ll7/scoomatic-hoverboard/README.md

# Scoomatic Hoverboard

* In [cad/](cad/) sind 3D Modelle des Scoomatics, sowie für Halterungen enthalten
* In [code/](code/) ist insbesondere der gesamte Code von ROS sowie Hoverboard Firmware und Arduino zu finden
* In [docs/](docs/) sind die Arbeiten bzw. die Dokumentationen der studentischen Arbeiten zufinden

Klonen des Repositories:

```bash
git clone --recurse-submodules https://git.rz.uni-augsburg.de/luttkule/scoomatic-hoverboard.git
```

Der Scoomatic‑Prototyp ist als modulare, softwaregestützte Mobilitätsplattform konzipiert, die die Basis eines selbstbalancierenden Fahrzeugs auf Hoverboard‑Technik demonstriert. Im Mittelpunkt steht die Verbindung aus robuster Hardware, sensorbasierter Regelung und einer klar strukturierten Steuerungslogik, um ein sicheres und nachvollziehbares Fahrverhalten zu ermöglichen.

Funktional zeigt der Prototyp vor allem drei Kernfähigkeiten: Stabilisierung, steuerbare Bewegung und Systemüberwachung. Die Stabilisierung sorgt dafür, dass das Fahrzeug Lastwechsel und kleine Störungen ausgleichen kann. Die Bewegungssteuerung erlaubt ein kontrolliertes Anfahren, Bremsen und Lenken im Rahmen der prototypischen Einsatzgrenzen. Ergänzend werden Betriebszustände des Systems erfasst, sodass Entwicklungs‑ und Testdaten für Optimierungsschritte verfügbar sind.

Ein weiterer Schwerpunkt ist die Entwicklungsfreundlichkeit. Der Scoomatic‑Prototyp ist so aufgebaut, dass Komponenten und Software iterativ weiterentwickelt werden können. Das unterstützt schnelle Tests, reproduzierbare Versuche und eine klare Trennung zwischen Basisfunktionen und experimentellen Erweiterungen. Dadurch eignet sich das Projekt sowohl als Technologie‑Demonstrator als auch als Grundlage für spätere Produktentscheidungen.

Aus Anwendersicht steht beim aktuellen Stand weniger die Endkunden‑Featuretiefe im Vordergrund, sondern die verlässliche technische Machbarkeit: Wie gut funktioniert das Zusammenspiel aus Antrieb, Regelung und Sicherheitsmechanismen unter realen Bedingungen? Genau hier liefert Scoomatic einen greifbaren Mehrwert, weil der Prototyp nicht nur theoretische Konzepte beschreibt, sondern sie praktisch erprobt.

Insgesamt präsentiert sich Scoomatic als fokussierter, praxisnaher Prototyp mit klarer Entwicklungsrichtung: ein intelligentes, balancierendes Mikromobilitäts‑System, das schrittweise von einer belastbaren technischen Basis zu einem ausgereiften Produkt weitergeführt werden kann.

## Martin Schörner @schoerma

*Bearbeitungszeitraum: 2018-12 bis 2019-05

Branch: master

Tag: MartinSchoernerFinal

[Seminararbeit Dokumentation](docs/seminar-ms/index.md)

[Projektmodul Dokumentation](docs/projektmodul-ms/index.md)

## Henri Chilla @chillahe

Bearbeitungszeitraum: 2019-11 bis 2020-03

Die von Henri verwendeten Branches beginnen mit hc:

Branch: hc/

[Bachelorarbeit Übersicht](docs/bachelor-hc/README.md)

[Dokumentation](docs/bachelor-hc/Documentation.md)

## Markus Keppeler @keppelma

Bearbeitungszeitraum: 2021-04 bis 2021-09

Der abschließende Stand befindet sich auf dem Branch *master*. \
Durch die Vielzahl an Änderungen wurden nicht mehr benötigte oder logisch doppelte Code- und Konfigurationdateien gelöscht. Der Stand vor den Anpassungen ist auf dem Branch *legacy/ros1* festgehalten.

[Dokumentation](docs/projektmodul-mk/README.md)
