ll7/scoomatic-hoverboard/docs/access_data.md

# Access data

## Jetson Board

**user data:**
- Host name: scoomatic-jetson
- User: scoomatic
- Password: nvidia

**VNC:**
- Password: scoomatic

## Raspberry Pi:

**user data:**
- Host name: ubuntu
- User: ubuntu
- Password: notubuntu

## Hotspot

- SSID: scoomatic-mobile
- No password required
