ll7/scoomatic-hoverboard/docs/bachelor-hc/BA-Präsentation-Henri-Chilla.pdf

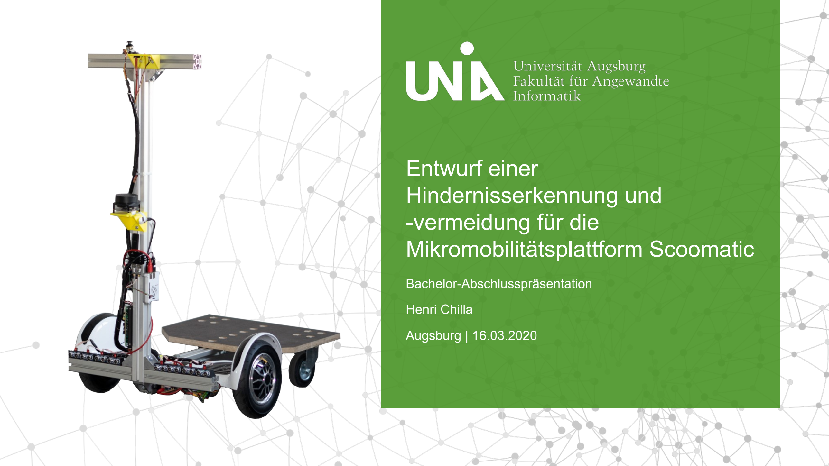
[picture p58: page 1]

## Entwurf einer Hindernisserkennung und -vermeidung für die Mikromobilitätsplattform Scoomatic

Bachelor-Abschlusspräsentation

Henri Chilla

Augsburg | 16.03.2020

## Agenda

### 1 Einleitung

### 2 Projektziel

### 3 Sensoren

### 4 SLAM

### 5 Lokalisierung und Navigation

### 6 Systemaufbau

### 7 Testing

### 8 Fazit

2 | 16.03.2020 | Bachelor Abschlusspräsentation Henri Chilla

### 9 Ausblick

## Einleitung

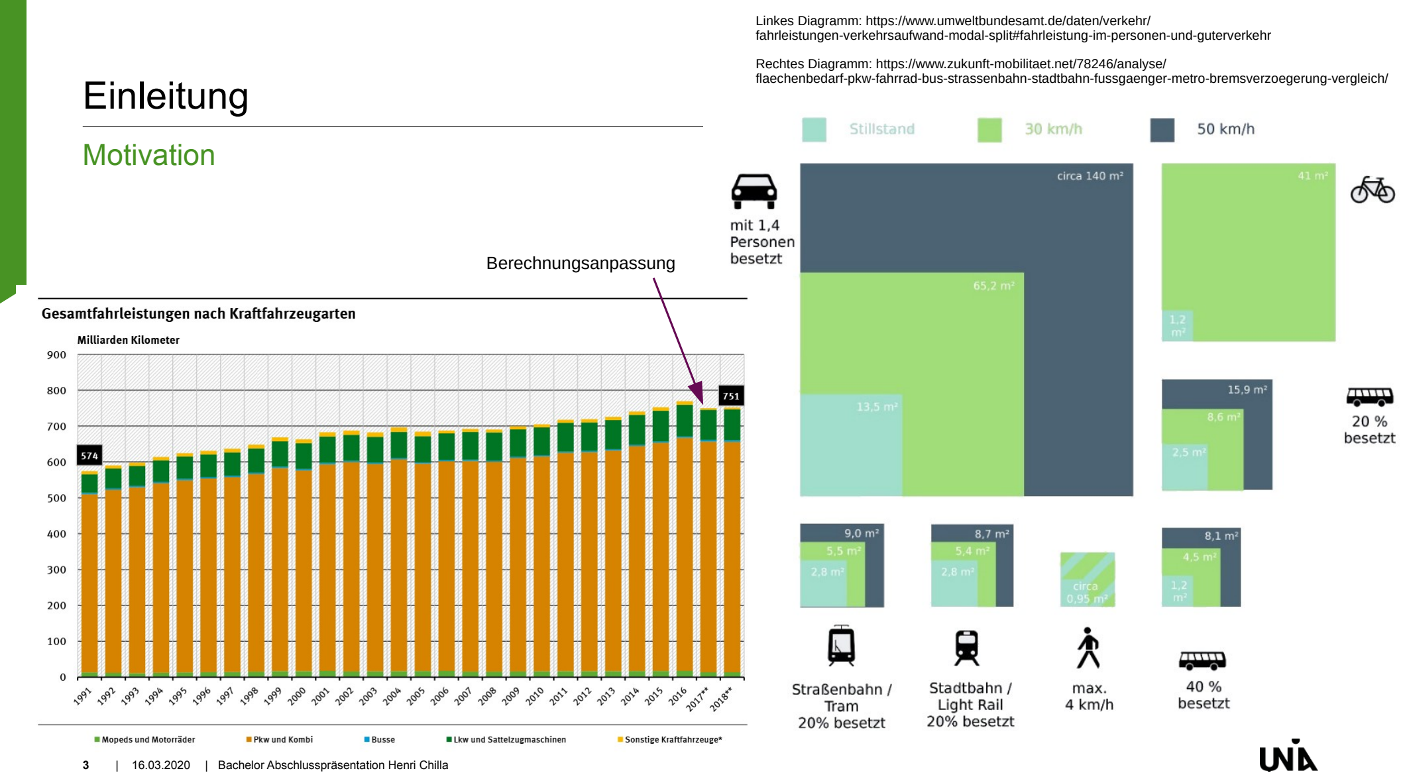
[picture p59: page 3]

Motivation

3 | 16.03.2020 | Bachelor Abschlusspräsentation Henri Chilla

Rechtes Diagramm: https://www.zukunft-mobilitaet.net/78246/analyse/flaechenbedarf-pkw-fahrrad-bus-strassenbahn-stadtbahn-fussgaenger-metro-bremsverzoegerung-vergleich/

Berechnungsanpassung

Linkes Diagramm: https://www.umweltbundesamt.de/daten/verkehr/fahrleistungen-verkehrsaufwand-modal-split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

## Einleitung

- Landflucht & Mobilität steigt in Deutschland
- Problematik des KFZ Verkehr
– | Verkehrsstau
– | Umweltverschmutzung
– | Flächenverbrauch
- Probleme mit E-Scootern und Verwandten Konzepte

Motivation

4 | 16.03.2020 | Bachelor Abschlusspräsentation Henri Chilla

## Einleitung

Motivation

5 | 16.03.2020 | Bachelor Abschlusspräsentation Henri Chilla

# Lösung:

# Die Mikromobilitäts Plattform Scoomatic

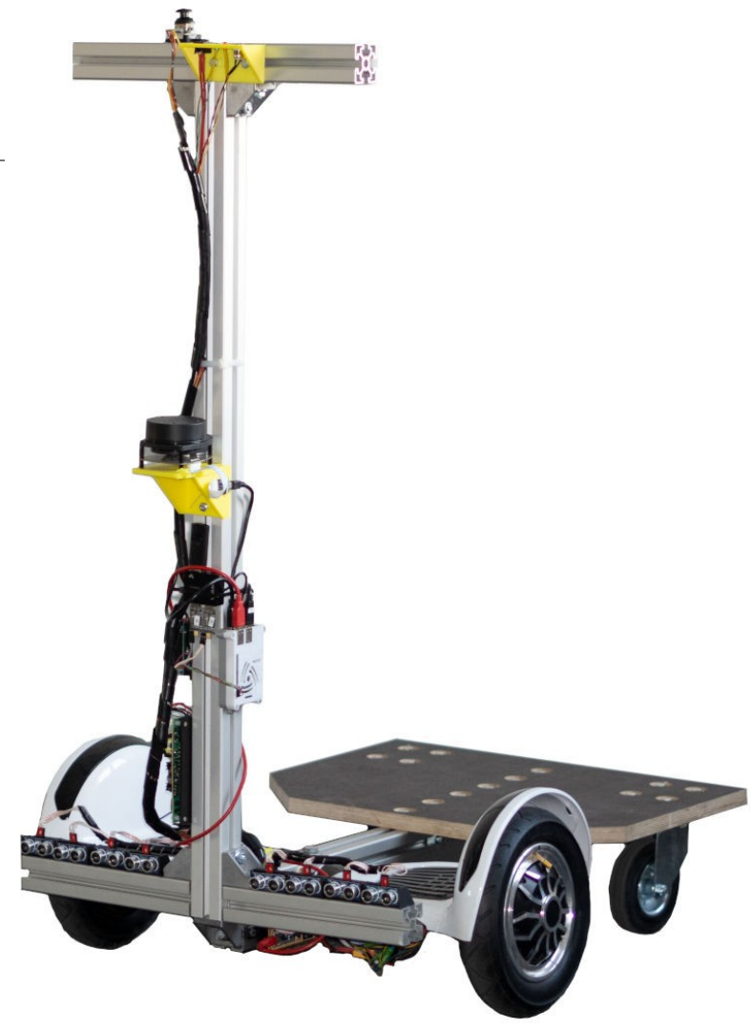
[picture p60: figure]

## Projektziel

- Umgebautes Hoverboard und alternativer Firmware
- Umgebungssensoren
- Raspberry Pi 3B
- Mit Ubuntu 18.04 & ROS1 Melodic und ROS2 Crystal
- ROS1 und ROS2 parallel mit ROS Bridge
- Steuerung mit Gamepad und Joystick möglich

Ausgangslage

6 | 16.03.2020 | Bachelor Abschlusspräsentation Henri Chilla

## Projektziel

- Bestehende Softwarearchitektur vollständig auf ROS1 umbauen
- Vorhandene Sensoren zur gleichzeitigen Lokalisierung und Kartengenerierung verwenden
- Wegpunkte in Karte abfahren
- Hindernisse erkennen und vermeiden
7 | 16.03.2020 | Bachelor Abschlusspräsentation Henri Chilla

## Projektziel

1. SLAM Kartenerstellung
2. Fahrzeug in Karte Lokalisieren
3. Ziel-Punkt festlegen
4. Fahrzeug fährt zu Ziel-Punkt
8 | 16.03.2020 | Bachelor Abschlusspräsentation Henri Chilla

Verwendungsvorgang

## Sensoren

- Steuerung
- Gamepad EasySMX 2.4Ghz Controller
- Joystick
- Raumdaten
- 8 Ultraschall Sensoren HC-SR04 (2cm bis 3m & bis zu 50 Samples/s)
- 2D LIDAR RPLidar A1 (bis zu 10 U/s, bis zu 8000 Samples)
- IMU MPU9250 (9DOF)
- GPS Ublox SAM-M8Q
- Motor-/Hoverboarddaten
- Odometrie
- (Diagnose Daten)

Verfügbare

9 | 16.03.2020 | Bachelor Abschlusspräsentation Henri Chilla

## Sensoren

- Steuerung
- Gamepad
- Joystick
- Raumdaten
- 8 Ultraschall Sensoren
- 2D LIDAR
- IMU
- GPS
- Motor-/Hoverboarddaten
- Odometrie
- (Diagnose Daten)

Verwendete

10 | 16.03.2020 | Bachelor Abschlusspräsentation Henri Chilla

## SLAM

11 | 16.03.2020 | Bachelor Abschlusspräsentation Henri Chilla

Begriffsbedeutung

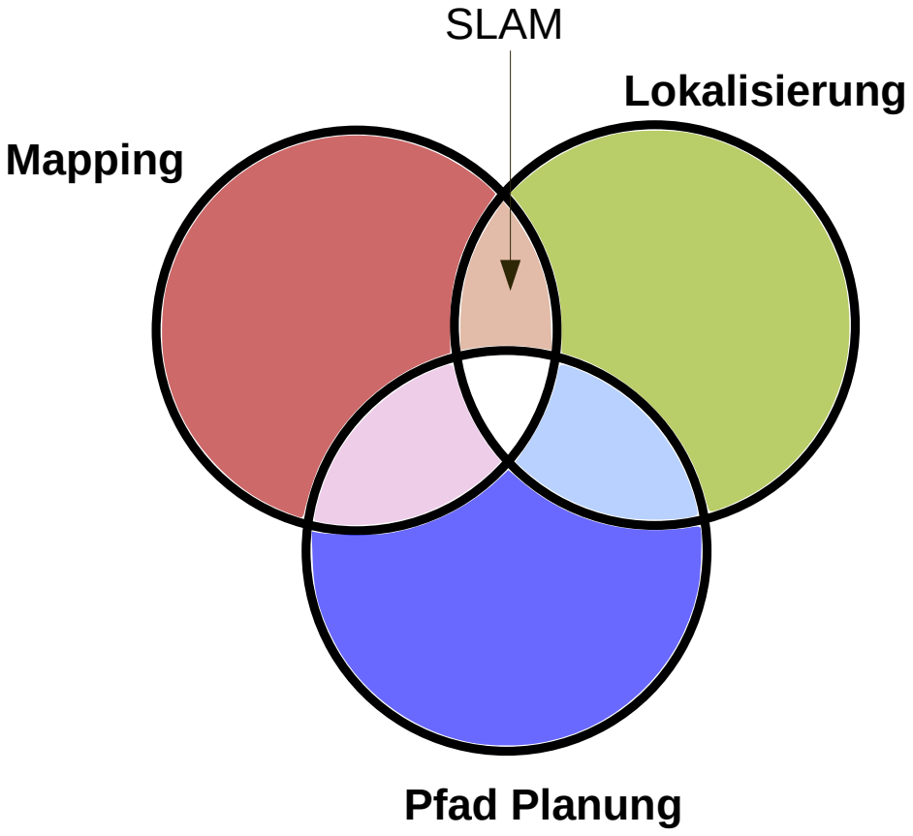
[picture p61: figure]
Mapping; Lokalisierung; Pfad Planung; SLAM

- Simultaneous Localization and Mapping
- Problem:

– Lokalisierung und Karte sind unbekannt
- Inkrementelle Kartenerstellung

## P(mt+ 1

, xt+1∣o1: t+1

,u1 :t
)
Karte | Zustand | Beobachtung | Kommando

## SLAM

- hector_slam
- gmapping
- cartographer

●

tiny_slam
- ohm_tsd_slam
- mrpt_icp_slam_2d
- mrpt_rbpf_slam
- mrpt_graphslam_2d
- mrpt_ekf_slam_2d
- orb_slam2_ros
- slam_karto

●

Verfügbare ROS Packages

12 | 16.03.2020 | Bachelor Abschlusspräsentation Henri Chilla

## SLAM

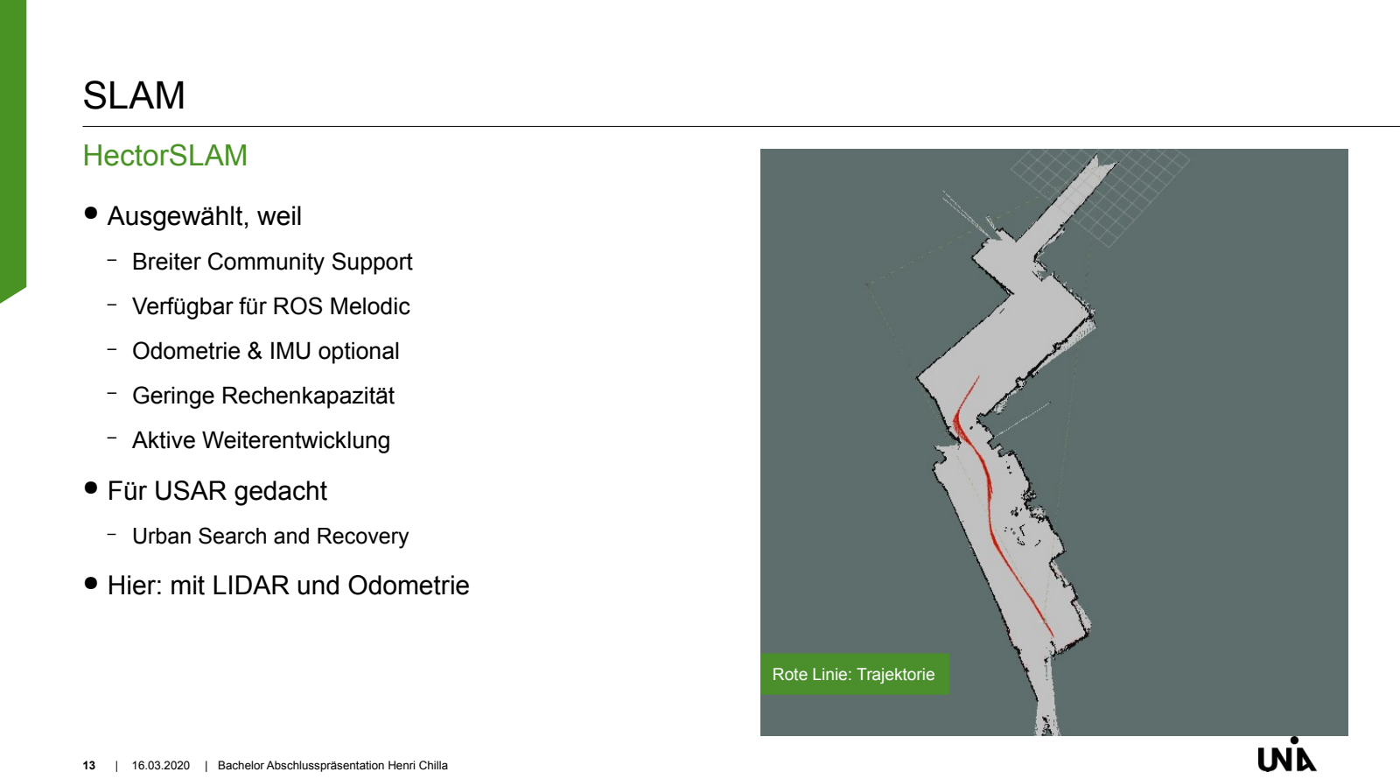
[picture p62: page 13]

- Ausgewählt, weil

– Breiter Community Support – Verfügbar für ROS Melodic – Odometrie & IMU optional – Geringe Rechenkapazität
– Aktive Weiterentwicklung
- Für USAR gedacht

– Urban Search and Recovery
- Hier: mit LIDAR und Odometrie
13 | 16.03.2020 | Bachelor Abschlusspräsentation Henri Chilla

Rote Linie: Trajektorie

HectorSLAM

## Lokalisierung und Navigation

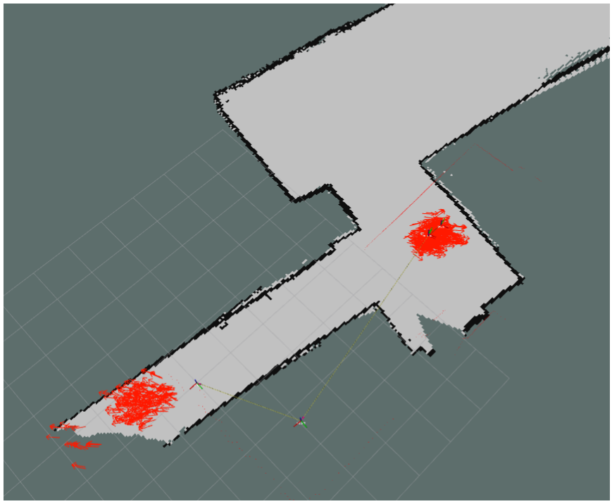
[picture p63: figure]

- AMCL zusammen mit Navigation Stack (move_base)
– | De facto Standard
– | Nutzt LIDAR und Odometrie
- AMCL
– | Adaptive Monte Carlo Lokalisierung
| → Partikelfilter

Lokalisierung

14 | 16.03.2020 | Bachelor Abschlusspräsentation Henri Chilla

## Lokalisierung und Navigation

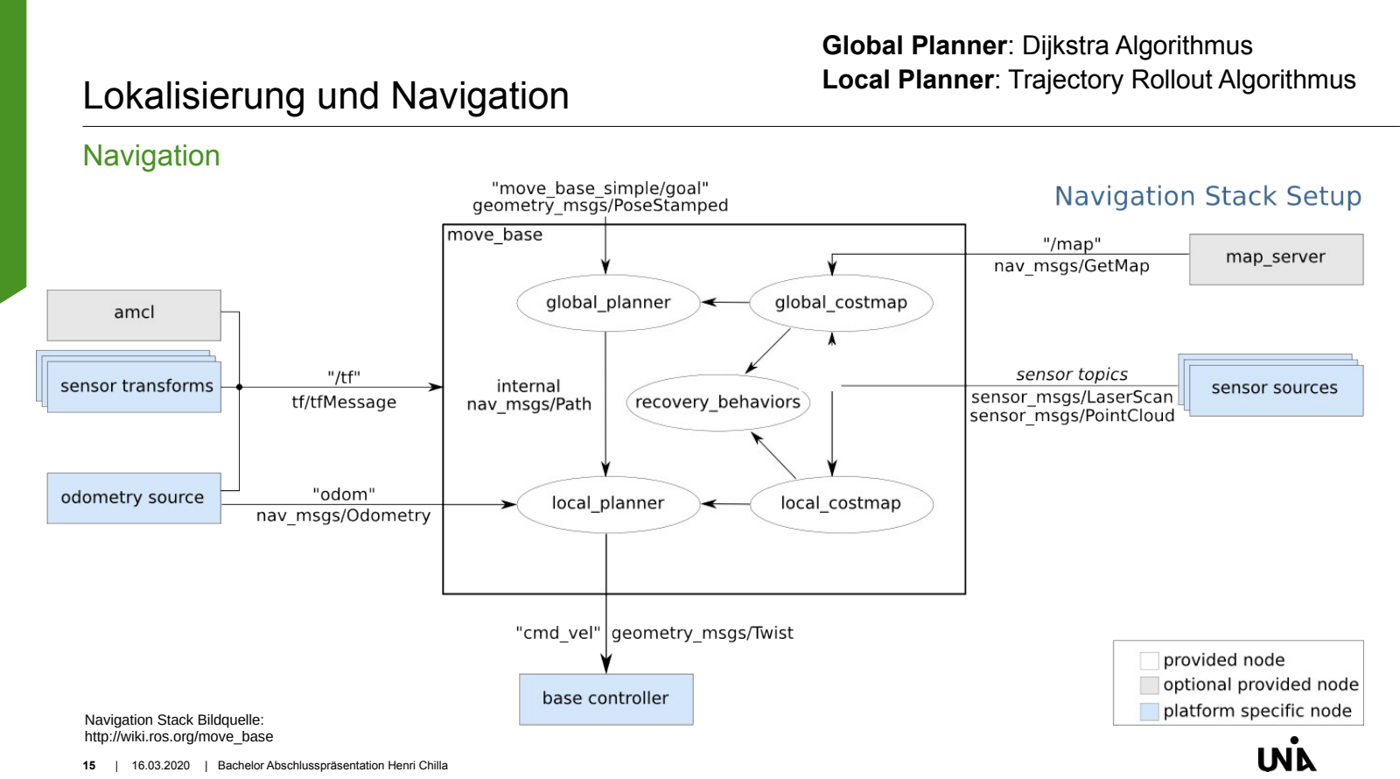
[picture p64: page 15]

Navigation

15 | 16.03.2020 | Bachelor Abschlusspräsentation Henri Chilla

Navigation Stack Bildquelle: http://wiki.ros.org/move_base

Global Planner: Dijkstra Algorithmus
Local Planner: Trajectory Rollout Algorithmus

## Lokalisierung und Navigation

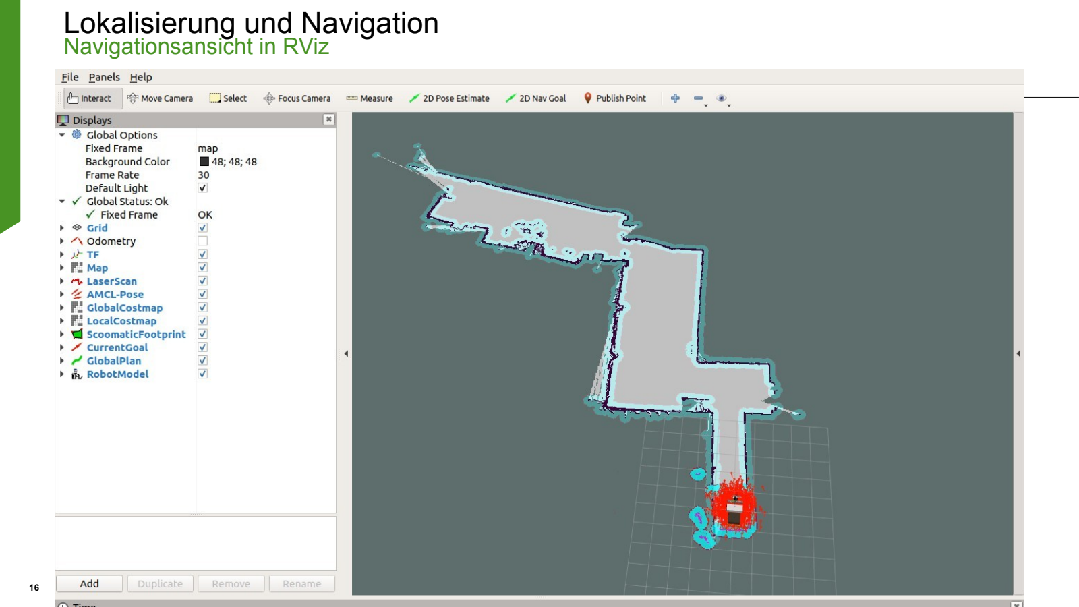
[picture p65: page 16]

Navigationsansicht in RViz

16 | 16.03.2020 | Bachelor Abschlusspräsentation Henri Chilla

## Systemaufbau

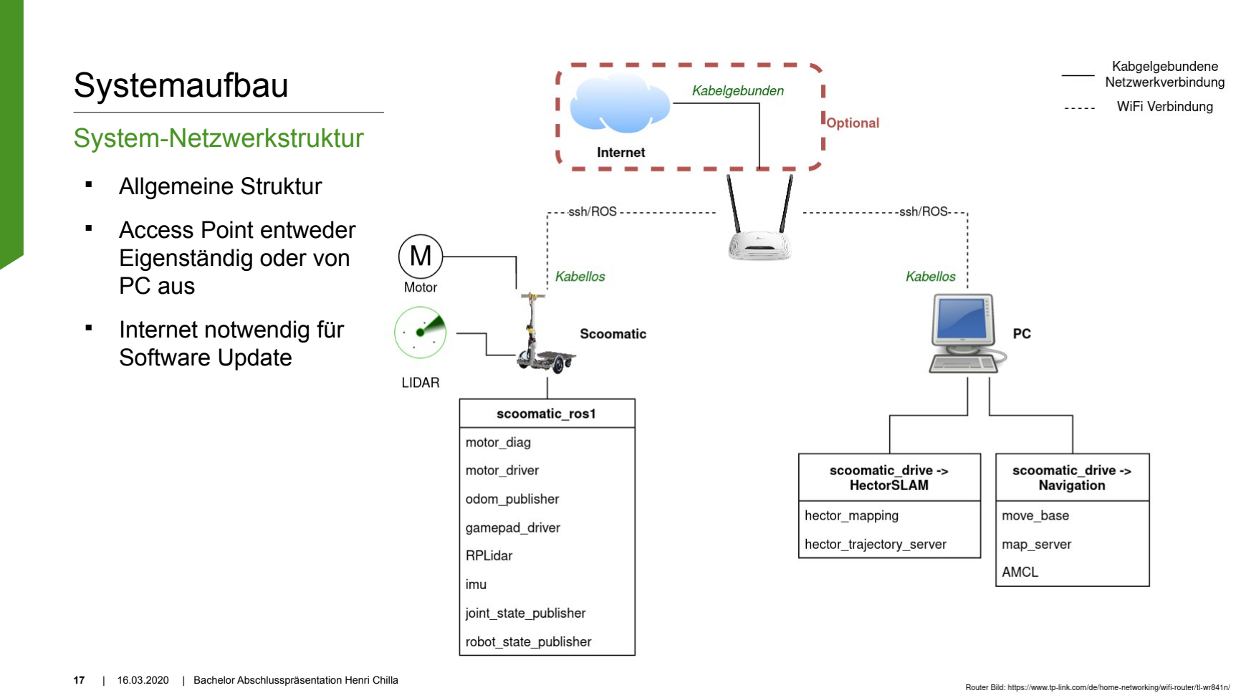
[picture p66: page 17]

System-Netzwerkstruktur

17 | 16.03.2020
- Allgemeine Struktur
- Access Point entweder
Eigenständig oder von
PC aus

Internet notwendig für
Software Update

| Bachelor Abschlusspräsentation Henri Chilla

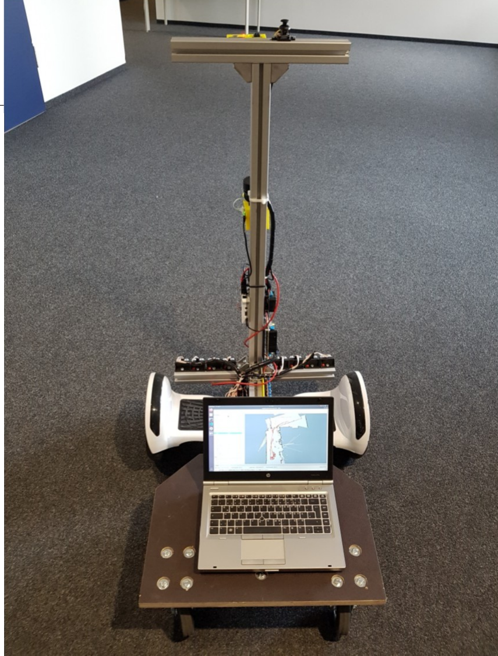
[picture p67: figure]

## Systemaufbau

Realer Aufbau

18 | 16.03.2020 | Bachelor Abschlusspräsentation Henri Chilla
- WLAN Hotspot (Access Point) läuft auf Laptop
- Vollständig mobil
- Gamepad Steuerung bzw. autonome Navigation

## Systemaufbau

ROS Nodes und Topics bei Navigation

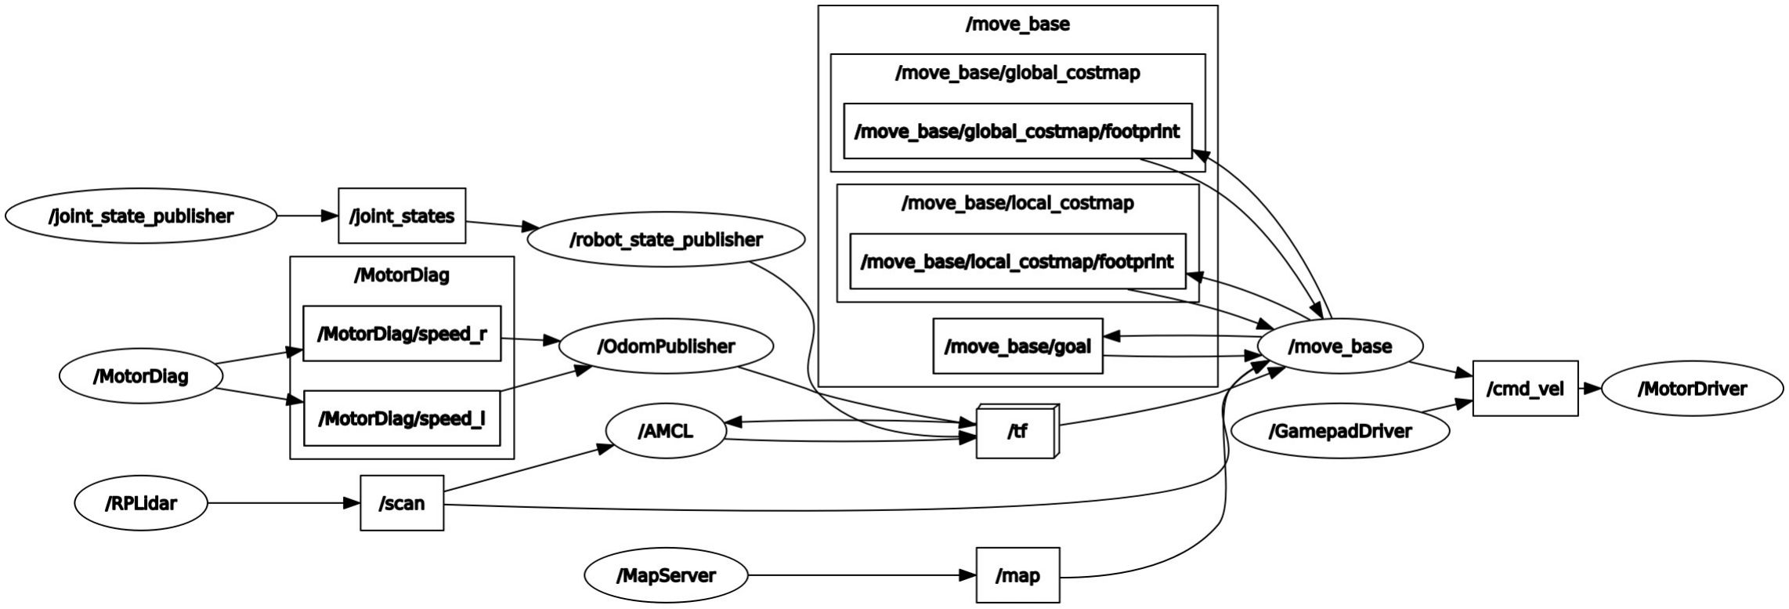
[picture p68: figure]

19 | 16.03.2020 | Bachelor Abschlusspräsentation Henri Chilla

## Testing

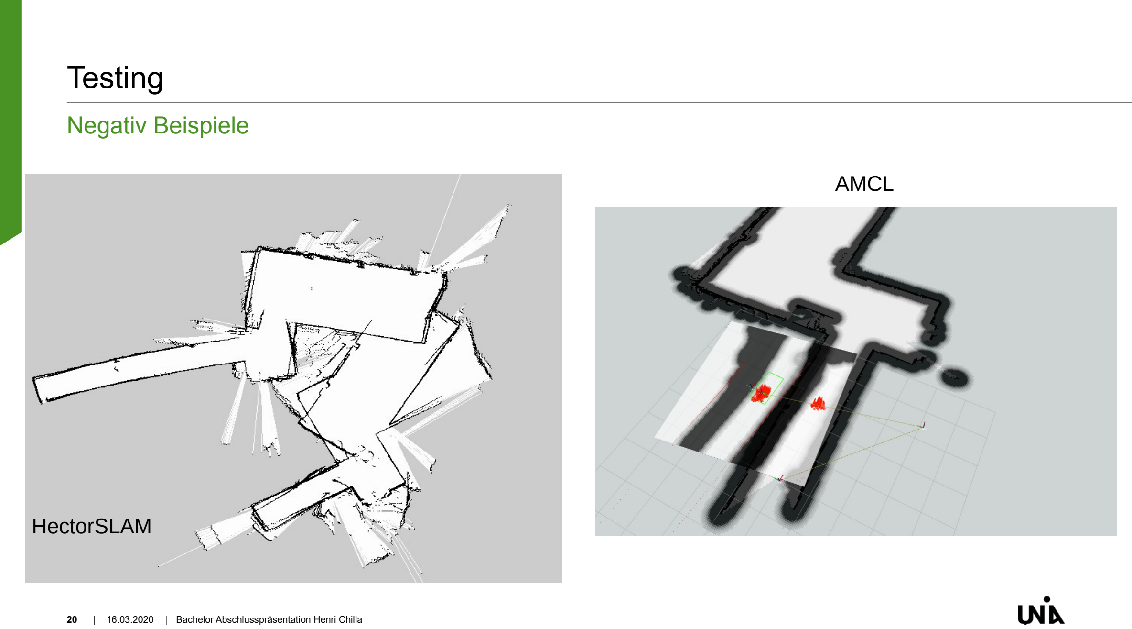
[picture p69: page 20]

Negativ Beispiele

20 | 16.03.2020 | Bachelor Abschlusspräsentation Henri Chilla

AMCL

HectorSLAM

## Testing

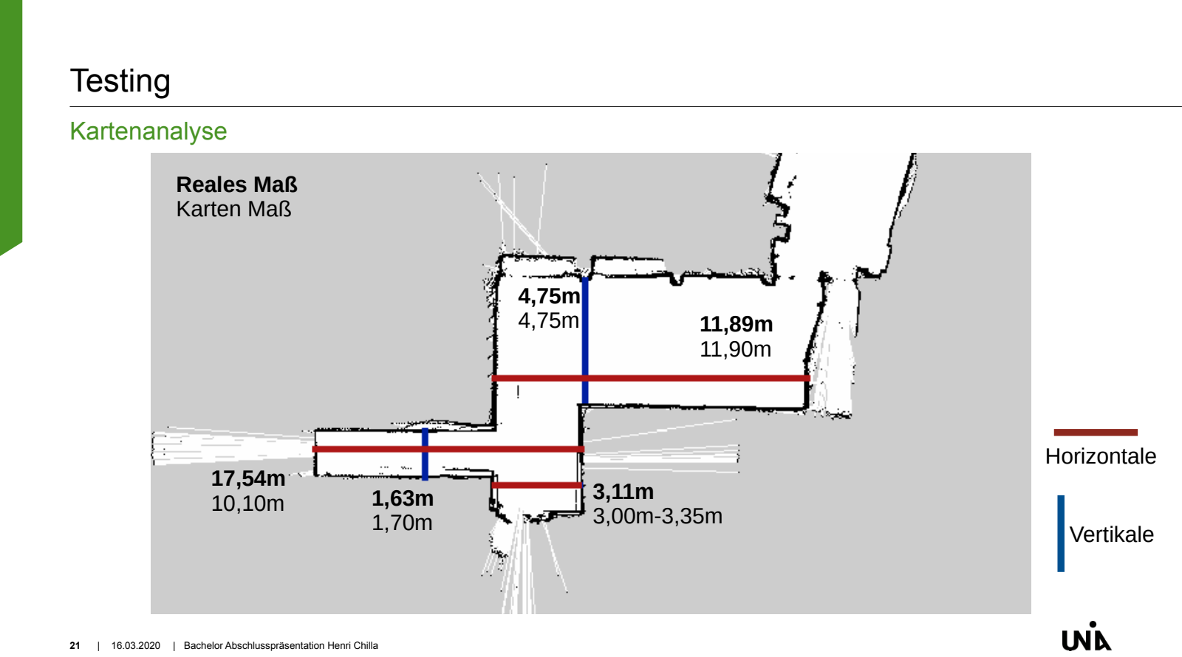
[picture p70: page 21]

Kartenanalyse

21 | 16.03.2020 | Bachelor Abschlusspräsentation Henri Chilla

1,63m
1,70m

17,54m
10,10m | 3,11m
| 3,00m-3,35m

4,75m
4,75m | 11,89m
| 11,90m

Reales Maß
Karten Maß

Horizontale

Vertikale

## Fazit

Erreichte Ziele

- ROS1 Migration
- SLAM Kartenerstellung
- AMCL Lokalisierung
- ROS Navigation

●

„Odometrie“-Bereitstellung von Motor

22 | 16.03.2020 | Bachelor Abschlusspräsentation Henri Chilla

Bestehende Probleme

- HectorSLAM ungeeignet
– | 2D SLAM
– | Für kleine Umgebungen
– | Kein Loop Closure
– | Karte nachträglich nicht erweiterbar
– | Glastür-Problematik
- Rechenleistung
- Outdoor Fähigkeiten
– | LIDAR Range gering (12m)
– | GPS noch nicht funktionsfähig
- Motor „Odometrie“

●

IMU Daten Bereitstellung
- Sicherheit (Notstopp)

## Ausblick

- Bessere Rechenleistung → z.B. Nvidia Jetson
- RGBD Kamera → Visual SLAM
- 3D LIDAR → 3D SLAM
- Automatisches SLAM → Exploration
- Motor Geschwindigkeits-Regelung
- Odometrie Alternative → Wheel Encoder o.ä.
23 | 16.03.2020 | Bachelor Abschlusspräsentation Henri Chilla

Verbesserungsvorschläge

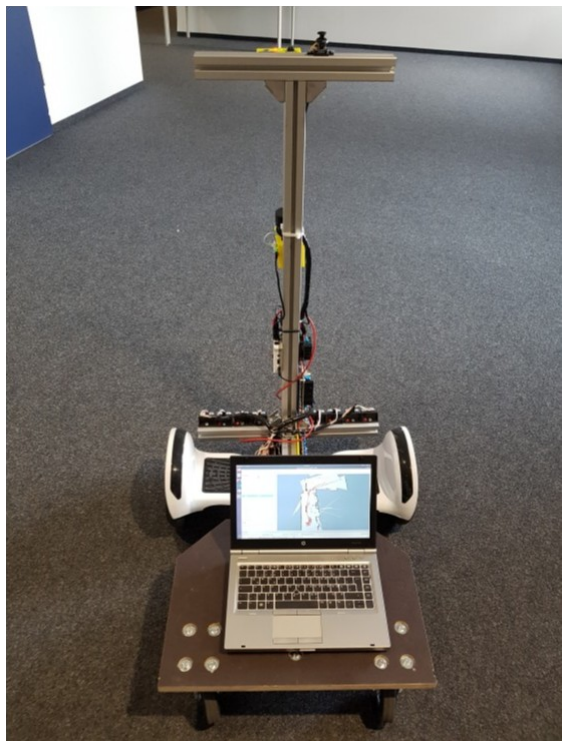
[picture p71: figure]

Henri Chilla
Lehrstuhl für Mechatronik
Universität Augsburg
henri.chilla@student.uni-augsburg.de

Vielen Dank
für Ihre Aufmerksamkeit
