ll7/scoomatic-hoverboard/docs/bachelor-hc/images/amcl-alignment1.png

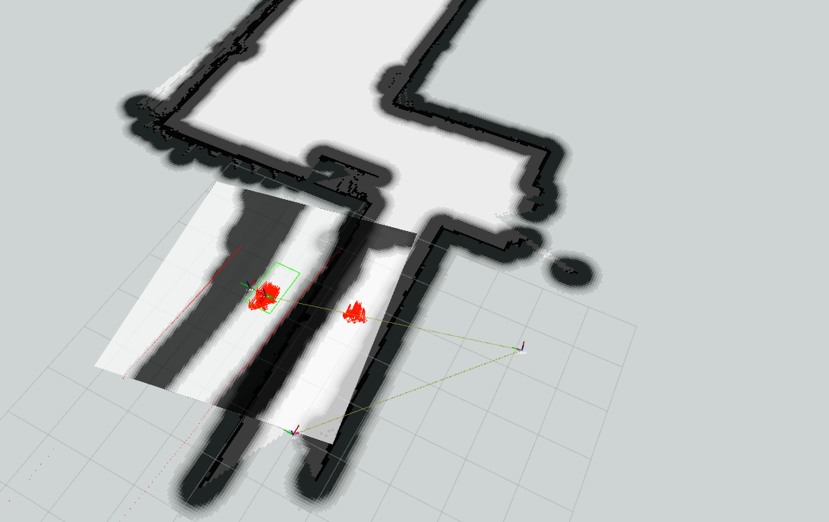
docs/bachelor-hc/images/amcl-alignment1.png
