ll7/scoomatic-hoverboard/docs/bachelor-hc/images/amcl-alignment2.png

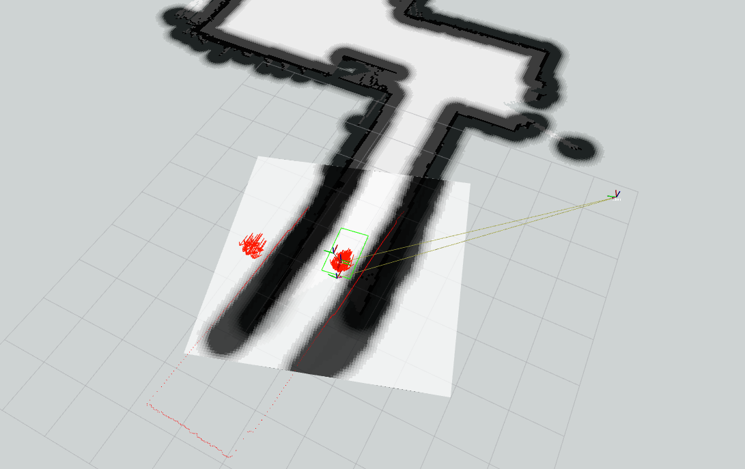
docs/bachelor-hc/images/amcl-alignment2.png
