ll7/scoomatic-hoverboard/docs/bachelor-hc/images/amcl-bad-example2.png

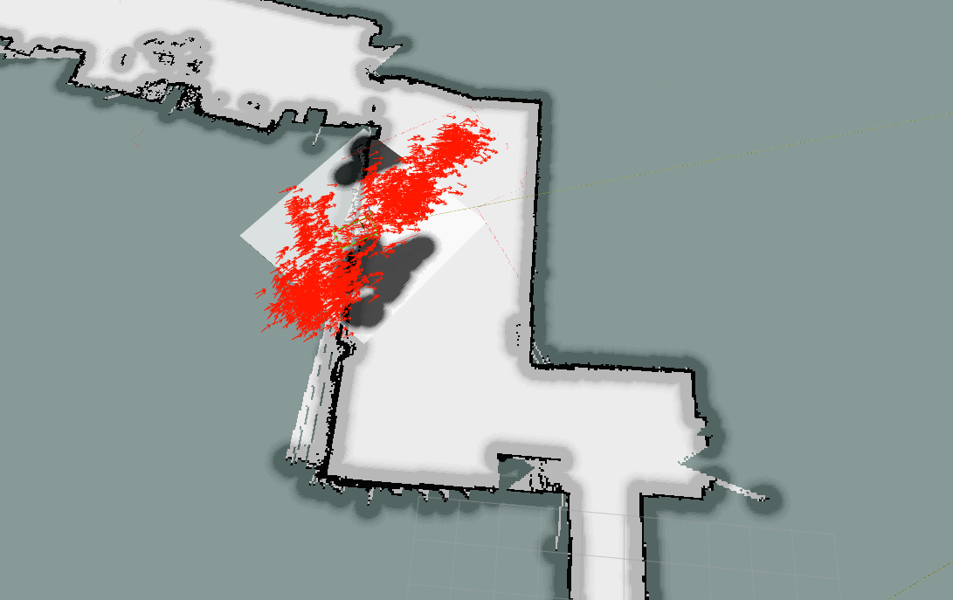
docs/bachelor-hc/images/amcl-bad-example2.png
