ll7/scoomatic-hoverboard/docs/bachelor-hc/images/amcl-bad-example.png

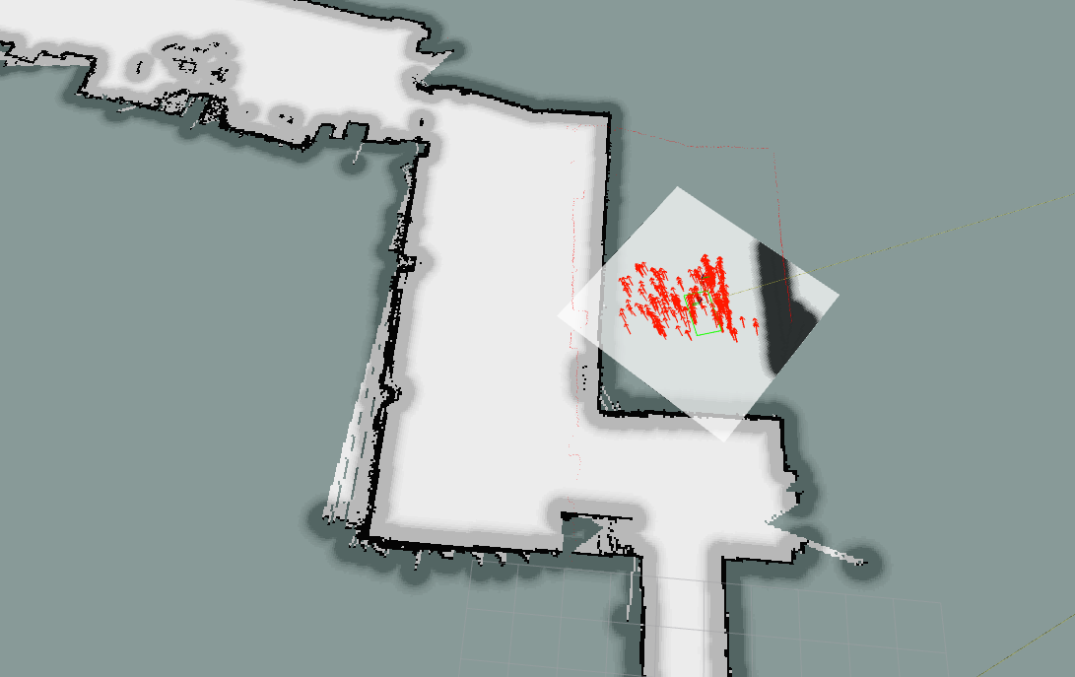
docs/bachelor-hc/images/amcl-bad-example.png
