ll7/scoomatic-hoverboard/docs/bachelor-hc/images/amcl-buero.png

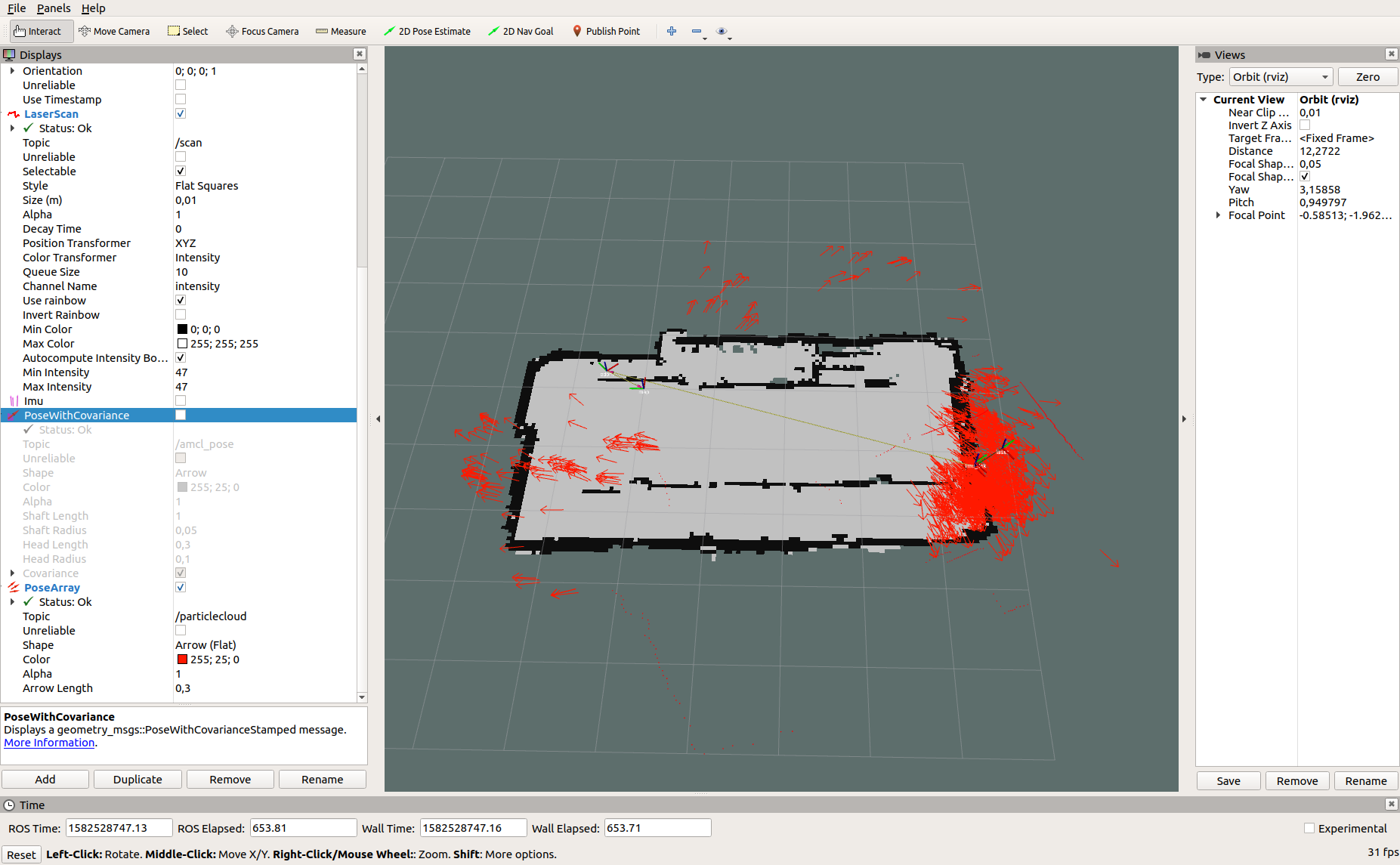
docs/bachelor-hc/images/amcl-buero.png
