ll7/scoomatic-hoverboard/docs/bachelor-hc/images/amcl-local-costmap-example.png

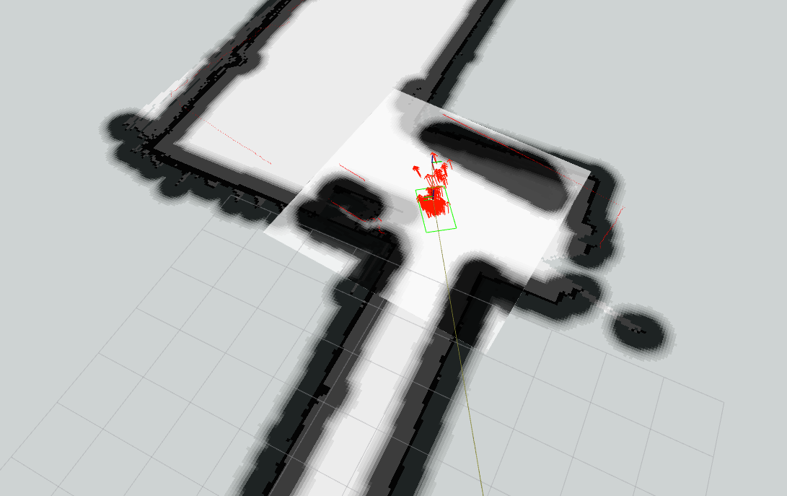
docs/bachelor-hc/images/amcl-local-costmap-example.png
