ll7/scoomatic-hoverboard/docs/bachelor-hc/images/amcl-local-costmap-person.png

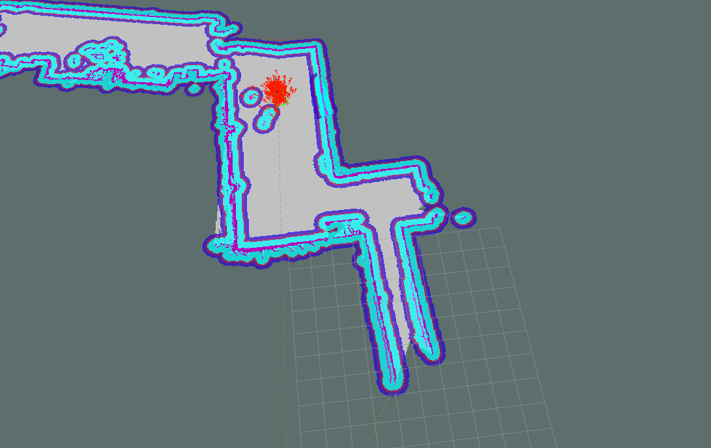
docs/bachelor-hc/images/amcl-local-costmap-person.png
