ll7/scoomatic-hoverboard/docs/bachelor-hc/images/amcl-room.png

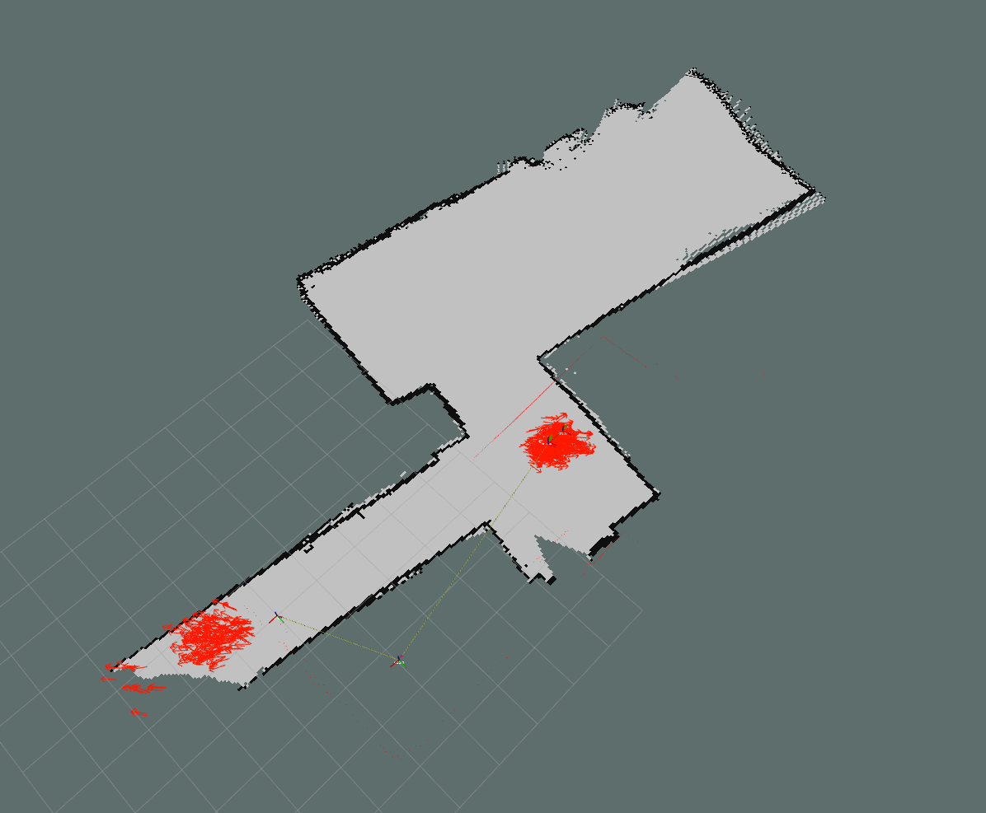
docs/bachelor-hc/images/amcl-room.png
