ll7/scoomatic-hoverboard/docs/bachelor-hc/images/amcl-rooms-alpha2.png

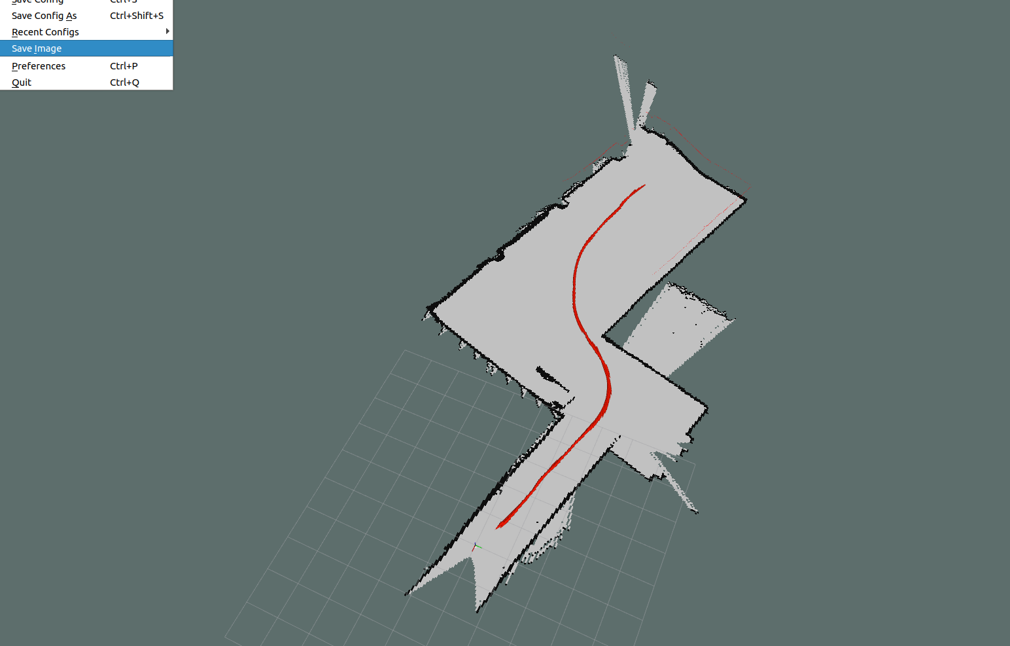
docs/bachelor-hc/images/amcl-rooms-alpha2.png
