ll7/scoomatic-hoverboard/docs/bachelor-hc/images/hector-slam-bad-example.png

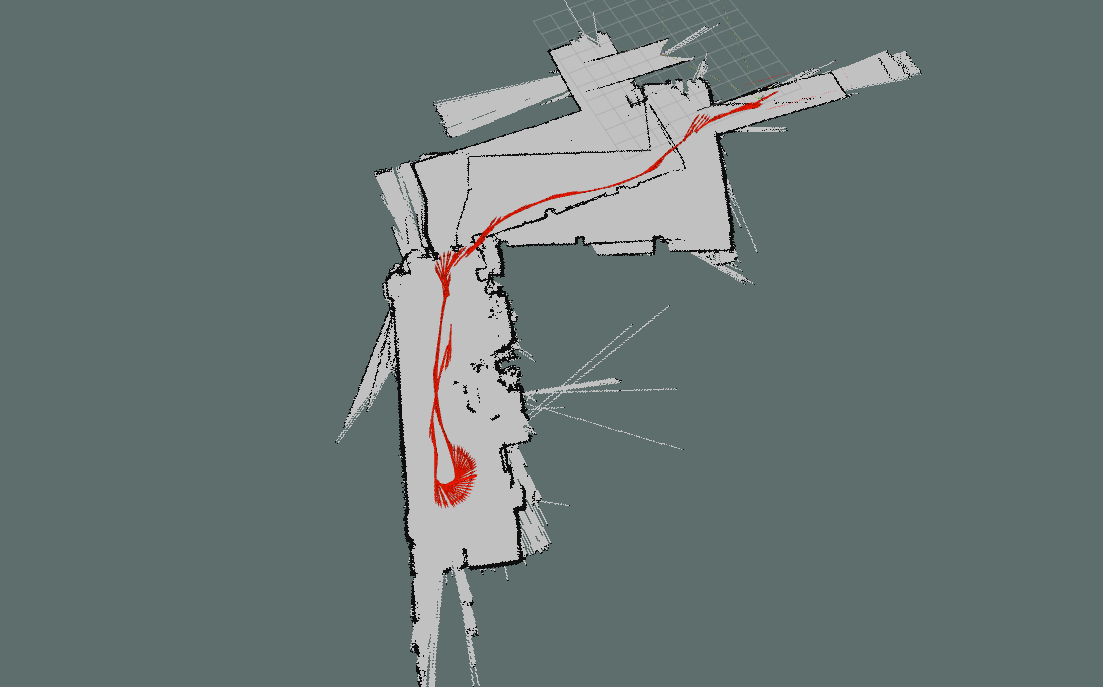
docs/bachelor-hc/images/hector-slam-bad-example.png
