ll7/scoomatic-hoverboard/docs/bachelor-hc/images/hector-slam-good-example-map.png

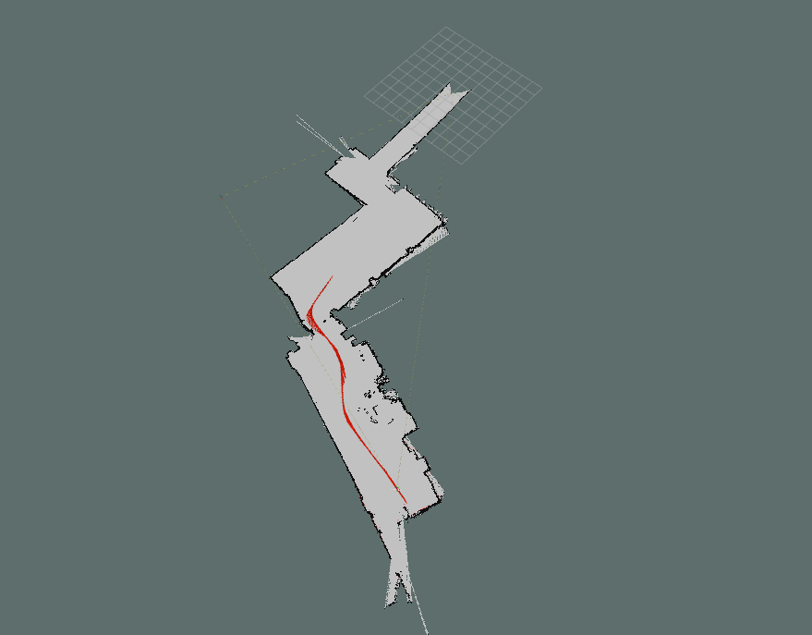
docs/bachelor-hc/images/hector-slam-good-example-map.png
