ll7/scoomatic-hoverboard/docs/bachelor-hc/images/hector-slam-map-example.png

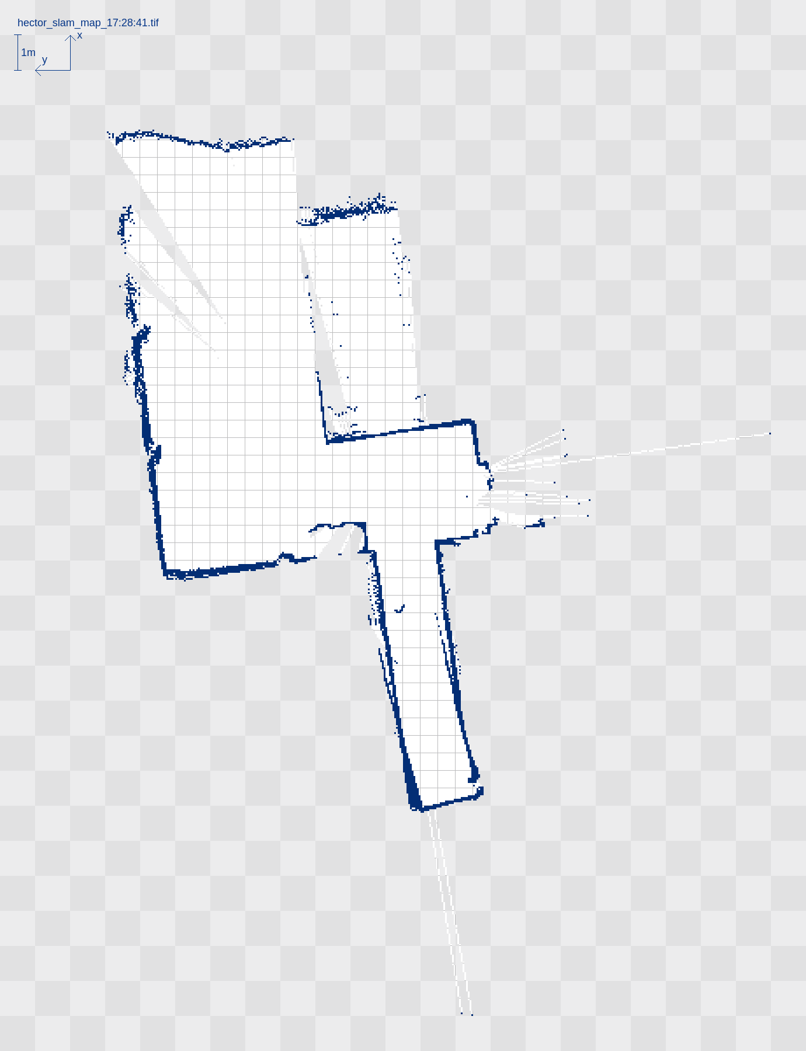
docs/bachelor-hc/images/hector-slam-map-example.png
