ll7/scoomatic-hoverboard/docs/bachelor-hc/images/hector-slam-trajectory-bad.png

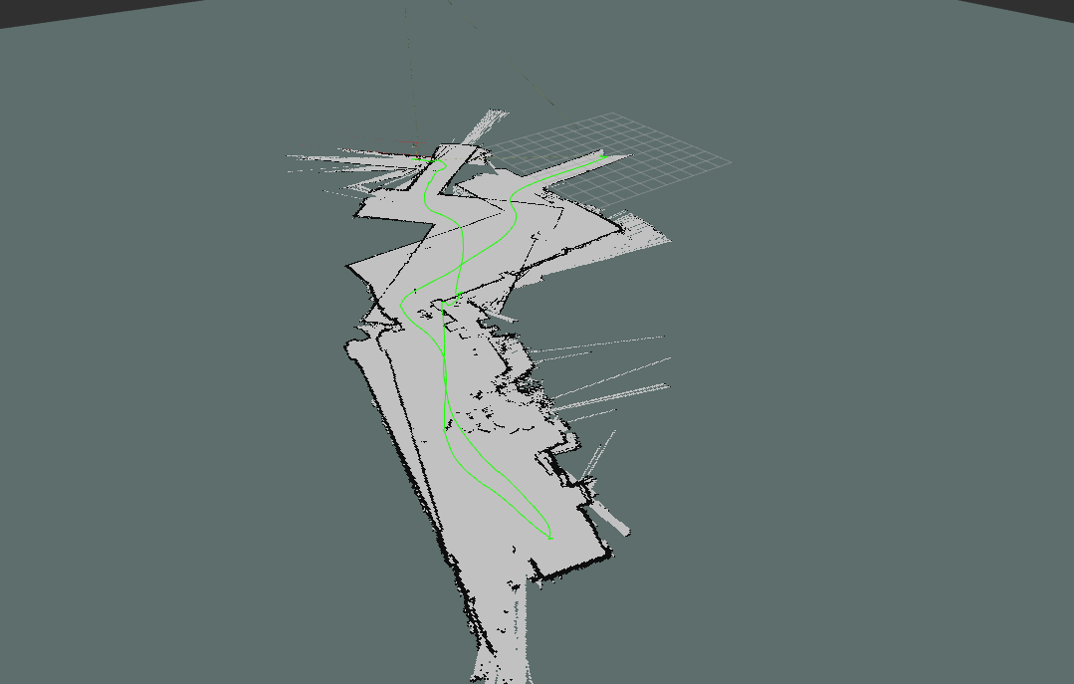
docs/bachelor-hc/images/hector-slam-trajectory-bad.png
