ll7/scoomatic-hoverboard/docs/bachelor-hc/images/rqt_ang_velocity_visualization.png

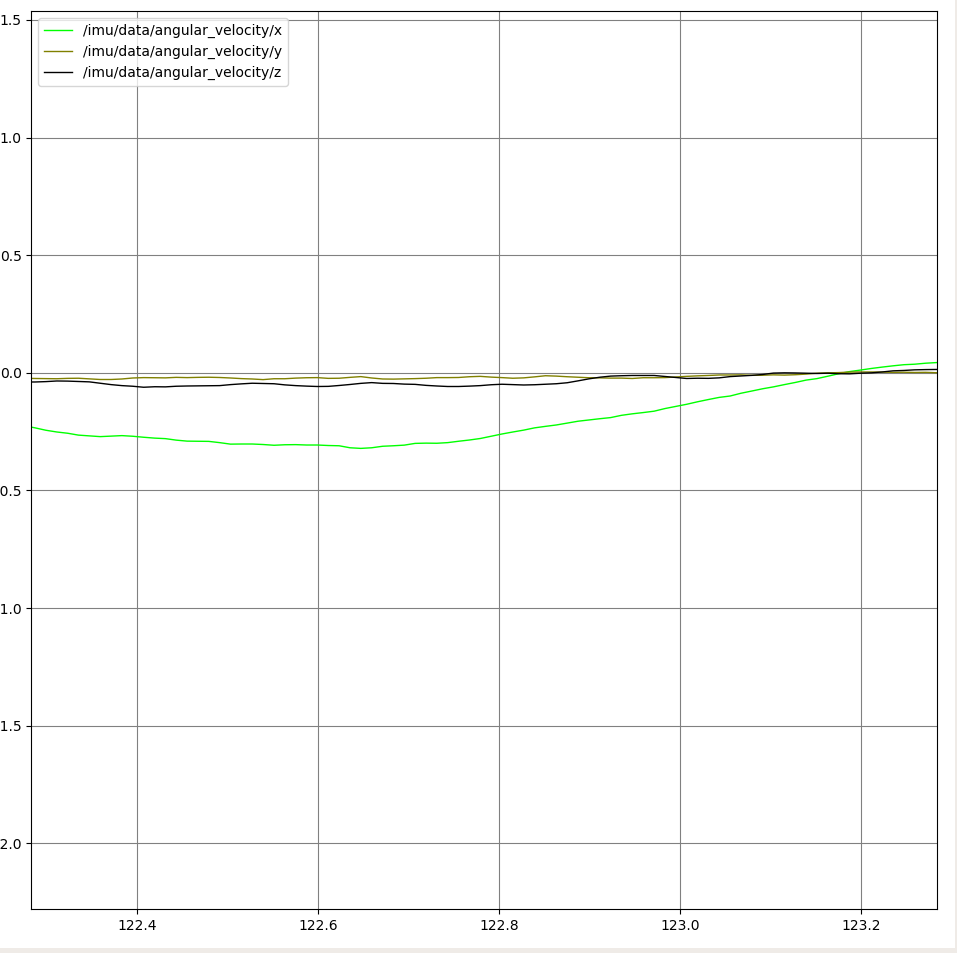
docs/bachelor-hc/images/rqt_ang_velocity_visualization.png
