ll7/scoomatic-hoverboard/docs/bachelor-hc/images/rqt_imu_data_correct visualization.png

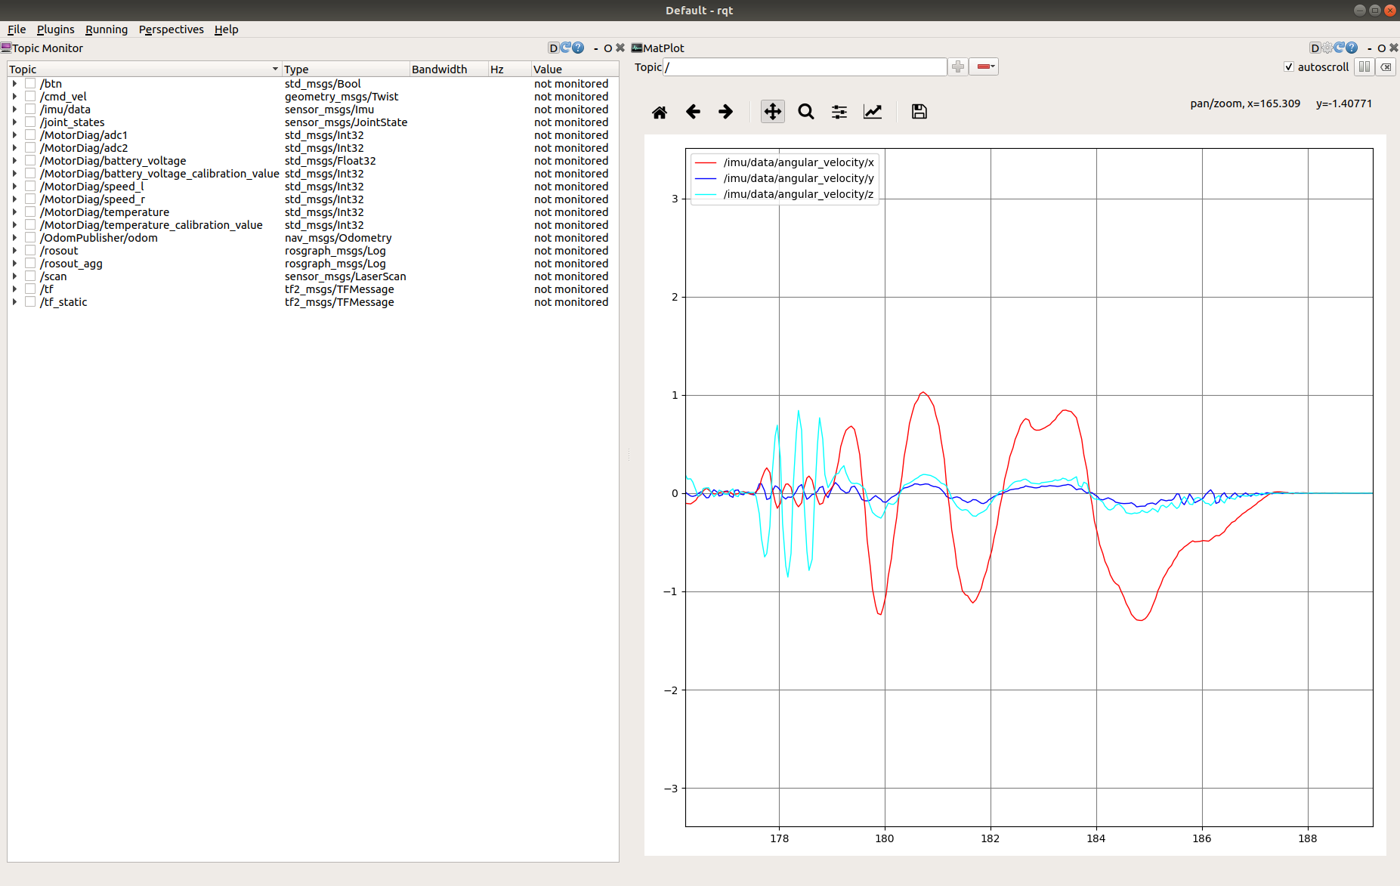
docs/bachelor-hc/images/rqt_imu_data_correct visualization.png
