ll7/scoomatic-hoverboard/docs/bachelor-hc/images/rqt_imu_orientation_visualization.png

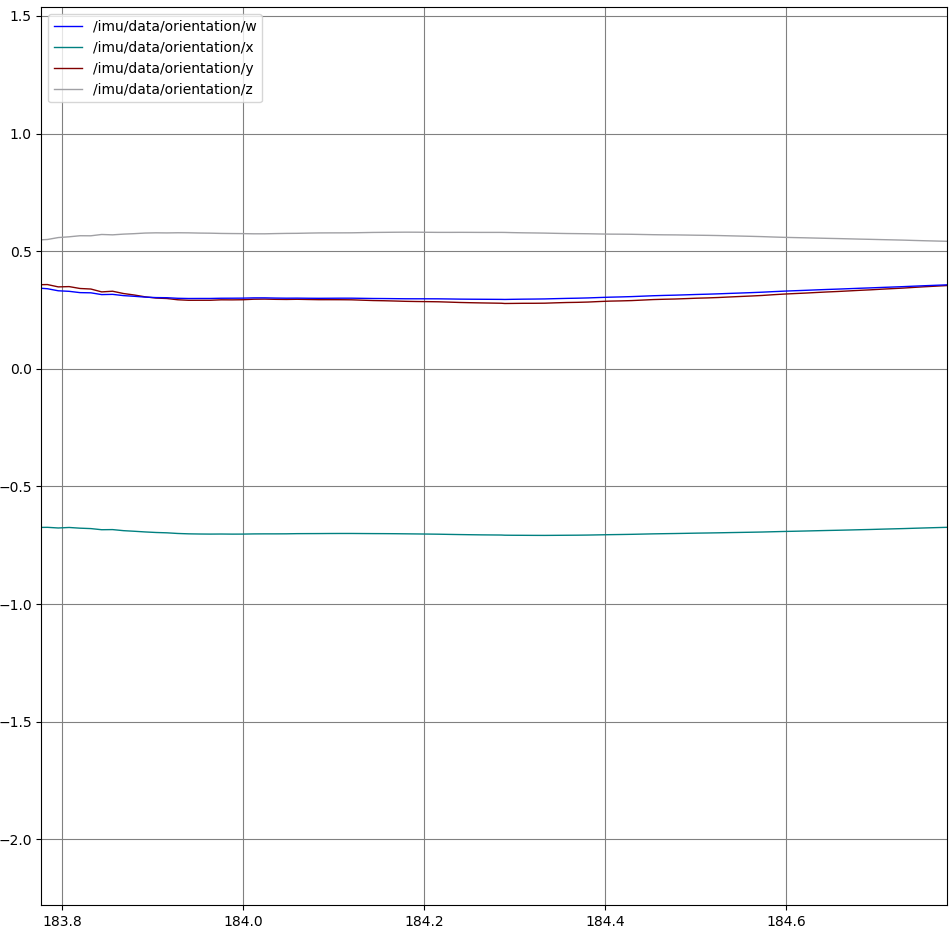
docs/bachelor-hc/images/rqt_imu_orientation_visualization.png
