ll7/scoomatic-hoverboard/docs/bachelor-hc/images/topics-with-amcl.png

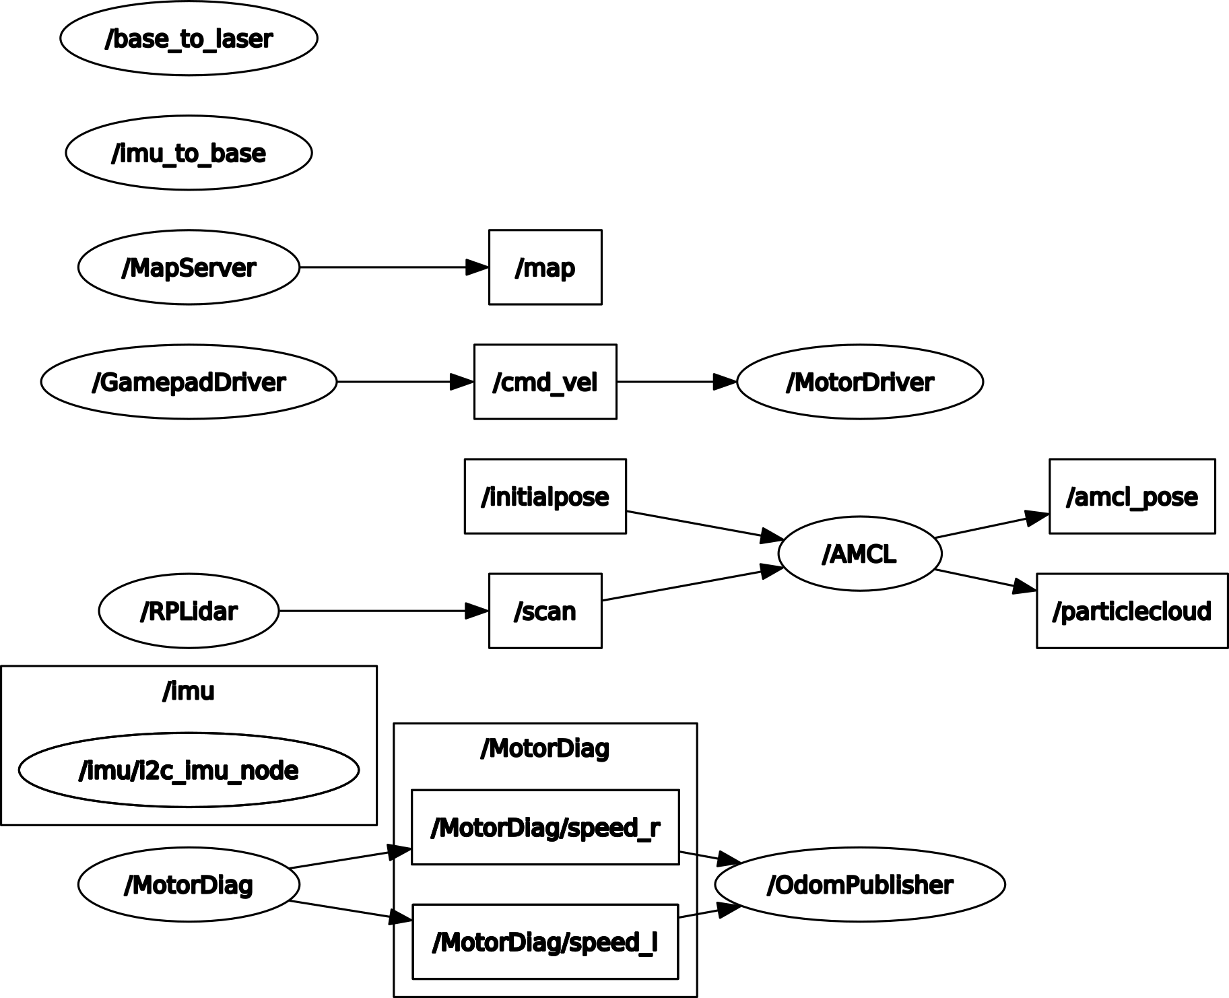
docs/bachelor-hc/images/topics-with-amcl.png
