ll7/scoomatic-hoverboard/docs/projektmodul-mk/img/auxillary_spannungsversorgung.jpg

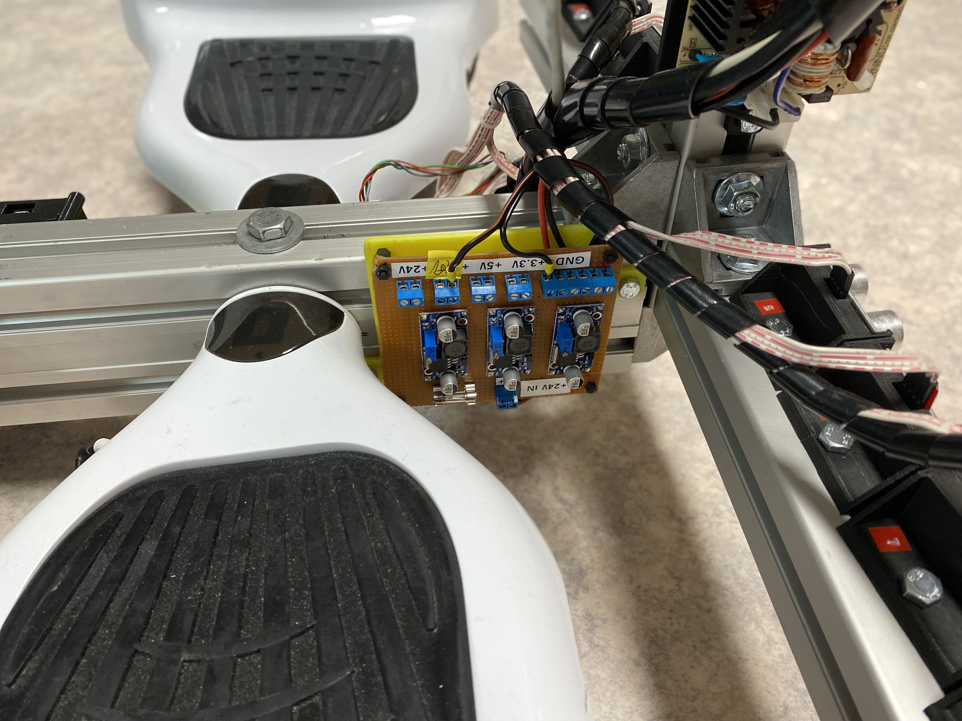
docs/projektmodul-mk/img/auxillary_spannungsversorgung.jpg
