ll7/scoomatic-hoverboard/docs/projektmodul-mk/img/bedienpanel.jpg

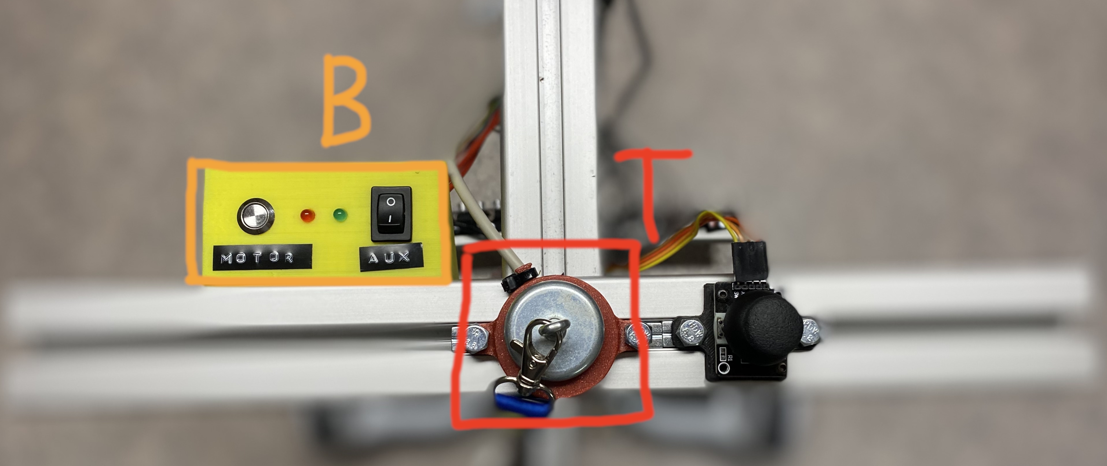
docs/projektmodul-mk/img/bedienpanel.jpg
