ll7/scoomatic-hoverboard/docs/projektmodul-mk/img/logic_structure.png

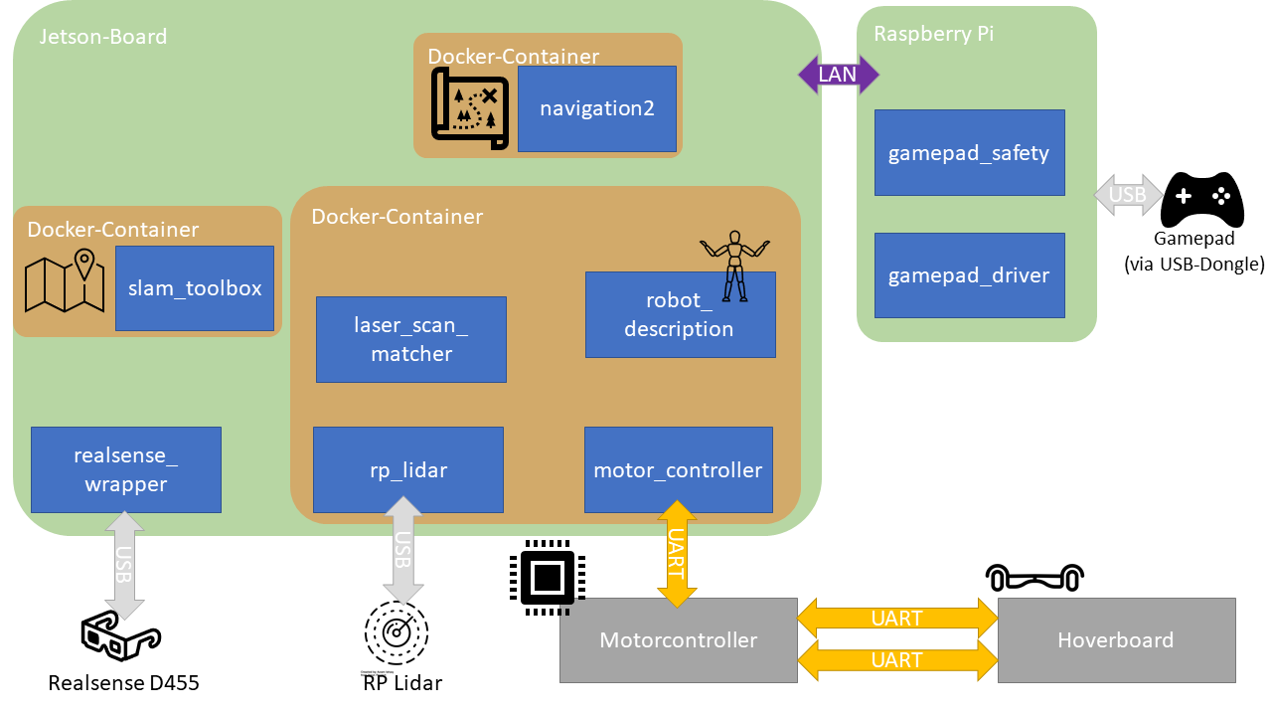
docs/projektmodul-mk/img/logic_structure.png
