ll7/scoomatic-hoverboard/docs/projektmodul-mk/img/motor_controller_anschluss.jpg

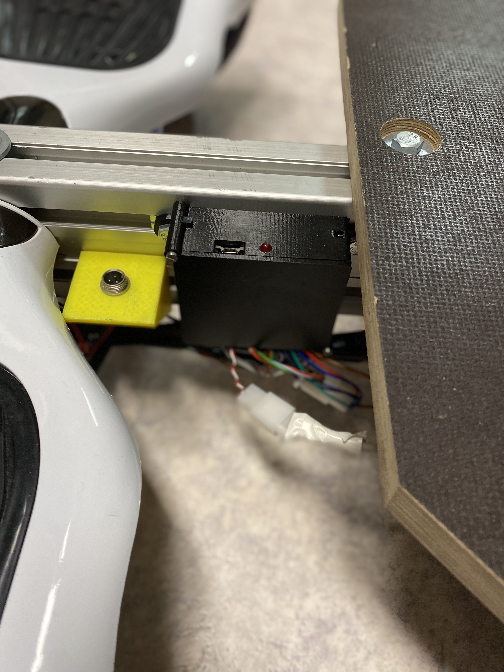
docs/projektmodul-mk/img/motor_controller_anschluss.jpg
