ll7/scoomatic-hoverboard/docs/projektmodul-mk/img/motor_controller_steck_verbinder.jpg

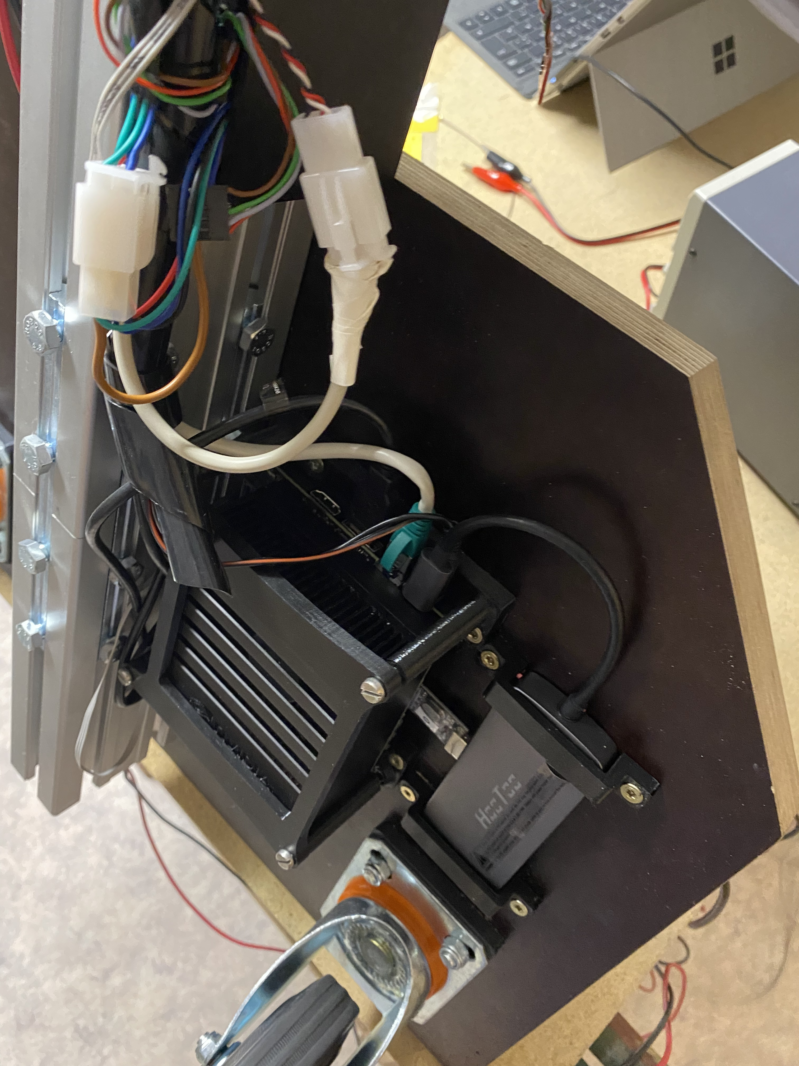
docs/projektmodul-mk/img/motor_controller_steck_verbinder.jpg
