ll7/scoomatic-hoverboard/docs/projektmodul-mk/img/rosgraph.png

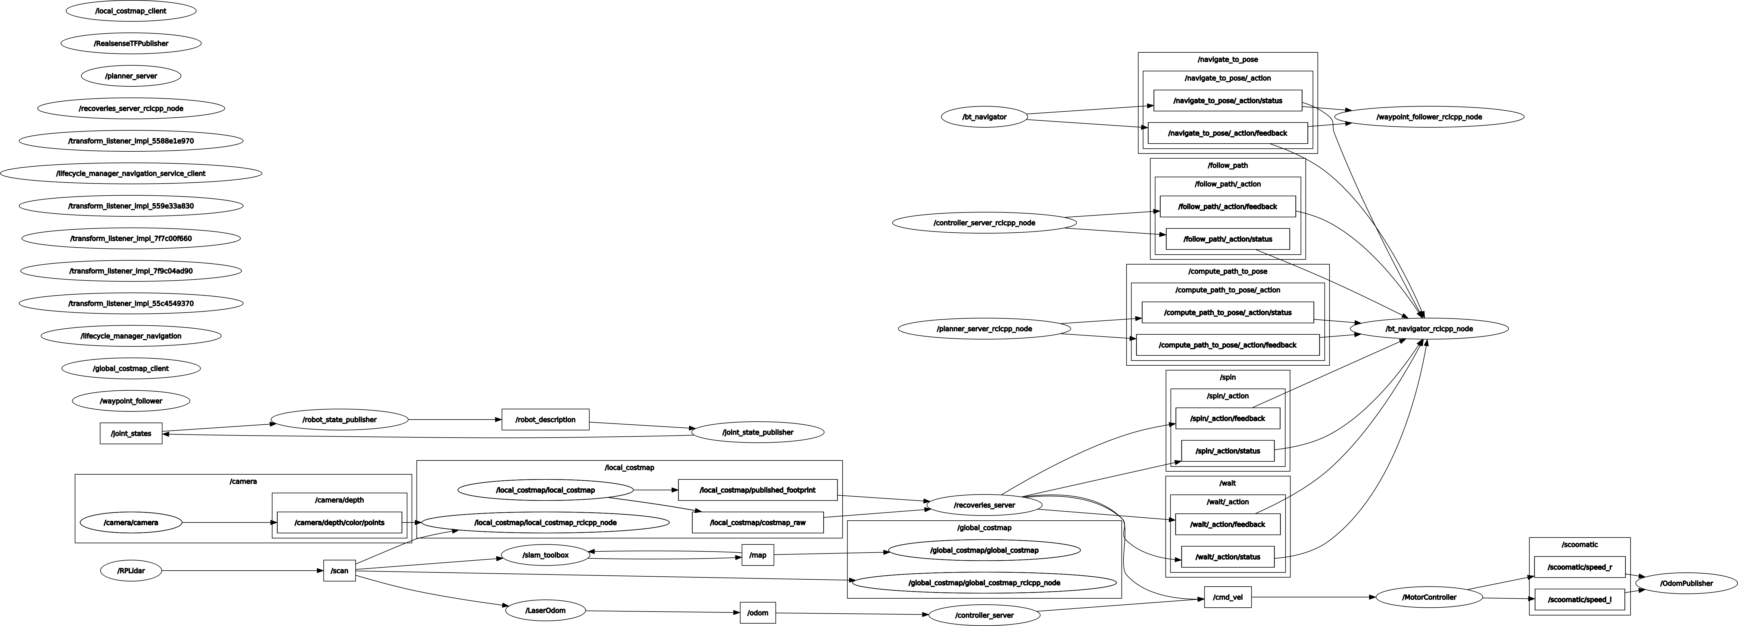
docs/projektmodul-mk/img/rosgraph.png
