ll7/scoomatic-hoverboard/docs/projektmodul-mk/img/schematic_motor_controll_esp.png

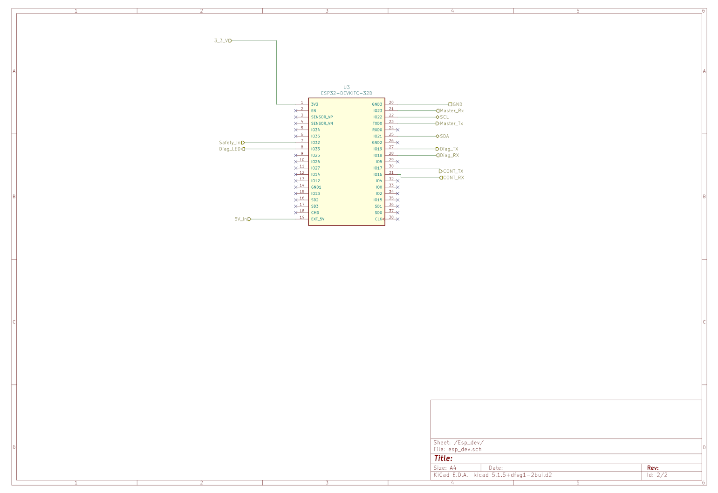
docs/projektmodul-mk/img/schematic_motor_controll_esp.png
