ll7/scoomatic-hoverboard/docs/projektmodul-mk/img/stromversorgung.png

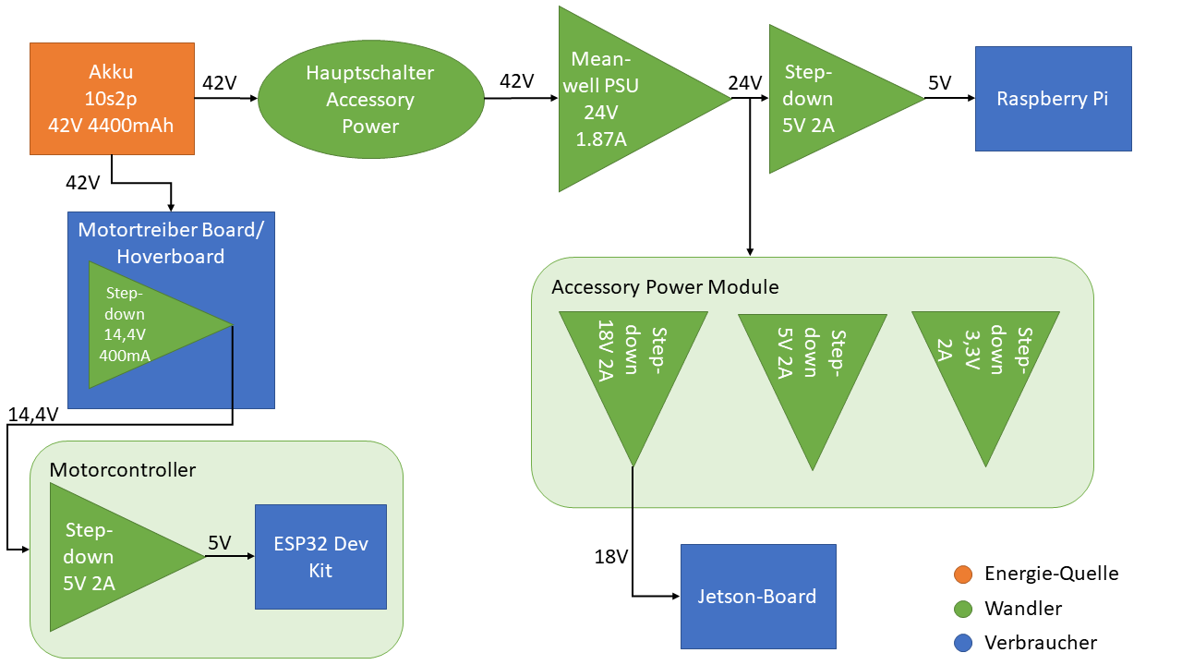
docs/projektmodul-mk/img/stromversorgung.png
