ll7/scoomatic-hoverboard/docs/projektmodul-ms/fotos/Hoverboard_Final_2019-Jul-10_08-32-36PM-000_CustomizedView5558843680.png

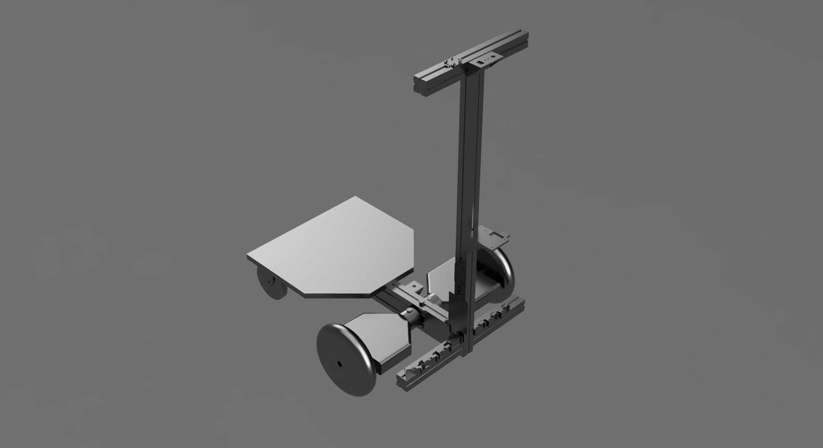
docs/projektmodul-ms/fotos/Hoverboard_Final_2019-Jul-10_08-32-36PM-000_CustomizedView5558843680.png
