ll7/scoomatic-hoverboard/docs/projektmodul-ms/fotos/IMG_20190128_161047.jpg

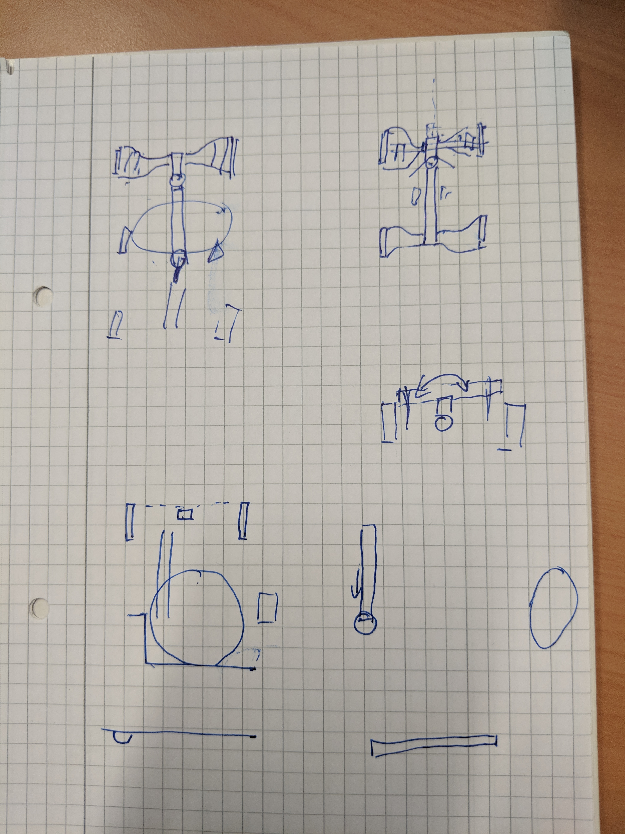
docs/projektmodul-ms/fotos/IMG_20190128_161047.jpg
