ll7/scoomatic-hoverboard/docs/projektmodul-ms/fotos/IMG_20190130_182413.jpg

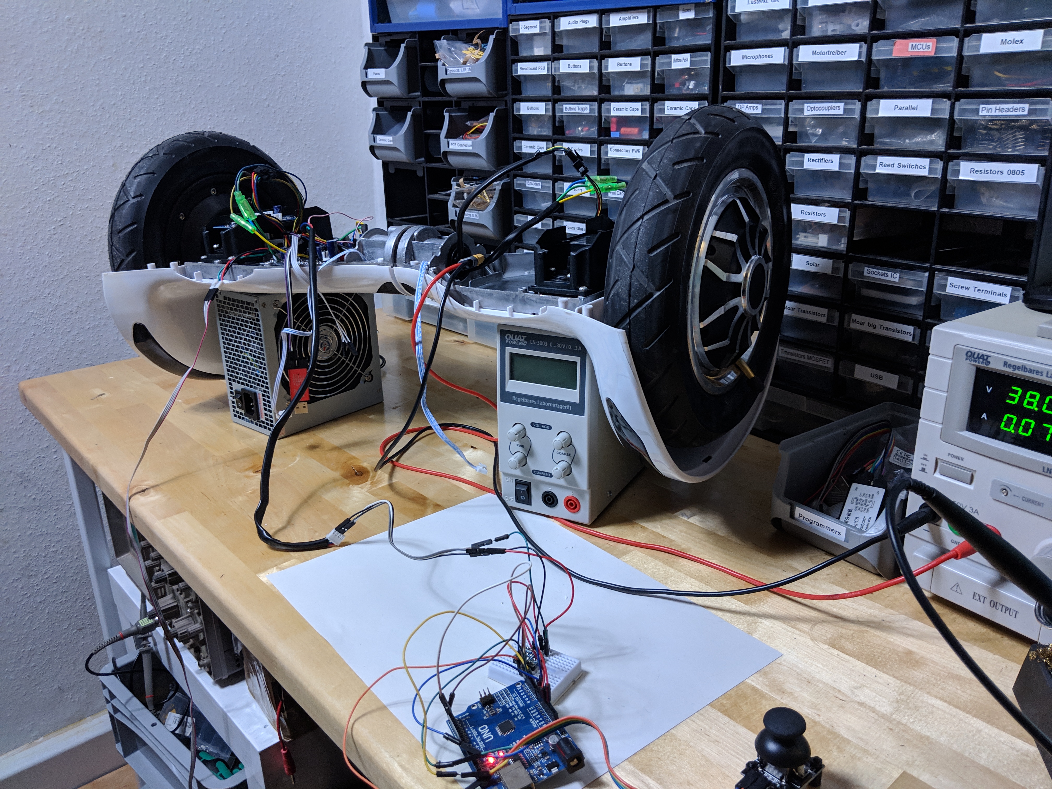
docs/projektmodul-ms/fotos/IMG_20190130_182413.jpg
