ll7/scoomatic-hoverboard/docs/projektmodul-ms/fotos/IMG_20190301_230610.jpg

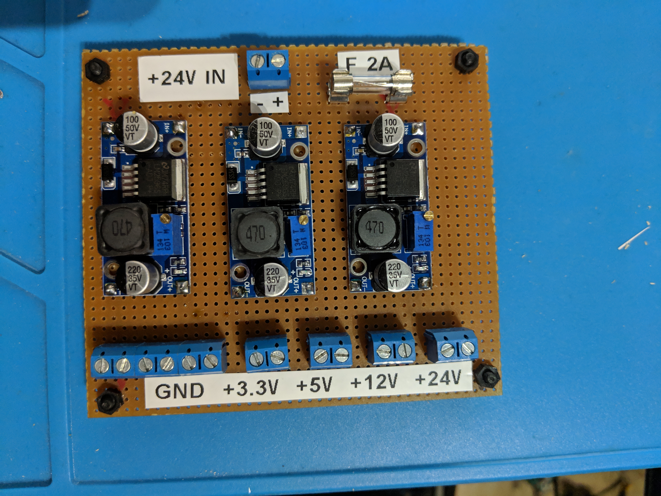
docs/projektmodul-ms/fotos/IMG_20190301_230610.jpg
