ll7/scoomatic-hoverboard/docs/projektmodul-ms/fotos/IMG_20190529_140757.jpg

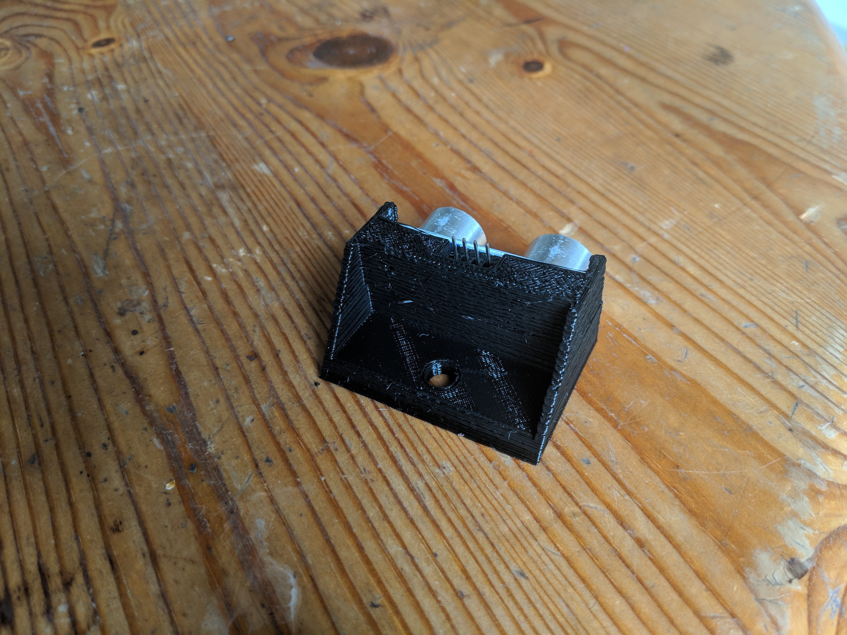
docs/projektmodul-ms/fotos/IMG_20190529_140757.jpg
