ll7/scoomatic-hoverboard/docs/projektmodul-ms/fotos/IMG_20190625_235444.jpg

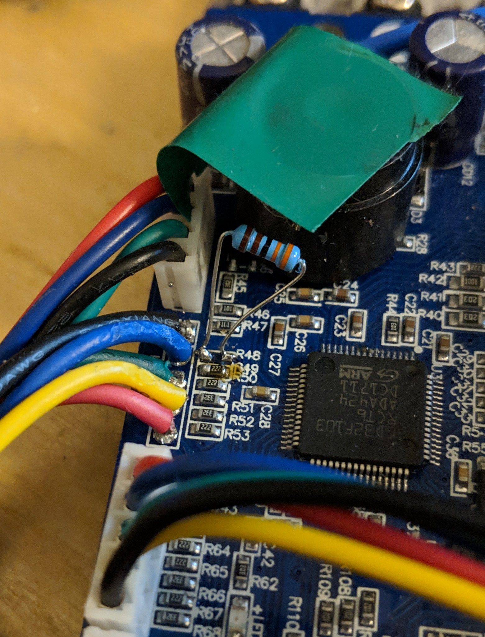
docs/projektmodul-ms/fotos/IMG_20190625_235444.jpg
