ll7/scoomatic-hoverboard/docs/projektmodul-ms/fotos/IMG_20190626_133045.jpg

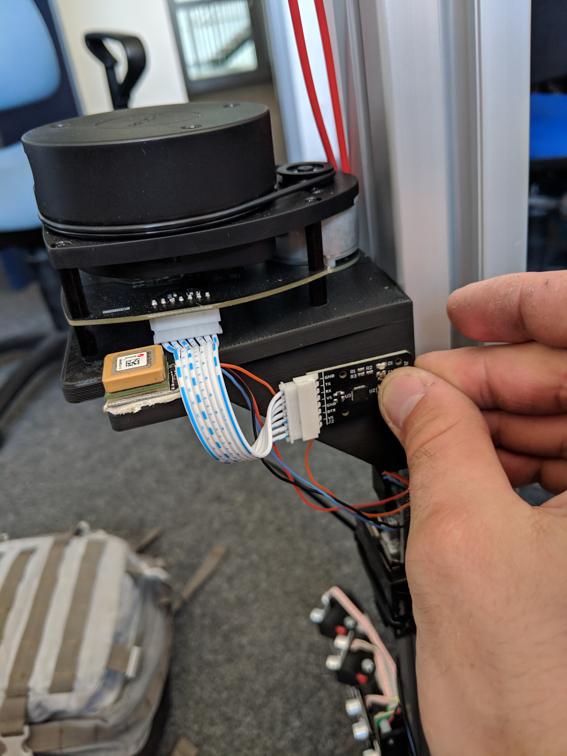
docs/projektmodul-ms/fotos/IMG_20190626_133045.jpg
