ll7/scoomatic-hoverboard/docs/projektmodul-ms/fotos/IMG_20190626_134418.jpg

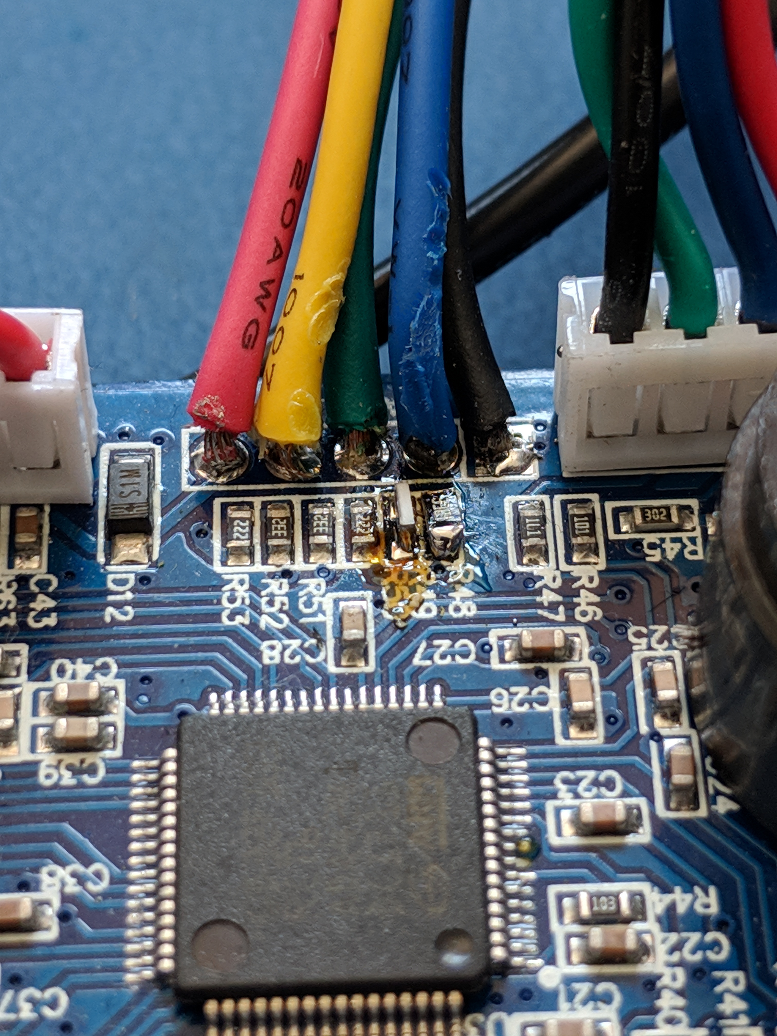
docs/projektmodul-ms/fotos/IMG_20190626_134418.jpg
