ll7/scoomatic-hoverboard/docs/projektmodul-ms/fotos/IMG_20190627_183448.jpg

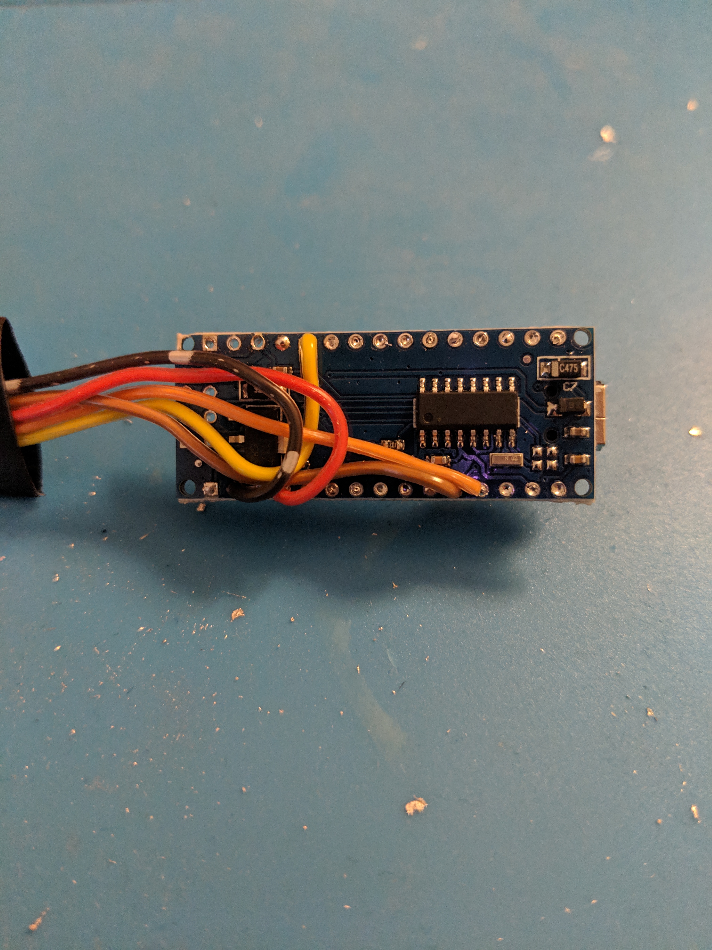
docs/projektmodul-ms/fotos/IMG_20190627_183448.jpg
