ll7/scoomatic-hoverboard/docs/projektmodul-ms/fotos/IMG_20190627_183501.jpg

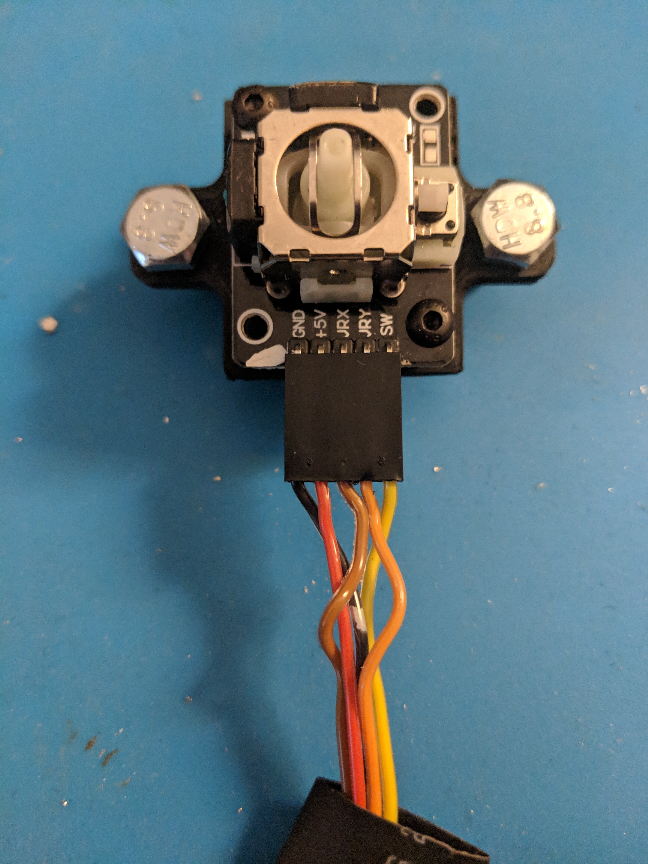
docs/projektmodul-ms/fotos/IMG_20190627_183501.jpg
