ll7/scoomatic-hoverboard/docs/projektmodul-ms/fotos/IMG_20190628_185605.jpg

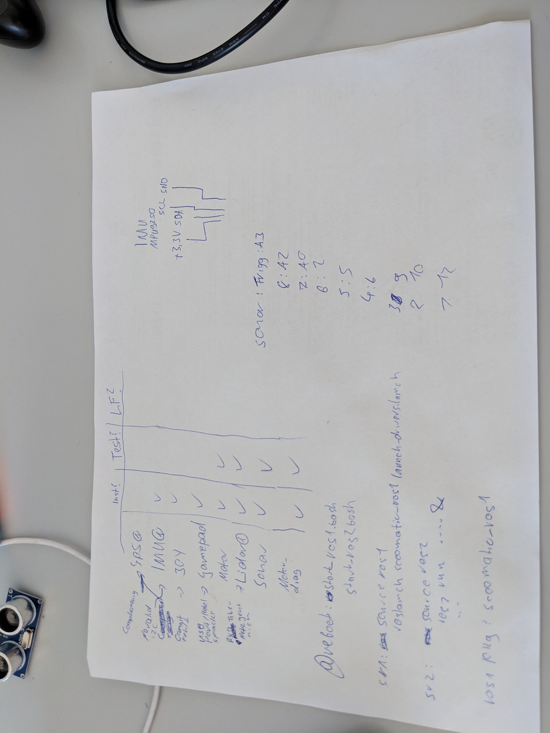
docs/projektmodul-ms/fotos/IMG_20190628_185605.jpg
