ll7/scoomatic-hoverboard/docs/projektmodul-ms/fotos/IMG_20190711_165645.jpg

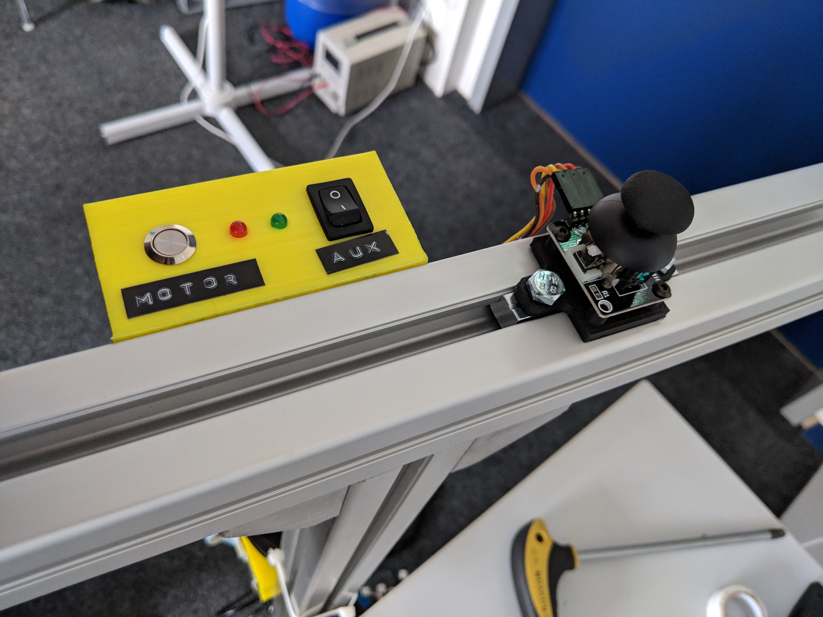
docs/projektmodul-ms/fotos/IMG_20190711_165645.jpg
