ll7/scoomatic-hoverboard/docs/projektmodul-ms/images/program-success.png

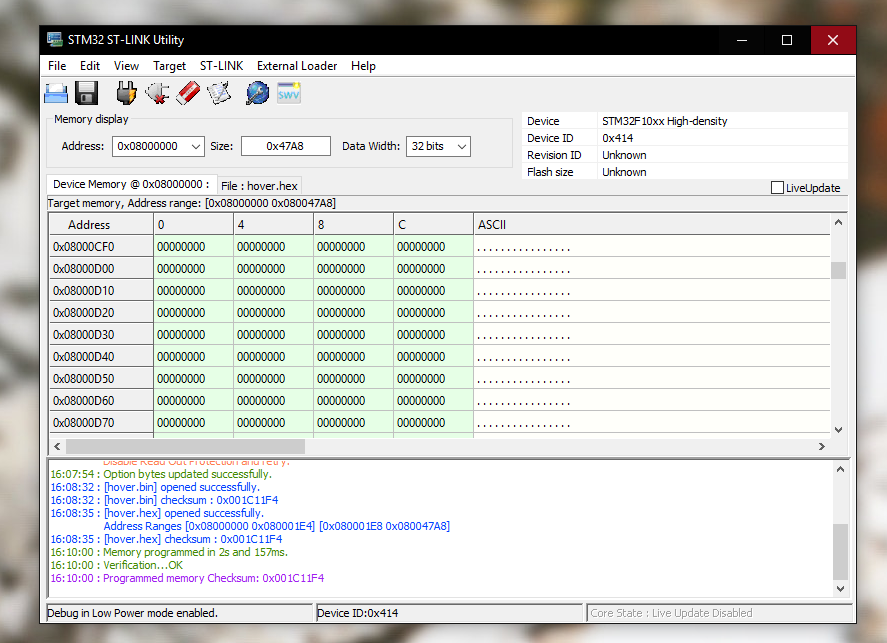
docs/projektmodul-ms/images/program-success.png
