ll7/scoomatic-hoverboard/docs/projektmodul-ms/images/system overview.png

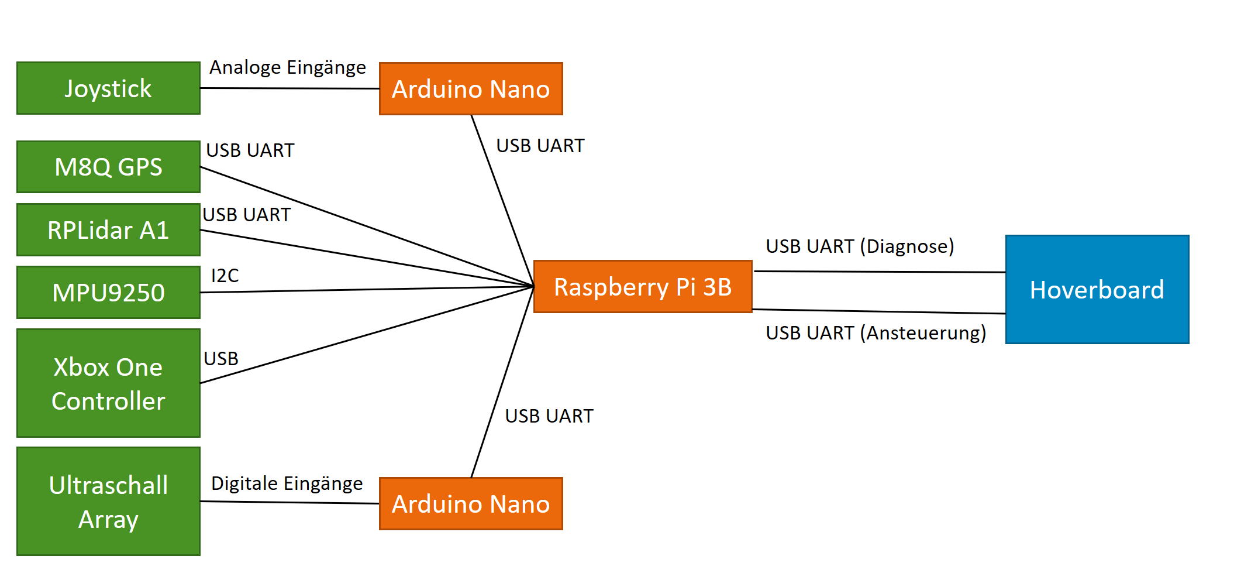
docs/projektmodul-ms/images/system overview.png
