ll7/scoomatic-hoverboard/docs/seminar-ms/images/scube.PNG

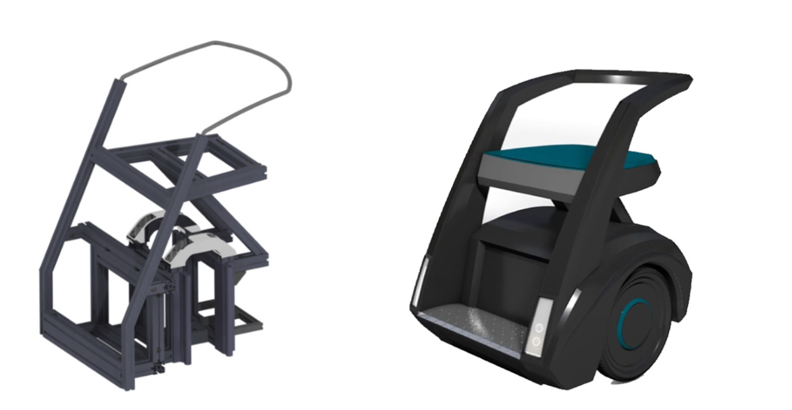
docs/seminar-ms/images/scube.PNG
