ll7/scoomatic-hoverboard/docs/einkaufsliste.ods

Artikel | Quelle | Bestellnummer | Anzahl | Preis/Stk | Gesamt | Bemerkung
LiPo Safe | stefansliposhop.de | https://www.stefansliposhop.de/Sicherheits-Waermekoffer/BAT-SAFE-Sicherheitskoffer::1841.html | 1 | 59,9 | 59,9
Labornetzteil, min 50v 5A | Pollin | 351565 | 1 | 69,95 | 69,95
STLink V2 | Conrad | 802243974 | 1 | 41,75 | 41,75 | Ich würde die 2€-Chinaversion kaufen: https://bit.ly/2BxQYUv, https://bit.ly/2tqzTaR, https://bit.ly/2WV4kDs | Privat bestellt am 08.04.
Luftpumpe für Luftreifen | Conrad | 1581863 - 62 | 1 | 15,49 | 15,49
Reely Akku Buchse XT60 vergoldet 1 St. | Conrad | 1373200 - 62 | 5 | 0,99 | 4,95 | Bestellt am 05.04.
Reely Akku Stecker XT60 vergoldet 1 St. | Conrad | 1373199 - 62 | 5 | 0,99 | 4,95
AlphaWire 3079 RD001 Litze 1 x 2.08 mm² Rot | Conrad | 1368753 - 62 | 5 | 0,79 | 3,95
AlphaWire 3079 BK001 Litze 1 x 2.08 mm² Schwarz | Conrad | 1368750 - 62 | 5 | 0,79 | 3,95 |  |  |  | Legende:
Bananenstecker Stecker Schwarz | Conrad | 730114 - 62 | 2 | 1,94 | 3,88 |  |  |  |  | Wird unmittelbar benötigt
Bananenstecker Stecker Rot | Conrad | 730106 - 62 | 2 | 1,94 | 3,88 |  |  |  |  | Schon bestellt
Helukabel 37029 Gummischlauchleitung H07RN-F 3 G 2.50 mm² Schwarz | Conrad | 1539371 – 62 | 3 | 2,55 | 7,65 |  |  |  |  | Eventuell Unnötig, nicht bestellen
Rundsteckhülse 1.50 mm² 2.50 mm² Stift-Ø: 5 mm Vollisoliert Blau | Conrad | 739034 - 62 | 1 | 6,29 | 6,29 |  |  |  |  | Nice to have, wird spätestens benötigt, wenn nach mir jemand das Projekt übernimmt
Rundstecker 1.50 mm² 2.50 mm² Stift-Ø: 5 mm Teilisoliert Blau | Conrad | 738490 – 62 | 1 | 6,29 | 6,29
Seegeringzange Passend für Außenringe 19-60 mm | Conrad | 822203 - 62 | 1 | 15,01 | 15,01 | Für Seegeringe der Hoverboardachse
WeMos D1 mini V2 WIFI Board based on ESP-8266EX Arduino NodeMcu | Conrad | 802247557 | 1 | 9,52 | 9,52 | Für Motoransteuerung von Anhänger über WLAN
Mini-Kabel, USB A Stecker an Mini-B Stecker | Conrad | 800403528 | 3 | 1,25 | 3,75 | Bisher nur auf Bestelliste gesetzt
DC-DC 7-40V to 1,2-35V 300W 8A Step-down | Conrad | 802244052 | 1 | 8,75 | 8,75
LogiLink UA0139 4 Port USB 2.0-Hub Schwarz | Conrad | 986337 - 62 | 1 | 4,19 | 4,19
Logic Level Converter 8ch | Conrad | 802236624 | 1 | 3,92 | 3,92
Raspberry Pi 3 Model B+ | Conrad | 801081557 | 1 | 43,95 | 43,95
Mean Well DC/DC-Wandler PSD-45C-24 1.875A | Conrad | 1292639 - 62 | 1 | 21,4 | 21,4
Samsung EVO Plus microSDHC-Karte 32 GB Class 10 | Conrad | 1547259 - 62 | 1 | 10,99 | 10,99
Raspberry Pi® USB-Kabel Schwarz | Conrad | 1674932 – 62 | 1 | 2,89 | 2,89
RPLidar A1M8 | Robotshop | https://www.robotshop.com/en/rplidar-a1m8-360-degree-laser-scanner-development-kit.html | 1 | 103 | 103 | Bestellt am 16.02.
UART NEO-7M-C GPS-Modul | Robotshop | https://www.robotshop.com/de/de/uart-neo-7m-c-gps-modul.html | 1 | 21,91 | 21,91
IMU Breakout Board - MPU-9250 | Robotshop | https://www.robotshop.com/de/de/imu-breakout-board-mpu-9250.html | 1 | 15,6 | 15,6
Nano V3 mit FTDI | Az-delivery | https://www.az-delivery.de/products/nano-v3-mit-ftdi-arduino-kompatibel?ls=de | 3 | 4,99333 | 14,97999 | 1x IMU, 1x Motortreiber, 1x Sonar |  | Ich habe jetzt 5 bestellt
HC-SR04 | Az-delivery | https://www.az-delivery.de/products/3er-set-hc-sr04-ultraschallmodule?ls=de | 10 | 1,8 | 18 | 2x5
LM2596S DC-DC Step Down Modul | Az-delivery | https://www.az-delivery.de/products/lm2596s-dc-dc-step-down-modul-1?ls=de | 5 | 1,4 | 7 |  | Bestellt am 16.02.
USB-Serial Adapter |  |  | 2
Hauptschalter?
Stahlrohr 30mm 2mm Wandstärke 500mm Länge | Stahl-Shop24 | https://www.stahl-shop24.de/stahl-rundrohr-300x20-500 | 1 | 3 | 3
Joystick | Az-delivery | https://www.az-delivery.de/products/joystick-modul?ls=de | 1 | 2,99 | 2,99 | Bestellt am 08.04. | 3x plus versand für 10€
Verbindungwelle Zugfahrzeug <-> Anhänger | Dold-Mechatronik | https://www.dold-mechatronik.de/Praezisionswelle-20mm-h6-geschliffen-und-gehaertet-Standardlaengen-150mm | 1 | 3,3 | 3,3
Stehlager Verbindung Zugfahrzeug <-> Anhänger | Kugellager--Express | https://www.kugellager-express.de/stehlager-lagerbock-stehlagereinheit-ucp204-welle-20-mm | 4 | 4,94 | 19,76
Raspberry Pi Model 3B | Conrad | https://www.conrad.de/de/raspberry-pi-3-model-b-1-gb-ohne-betriebssystem-1419716.html | 1 | 34,49 | 34,49
 |  |  |  |  | 0
Stahlplatte Verzinkt 4mm Stärke 128x? | prokilo.de | https://www.prokilo.de/stahl-metall/bleche-platten-im-zuschnitt/glatte-bleche-auf-mass/ | 2 | 6 | 12
Sechskantschrauben M10x80mm verzinkt | befestigungsfuchs | https://www.befestigungsfuchs.de/befestigungstechnik/schrauben/sechskantschrauben/verzinkt/25-sechskantschrauben-din-933---m10-x-80mm---verzinkt---festigkeit-88 | 25 | 0,2356 | 5,89
Sechskantmutter M12 Stahl Verzinkt 20st | befestigungsfuchs |  |  |  | 0
Gewindestange M12 1000mm Verzinkt | befestigungsfuchs |  |  |  | 0
Sechskantmuttern M10 Selbstsichernd | Bauhaus |  | 5 |  | 0
Aluprofil Nut 10 45x45x400 | Bosch Rexeroth | https://www.boschrexroth.com/ics/cat/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 | 1 |  | 0
Aluprofil Nut 10 45x45x250 | Bosch Rexeroth | https://www.boschrexroth.com/ics/cat/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 | 2 |  | 0
Aluprofil Nut 10 45x45x1000 | Bosch Rexeroth | https://www.boschrexroth.com/ics/cat/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 | 1 |  | 0
Aluprofil Nut 10 90x45x220 | Bosch Rexeroth | https://www.boschrexroth.com/ics/cat/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 | 1 |  | 0
Aluprofil Nut 10 90x45x500 | Bosch Rexeroth | https://www.boschrexroth.com/ics/cat/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 | 1 |  | 0
Geradeverbinder 180N10 | Bosch Rexeroth | https://www.boschrexroth.com/ics/cat/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 | 6 |  | 0
T-Verbinder (Standard) | Bosch Rexeroth | https://www.boschrexroth.com/ics/cat/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 | 5 |  | 0
90° Winkel (Set Standard) | Bosch Rexeroth | https://www.boschrexroth.com/ics/cat/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 | 8 |  | 0
Nutensteine Nut 10 1pk | Bosch Rexeroth | https://www.boschrexroth.com/ics/cat/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 | 1 |  | 0
 |  |  |  |  | 0
 |  |  |  |  | 0
Kabelschlauch | Pollin | https://www.pollin.de/p/kabel-spiralschlauch-oe-15mm-1-8-m-440603 | 1 | 1,1 | 1,1
Micro USB Kabel | Pollin | https://www.pollin.de/p/usb-2-0-kabel-usb-a-micro-usb-0-5-m-721771 | 2 | 1 | 2
Feinsicherungs Sortiment | Pollin | https://www.pollin.de/p/feinsicherungs-sortiment-260134 | 1 | 5,45 | 5,45
 |  |  |  |  | 0
 |  |  |  |  | 0
