ll7/scoomatic-hoverboard/cad/30mm Hole.dxf

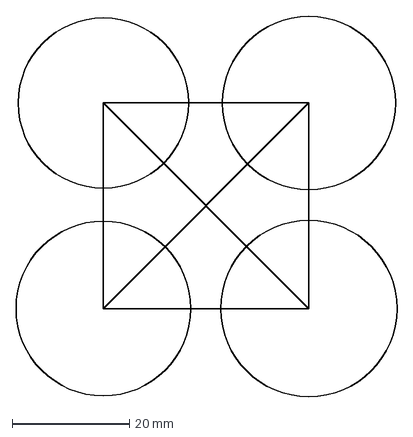
[picture p120: CAD file, 2019-07-11]
cad/30mm Hole.dxf
64.9 x 64.8 mm
