ll7/scoomatic-hoverboard/cad/inventor/MotorController/gehause.3mf

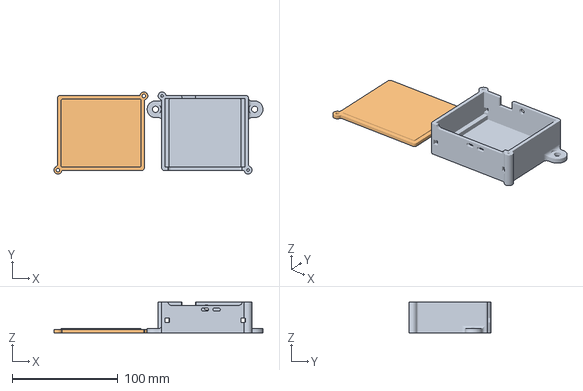
[picture p121: CAD file, 2021-10-14]
cad/inventor/MotorController/gehause.3mf
197.7 x 77.6 x 29.0 mm
gehause.stl
deckel.stl
