ll7/scoomatic-hoverboard/cad/inventor/Realsense/BackPlate_itemBracket.3mf

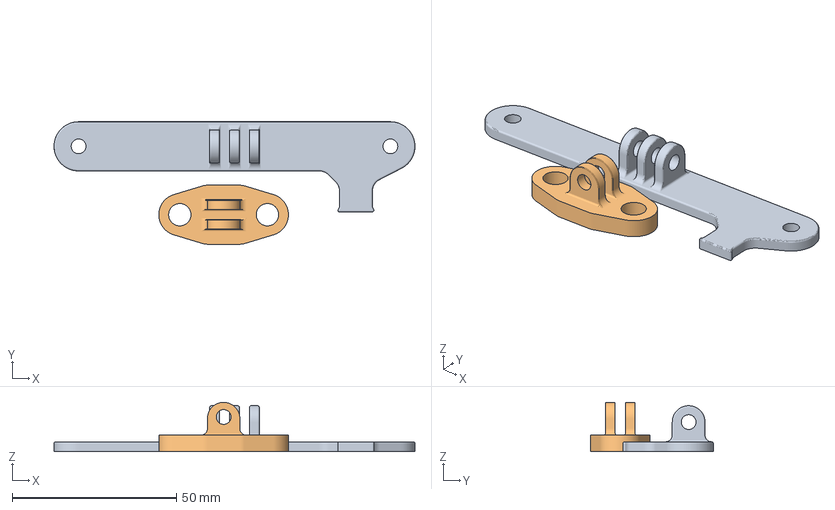
[picture p122: CAD file, 2021-10-14]
cad/inventor/Realsense/BackPlate_itemBracket.3mf
110.0 x 37.3 x 15.0 mm
BackPlate.stl
itemMount.stl
