ll7/scoomatic-hoverboard/cad/inventor/Scoomatic-Jetson/Wlan-antennen-halter+ersatz-fuss.3mf

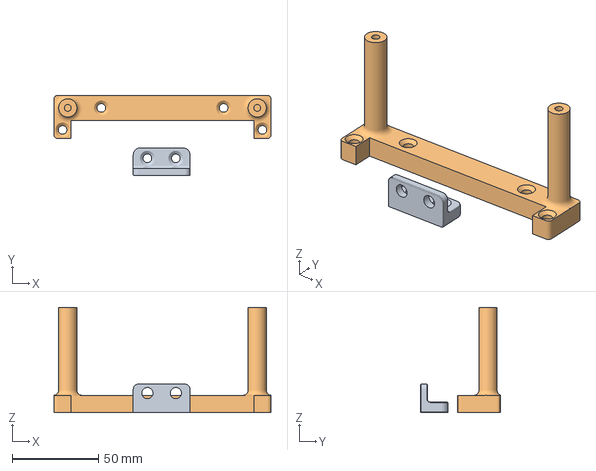
[picture p123: CAD file, 2021-10-14]
cad/inventor/Scoomatic-Jetson/Wlan-antennen-halter+ersatz-fuss.3mf
126.0 x 46.5 x 61.0 mm
Wlan-antennen-halter.stl
fuss.stl_1
