ll7/scoomatic-hoverboard/cad/stl/gehause.stl

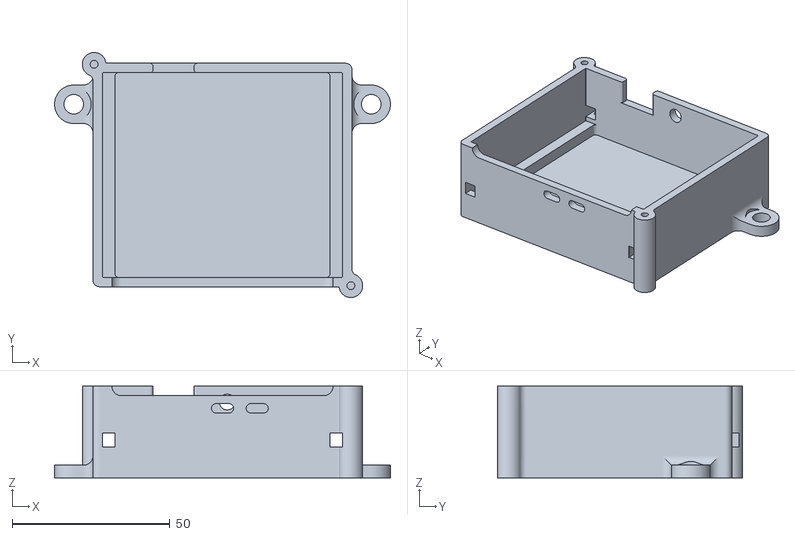
[picture p124: CAD file, 2021-10-14]
cad/stl/gehause.stl
106.4 x 77.6 x 29.0
