ll7/scoomatic-hoverboard/cad/inventor/MotorController/totmannschalter.3mf

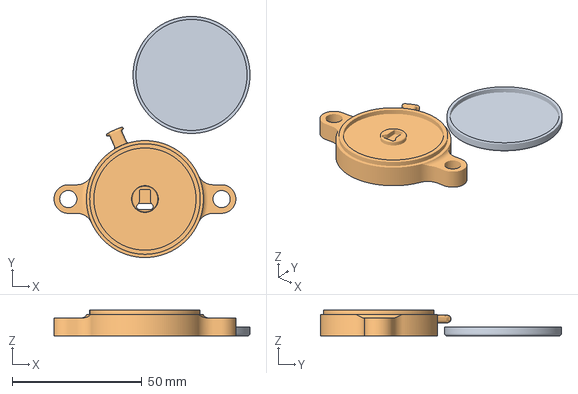
[picture p125: CAD file, 2021-10-14]
cad/inventor/MotorController/totmannschalter.3mf
75.4 x 92.8 x 10.0 mm
totmannschalter_deckel.stl
totmannschalter_grundplatte.stl
