ll7/scoomatic-hoverboard/cad/stl/Wlan-antennen-halter.stl

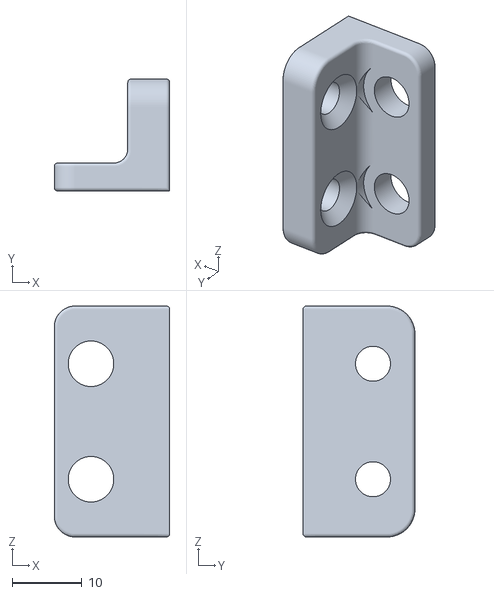
[picture p126: CAD file, 2021-10-14]
cad/stl/Wlan-antennen-halter.stl
16.5 x 16.0 x 33.0
