ll7/scoomatic-hoverboard/cad/stl/itemMount.stl

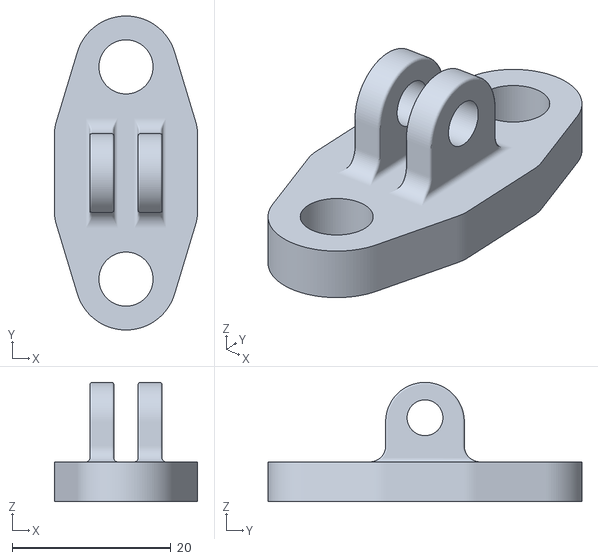
[picture p127: CAD file, 2021-10-14]
cad/stl/itemMount.stl
18.0 x 39.5 x 15.0
