ll7/scoomatic-hoverboard/cad/stl/totmannschalter_grundplatte.stl

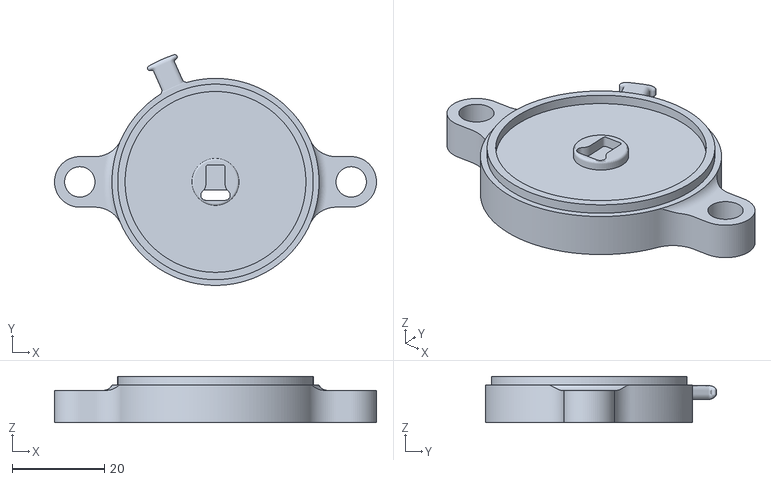
[picture p128: CAD file, 2021-10-14]
cad/stl/totmannschalter_grundplatte.stl
70.0 x 50.2 x 10.0
