ll7/scoomatic-hoverboard/cad/stl/Riegel1.stl

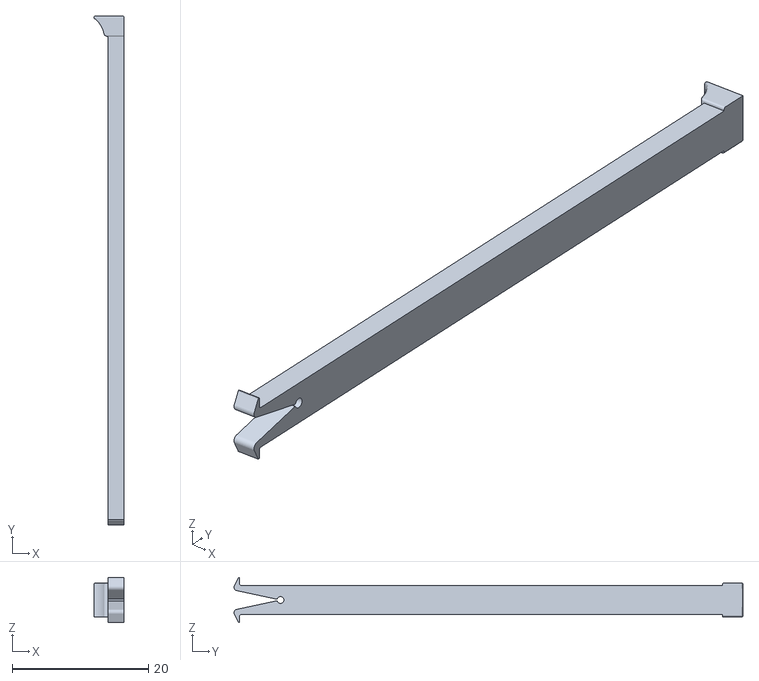
[picture p129: CAD file, 2021-10-14]
cad/stl/Riegel1.stl
4.47 x 74.8 x 6.65
