ll7/scoomatic-hoverboard/cad/stl/BackPlate.stl

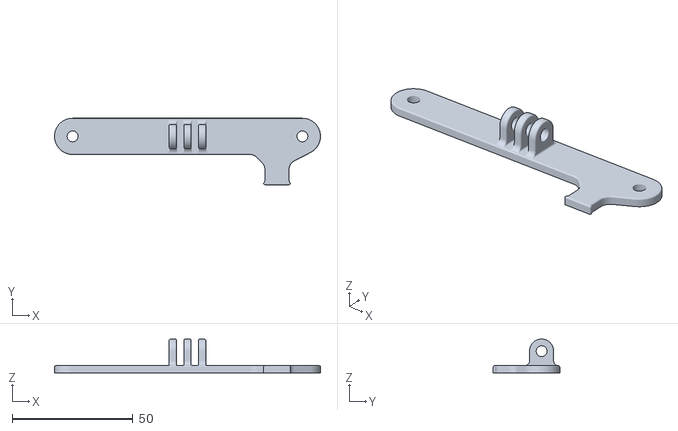
[picture p130: CAD file, 2021-10-14]
cad/stl/BackPlate.stl
110.0 x 27.5 x 14.0
