ll7/scoomatic-hoverboard/cad/stl/fuss.stl

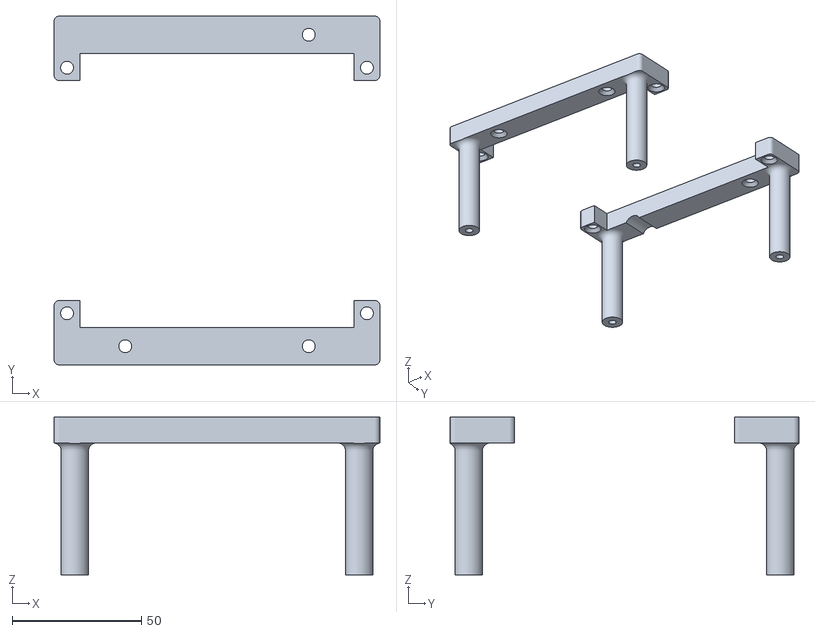
[picture p131: CAD file, 2021-10-14]
cad/stl/fuss.stl
126.0 x 135.0 x 61.0
