ll7/scoomatic-hoverboard/cad/stl/klammern_usbc_hub.stl

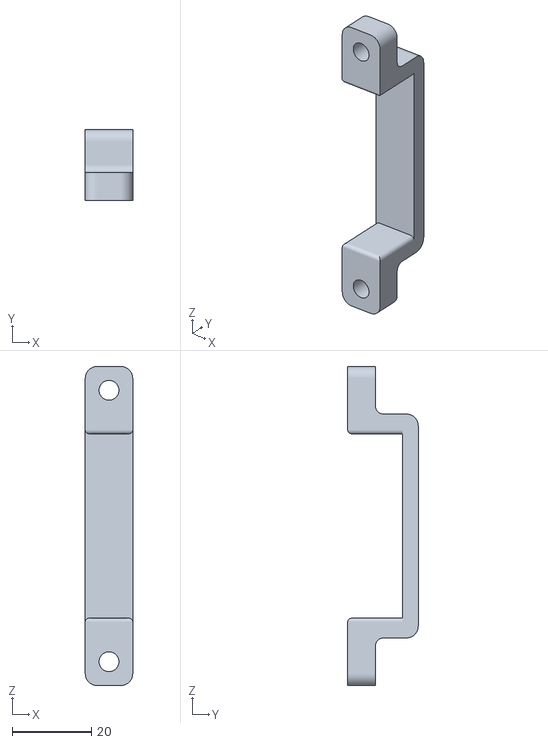
[picture p132: CAD file, 2021-10-14]
cad/stl/klammern_usbc_hub.stl
12.0 x 17.8 x 80.5
