ll7/scoomatic-hoverboard/cad/stl/deckel.stl

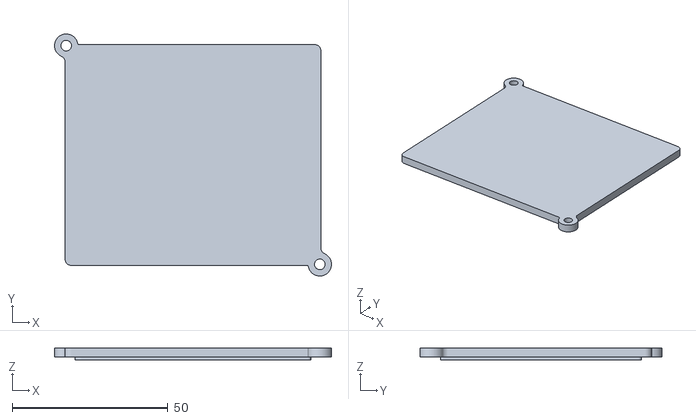
[picture p133: CAD file, 2021-10-14]
cad/stl/deckel.stl
88.8 x 77.6 x 4.00
