ll7/scoomatic-hoverboard/cad/stl/jetson_deckel.stl

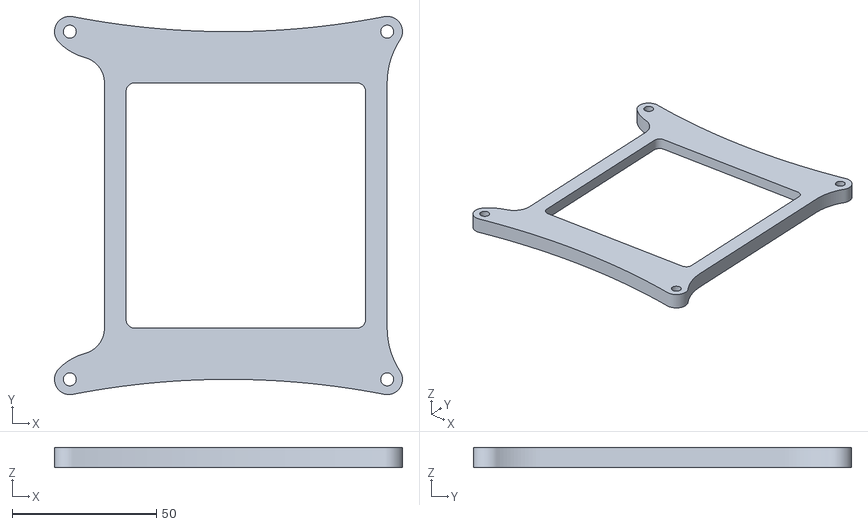
[picture p134: CAD file, 2021-10-14]
cad/stl/jetson_deckel.stl
120.6 x 131.1 x 7.00
