ll7/scoomatic-hoverboard/cad/stl/totmannschalter_deckel.stl

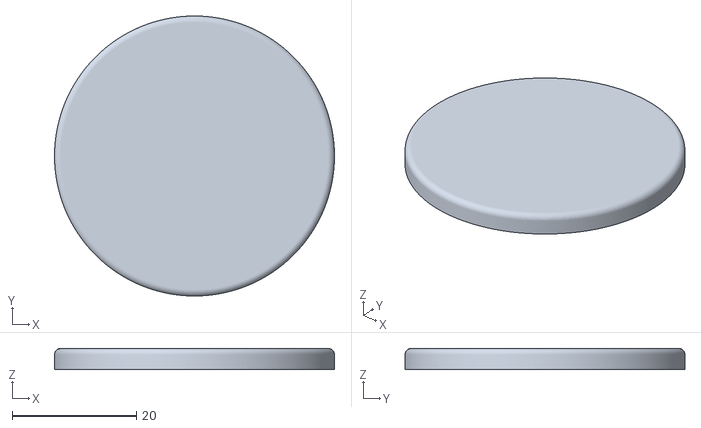
[picture p135: CAD file, 2021-10-14]
cad/stl/totmannschalter_deckel.stl
45.0 x 45.0 x 3.40
