ll7/scoomatic-hoverboard/cad/stl/Joystick mount v1.stl

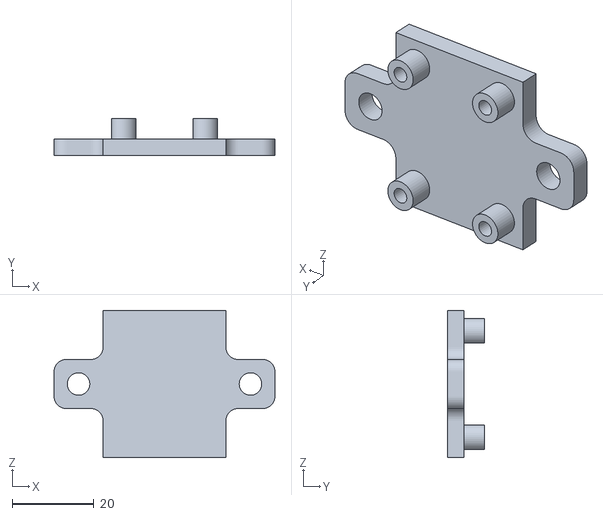
[picture p136: CAD file, 2019-06-28]
cad/stl/Joystick mount v1.stl
54.0 x 9.00 x 36.0
