ll7/scoomatic-hoverboard/cad/stl/rpi2-remix-bottom.stl

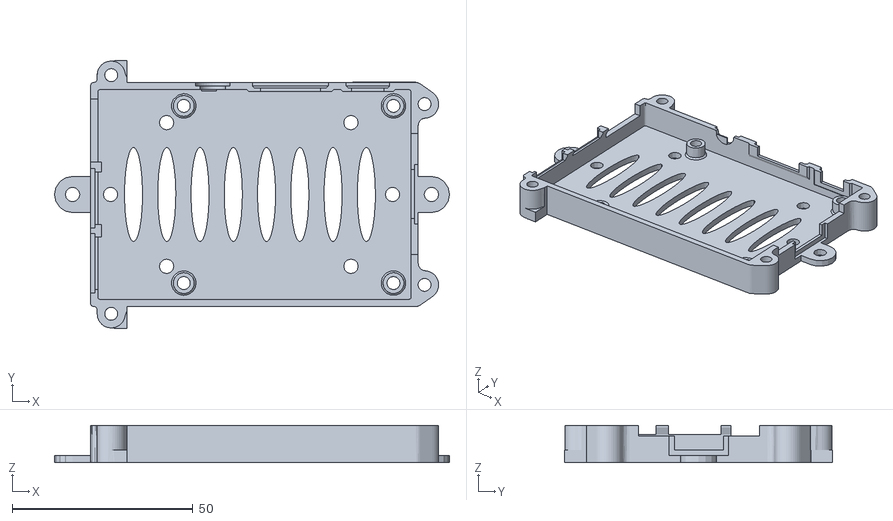
[picture p137: CAD file, 2019-06-28]
cad/stl/rpi2-remix-bottom.stl
109.3 x 74.0 x 10.3
