ll7/scoomatic-hoverboard/cad/stl/Spacer Rear Wheels.stl

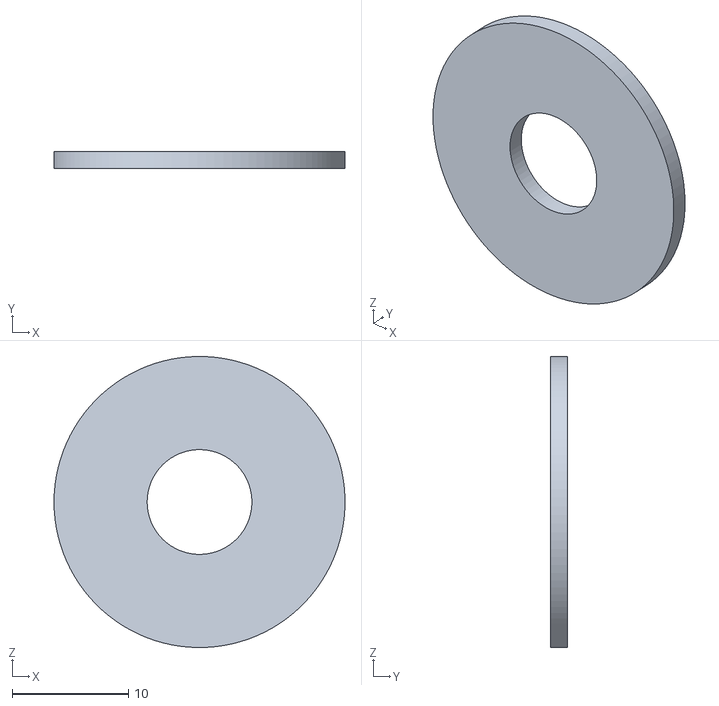
[picture p138: CAD file, 2019-06-28]
cad/stl/Spacer Rear Wheels.stl
25.0 x 1.50 x 25.0
