ll7/scoomatic-hoverboard/cad/stl/Power PCB Bracket v1.stl

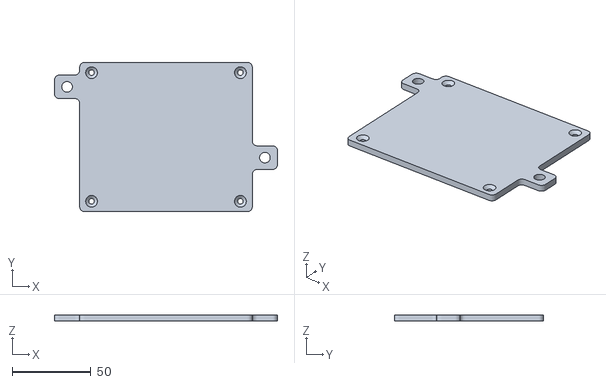
[picture p139: CAD file, 2019-06-28]
cad/stl/Power PCB Bracket v1.stl
141.8 x 94.9 x 4.00
