ll7/scoomatic-hoverboard/cad/stl/RPLIDAR Bracket v5.stl

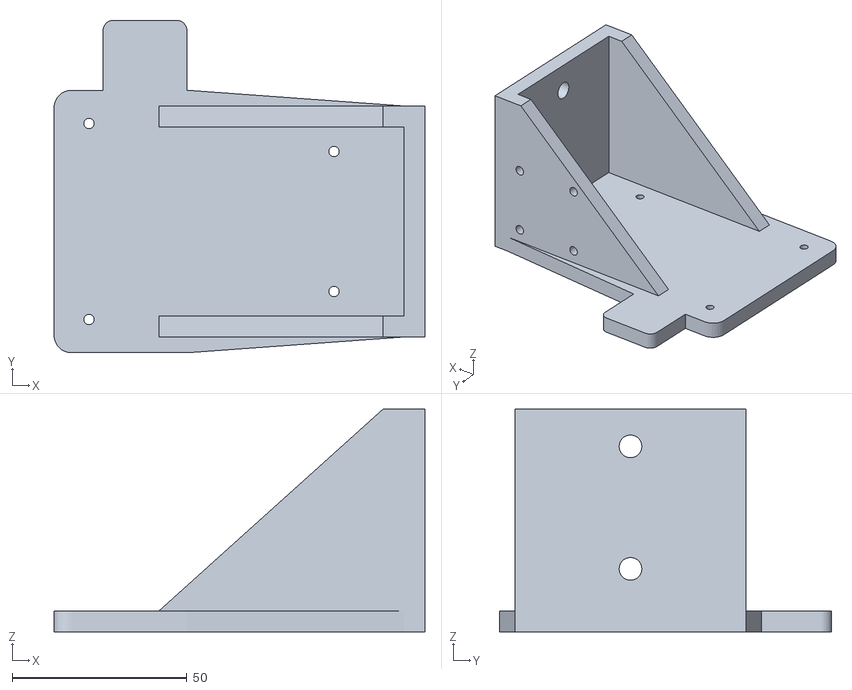
[picture p140: CAD file, 2019-06-28]
cad/stl/RPLIDAR Bracket v5.stl
106.0 x 95.0 x 63.6
