ll7/scoomatic-hoverboard/cad/stl/Charger Bracket v2.stl

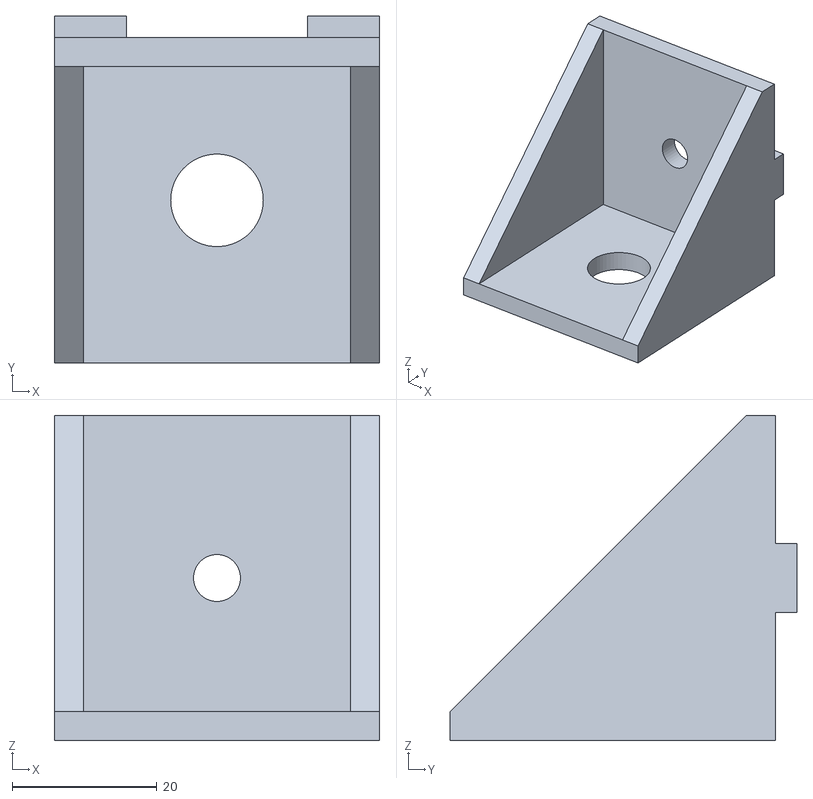
[picture p141: CAD file, 2019-06-28]
cad/stl/Charger Bracket v2.stl
45.0 x 48.0 x 45.0
