ll7/scoomatic-hoverboard/cad/stl/Sonar PCB Bracket v1.stl

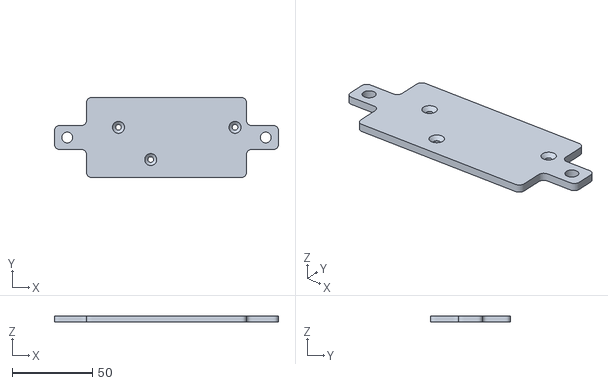
[picture p142: CAD file, 2019-06-28]
cad/stl/Sonar PCB Bracket v1.stl
140.0 x 50.0 x 4.00
