ll7/scoomatic-hoverboard/cad/stl/Scoomatic Spacer v1.stl

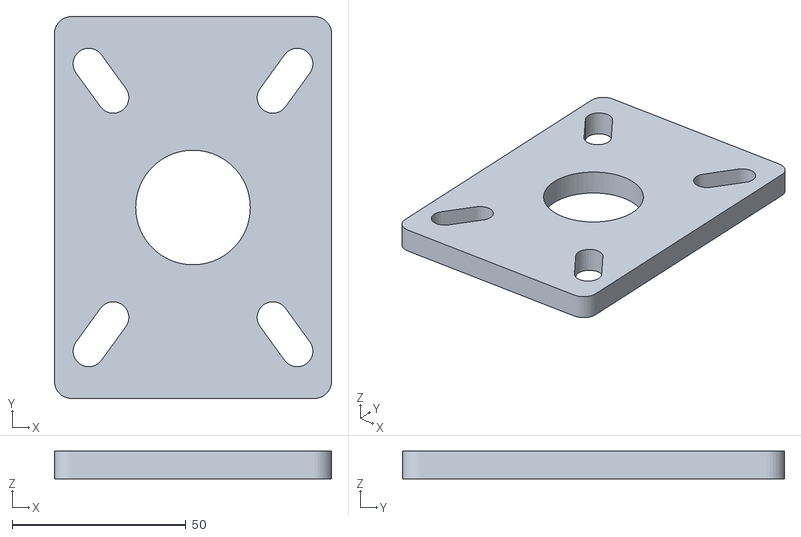
[picture p143: CAD file, 2019-06-28]
cad/stl/Scoomatic Spacer v1.stl
79.9 x 110.0 x 8.00
