ll7/scoomatic-hoverboard/cad/stl/Switch Bracket v2.stl

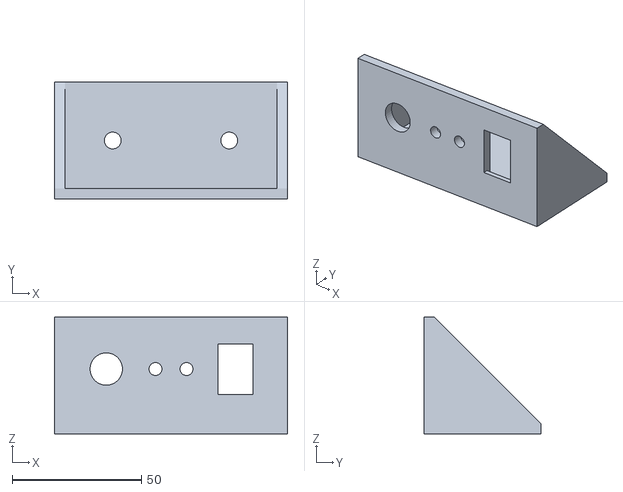
[picture p144: CAD file, 2019-06-28]
cad/stl/Switch Bracket v2.stl
90.0 x 45.0 x 45.0
