ll7/scoomatic-hoverboard/cad/stl/rpi2-top.STL

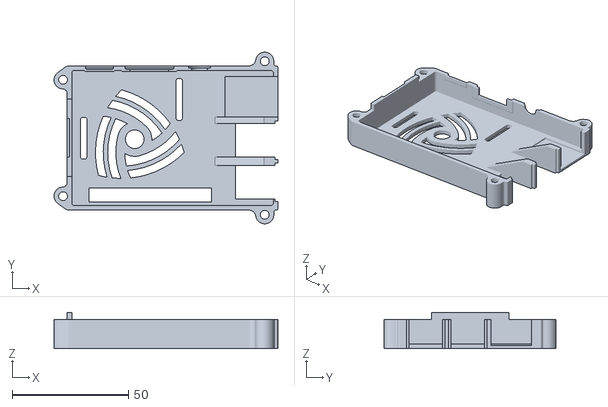
[picture p145: CAD file, 2019-06-28]
cad/stl/rpi2-top.STL
96.2 x 73.8 x 15.5
