ll7/scoomatic-hoverboard/cad/stl/RPI PSU Bracket v1.stl

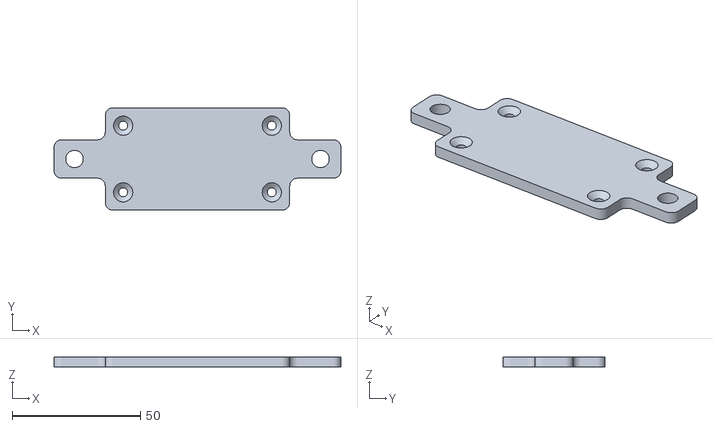
[picture p146: CAD file, 2019-06-28]
cad/stl/RPI PSU Bracket v1.stl
112.0 x 40.0 x 4.00
