ll7/scoomatic-hoverboard/cad/stl/PSU Bracket v1.stl

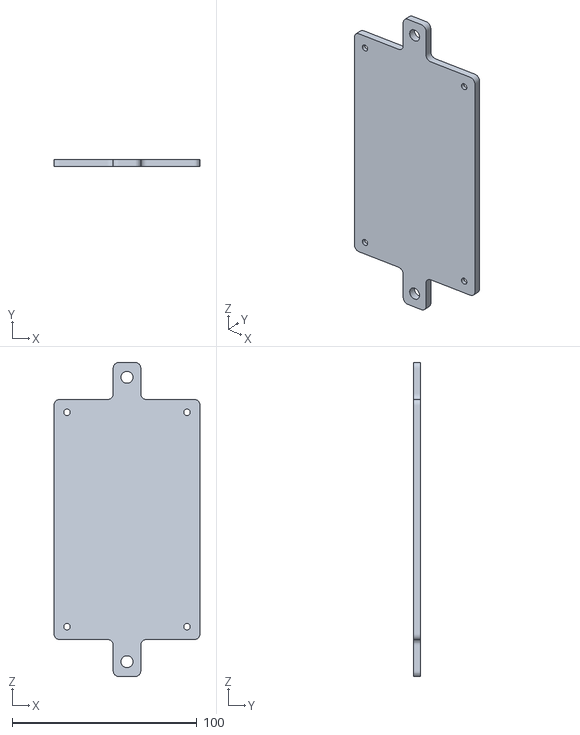
[picture p147: CAD file, 2019-06-28]
cad/stl/PSU Bracket v1.stl
79.0 x 4.00 x 170.0
