ll7/scoomatic-hoverboard/cad/stl/Sonar Bracket v1.stl

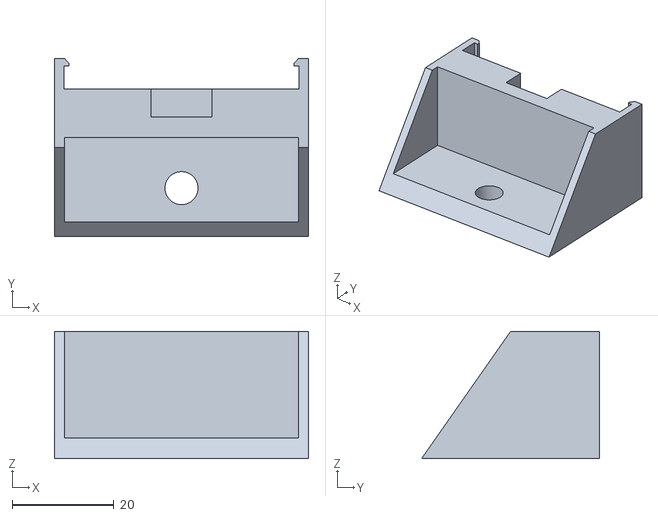
[picture p148: CAD file, 2019-06-28]
cad/stl/Sonar Bracket v1.stl
50.0 x 35.0 x 25.0
