ll7/scoomatic-hoverboard/(list of files, cad)

Other CAD files:
cad/f360/Charger Bracket v3.f3d
cad/f360/Hoverboard Final v3.f3z
cad/f360/Hoverboard Sketch v6.f3d
cad/f360/Joystick mount v1.f3d
cad/f360/M8 Spacer v1.f3d
cad/f360/PSU Bracket v1.f3d
cad/f360/Power PCB Bracket v2.f3d
cad/f360/RPI PSU Bracket v1.f3d
cad/f360/RPLIDAR Bracket v5.f3d
cad/f360/Scoomatic Spacer v2.f3d
cad/f360/Sonar Bracket v2.f3d
cad/f360/Sonar PCB Bracket v1.f3d
cad/f360/Sonar_bracket_alignment_thingy v7.f3d
cad/f360/Switch Bracket v2.f3d
cad/inventor/MotorController/Riegel1.ipt
cad/inventor/MotorController/deckel.ipt
cad/inventor/MotorController/gehaeuse_bg.iam
cad/inventor/MotorController/gehause.ipt
cad/inventor/MotorController/totmannschalter.iam
cad/inventor/MotorController/totmannschalter_deckel.ipt
cad/inventor/MotorController/totmannschalter_grundplatte.ipt
cad/inventor/Realsense/BackPlate.ipt
cad/inventor/Realsense/Protector.ipt
cad/inventor/Realsense/itemMount.ipt
cad/inventor/Realsense/realsense/10137062C_1_1_1.ipt
cad/inventor/Realsense/realsense/10137062C_1_ASM_2_ASM.iam
cad/inventor/Realsense/realsense/91732A181_ASM_1_ASM.iam
cad/inventor/Realsense/realsense/91732A649_ASM_1_ASM.iam
cad/inventor/Realsense/realsense/AM0600115_INT_REV01_2_SW0001_1.ipt
cad/inventor/Realsense/realsense/AM0600115_REV01_ASM_EXTERNA-255_ASM.iam
cad/inventor/Realsense/realsense/AM0600115_REV01_ASM_EXTERNA-517_ASM.iam
cad/inventor/Realsense/realsense/AM0600131_ASM_2_ASM.iam
cad/inventor/Realsense/realsense/AM0600132_ASM_3_ASM.iam
cad/inventor/Realsense/realsense/AM0600133_ASM_2_ASM.iam
cad/inventor/Realsense/realsense/AM0600135_ASM_3_ASM.iam
cad/inventor/Realsense/realsense/AS0605401_ASM_4_ASM.iam
cad/inventor/Realsense/realsense/DS5_0390_ADHESIVE_D455_2.ipt
cad/inventor/Realsense/realsense/DS5_0390_FOAM_FRONT_D455_3.ipt
cad/inventor/Realsense/realsense/DS5_0390_LABEL_FRONT_ADH_D455_3.ipt
cad/inventor/Realsense/realsense/DS5_0390_LABEL_FRONT_MOD_D455_5.ipt
cad/inventor/Realsense/realsense/DS8480D-ASSM-MECH_00D1_OP_D6__1.ipt
cad/inventor/Realsense/realsense/DS8580B-ASSM-MECH_02_OP_D6__FOV.ipt
cad/inventor/Realsense/realsense/FAS000225_6.ipt
cad/inventor/Realsense/realsense/FAS000226_ASM_2_ASM.iam
cad/inventor/Realsense/realsense/FAS000227_ASM_2_ASM.iam
cad/inventor/Realsense/realsense/Intel_RealSense_D455_CAD_external_v2.iam
cad/inventor/Realsense/realsense/LEN000021_WITH_FOV_ASM_1_ASM_1__ASM.iam
cad/inventor/Realsense/realsense/MASK_LENS_COVER_D455_3.ipt
cad/inventor/Realsense/realsense/MD0645501_ASM_12_ASM.iam
cad/inventor/Realsense/realsense/MEC060019_1.ipt
cad/inventor/Realsense/realsense/MEC060304_3.ipt
cad/inventor/Realsense/realsense/MEC060308_5.ipt
cad/inventor/Realsense/realsense/MEC060309_ASM_5_ASM.iam
cad/inventor/Realsense/realsense/MEC060311_6.ipt
cad/inventor/Realsense/realsense/MEC060312_ASM_4_ASM.iam
cad/inventor/Realsense/realsense/MEC060313_2.ipt
cad/inventor/Realsense/realsense/MEC060314_5.ipt
cad/inventor/Realsense/realsense/MEC060316_8.ipt
cad/inventor/Realsense/realsense/MEC060318_11.ipt
cad/inventor/Realsense/realsense/MEC060319_2.ipt
cad/inventor/Realsense/realsense/SWEEP1_1.ipt
cad/inventor/Realsense/realsense/SWEEP1_1_2_3_1.ipt
cad/inventor/Realsense/realsense_backplate_bg.iam
cad/inventor/Scoomatic-Jetson/Bauteil2.ipt
cad/inventor/Scoomatic-Jetson/Wlan-antennen-halter.ipt
cad/inventor/Scoomatic-Jetson/jetson_deckel.ipt
cad/inventor/Scoomatic-Jetson/jetson_dummy.ipt
cad/inventor/Scoomatic-Jetson/klammern_usbc_hub.ipt
cad/inventor/Scoomatic-Jetson/scoomatic_halterung_bg.iam
