ll7/scoomatic-hoverboard/docs/projektmodul-mk/img/Hardware-Wiring.png

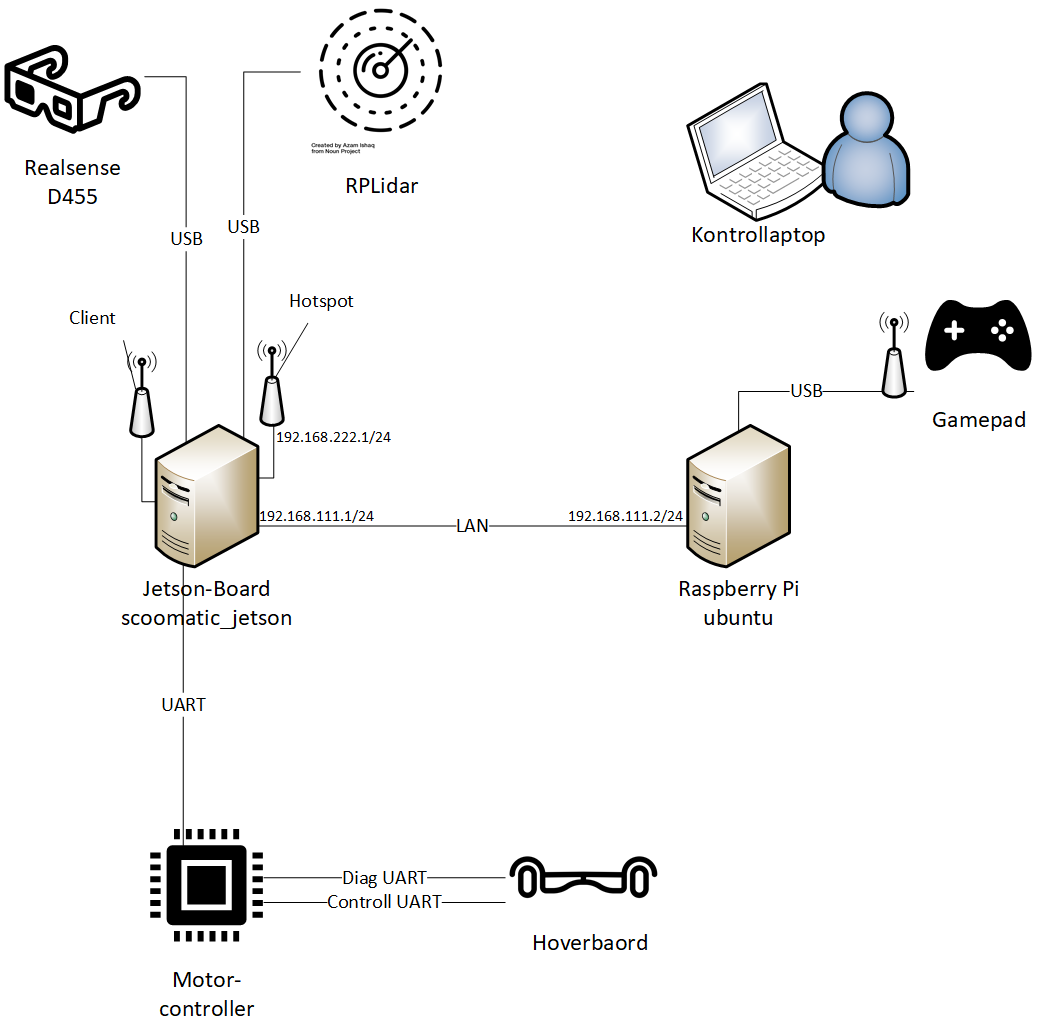
docs/projektmodul-mk/img/Hardware-Wiring.png
