ll7/scoomatic-hoverboard/docs/projektmodul-ms/images/program-verify.png

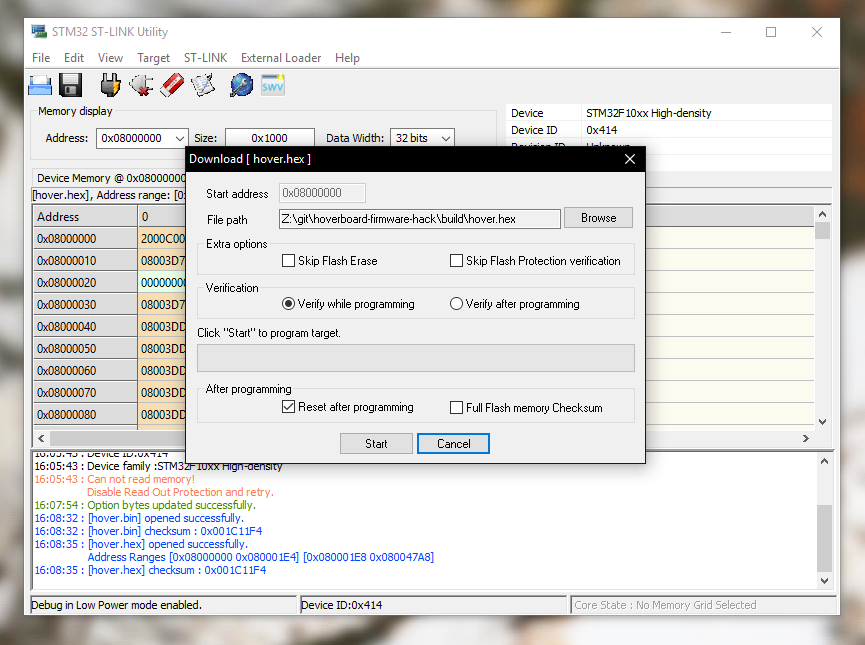
docs/projektmodul-ms/images/program-verify.png
