ll7/scoomatic-hoverboard/cad/schematics/sonar_schematic.pdf

## ARDUINONANO

G$1

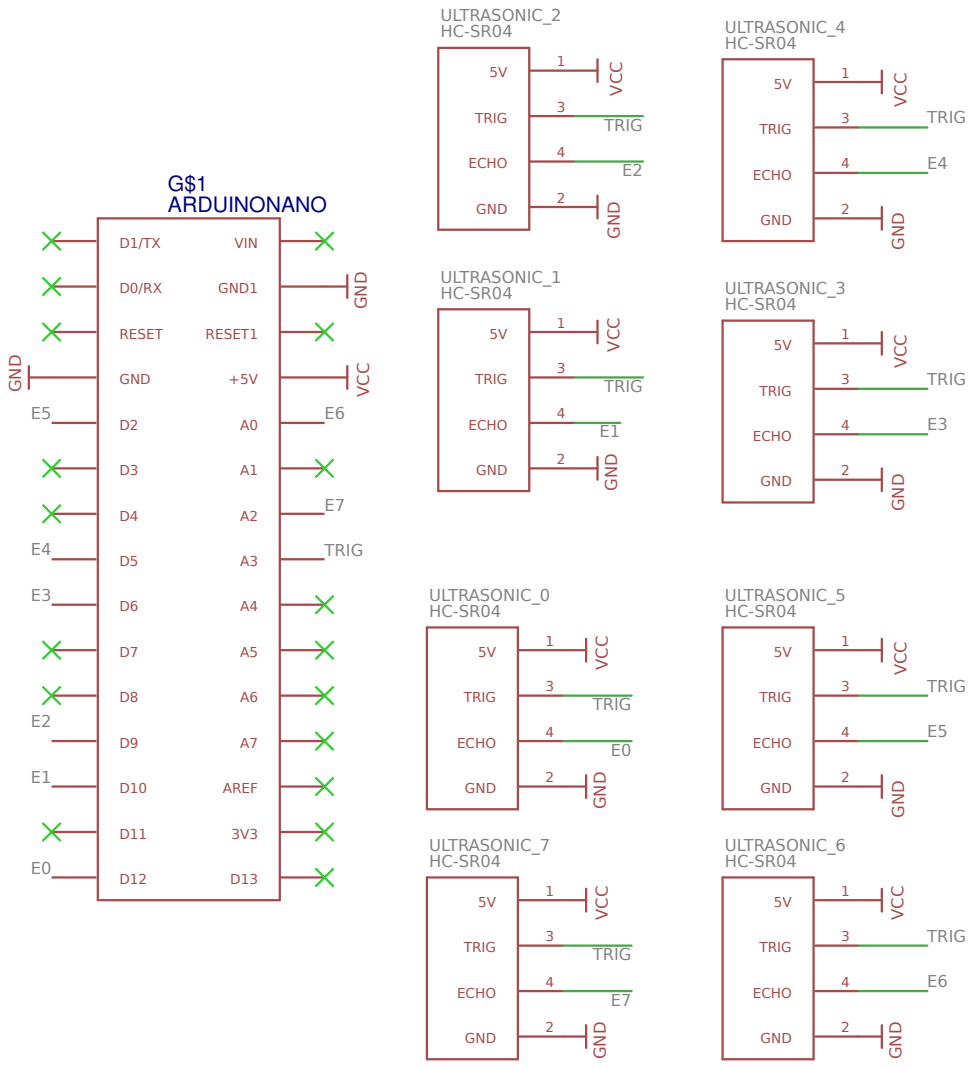
[picture p151: page 1]

VCC VCC VCC GND

VCC VCC
TRIG
