ll7/scoomatic-hoverboard/cad/schematics/sonar-pcb.pdf

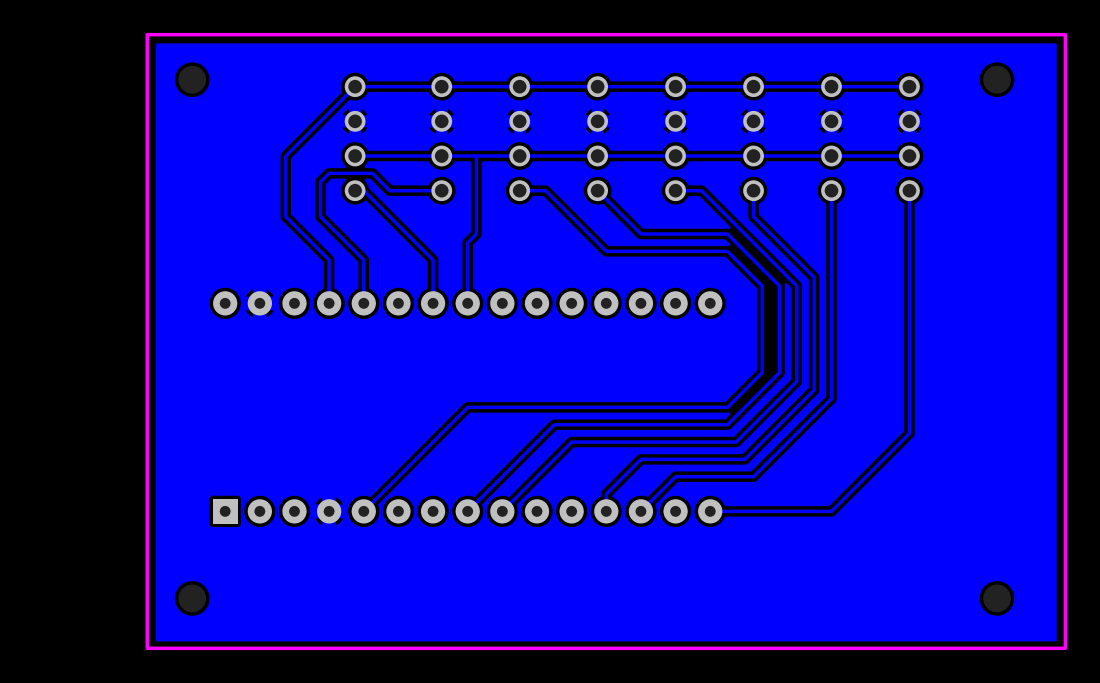
[picture p152: page 1]
