ll7/scoomatic-hoverboard/(list of files, drawings)

Other design files:
code/examples/hoverboard_stock_example/hoverboard_stock_example_schematic.fzz
code/examples/serial_hoverboard/serial_hoverboard_example_schematic.fzz
