ll7/scoomatic-hoverboard/cad/schematics/hoverboard_controller/motor_driver.sch

## KiCad design cad/schematics/hoverboard_controller/motor_driver.sch (2021-10-14)

Schematic: motor_driver.sch

Parts:
B1: A3213EUA-T; SIP3_11.6x8.5mm
D1: LED
J1: Conn_01x03
J2: Conn_02x03_Odd_Even
J3: Conn_01x05_Male
R1: 100kR
R2: 330R
U1: DC_DC_LM2596S_5V

Notes on the sheet:
Diagnose LED
Hall-Switch als Totmannschalter
Dead man's switch board/circuit
Master<->Motorcontroller UART
Hoverboard<->Motorcontroller UART + Power
IMU <-> Motorcontroller I2C + Power
