ll7/scoomatic-hoverboard/code/microcontroller/arduino firmware/scoomatic-sonar/scoomatic-sonar.ino

/*

This code is based on the SonicDisc Project by Dimitris Platis
(https://platis.solutions/blog/2017/08/27/sonicdisc-360-ultrasonic-scanner/)
It has been adapted to output the data via serial to the USB-port instead of i2c

Author: Martin Schoerner
Last Change: 2019-03-06
*/

#include <stdint.h>
#include "SonicSensor.h"

const uint8_t NUM_OF_SENSORS = 8; // The number of sonic sensors on the disc
// The pin to trigger an interrupt signal on the master MCU
// to indicate that a measurement is ready to be transmitted.
// It is set HIGH when there are data to be fetched and LOW otherwise.
const uint8_t INT_PIN = 0; // Note that this is also the RX pin
// The pin connected to the on-bard LED for debugging
const uint8_t LED_PIN = 1; // Note that this is also the TX pin
// How often the measurements should take place (in milliseconds)
const unsigned long MEASUREMENT_INTERVAL = 500;



// ISR vectors
enum Vector {
  VECTOR_0, // PCINT0_vect
  VECTOR_1, // PCINT1_vect
  VECTOR_2 // PCINT2_vect
};

// The Sonic Disc pin mapping of sensors
// Sonic Sensors are defined as SonicSensor(trigger pin, echo pin)
SonicSensor sensors[NUM_OF_SENSORS] = {
 SonicSensor(A3, A2),  // Ultrasonic_0 on the Sonic Disc
  SonicSensor(A1, A0),  // Ultrasonic_1
  SonicSensor(13, 12),  // Ultrasonic_2
  SonicSensor(11, 10),  // Ultrasonic_3
  SonicSensor(8, 9),    // Ultrasonic_4
  SonicSensor(7, 6),    // Ultrasonic_5
  SonicSensor(4, 5),    // Ultrasonic_6
  SonicSensor(3, 2) // Ultrasonic_7
};

int mapping[NUM_OF_SENSORS] = {2,3,4,5,6,7,1,0};

/**
   Handles the echo signal from an ultrasonic sensor.
   To be called from within an interrupt, it checks all the echo
   pins to see if any of them is HIGH or LOW and updates the echo
   pulse times of the respective sensor.
   If a pulse has already been set, then the new value is ignored.
   @param intVector The vector that the interrupt originated from
*/
void handleEcho(Vector intVector) {
  // Determine which vector the interrupt originated from
  // so we only check signals from those specific sensors
  int sensorsInVector[3] = {0}; // We have up to 3 sensors in each vector
  switch (intVector) {
    case VECTOR_0:
      // Ultrasonics 2, 3, 4 are on PCINT0_vect
      sensorsInVector[0] = 2;
      sensorsInVector[1] = 3;
      sensorsInVector[2] = 4;
      break;
    case VECTOR_1:
      // Ultrasonics 0, 1 are on PCINT1_vect
      sensorsInVector[0] = 0;
      sensorsInVector[1] = 1;
      sensorsInVector[2] = 1; // For simplicity
      break;
    case VECTOR_2:
      // Ultrasonics 5, 6, 7 are on PCINT2_vect
      sensorsInVector[0] = 5;
      sensorsInVector[1] = 6;
      sensorsInVector[2] = 7;
      break;
    default:
      break; // We should not be here
  }

  // Iterate through the specific vector's ultrasonic echo pins
  for (int i : sensorsInVector) {
    // If a pin is HIGH, it means that a pulse
    // is either just starting or has previously started.
    // We only care about the former.
    if (digitalRead(sensors[i].getEchoPin()) == HIGH) {
      // We only care for newly generated pulses and not ones
      // we have handled before.
      if (sensors[i].getStartOfPulse() == 0) {
        sensors[i].setStartOfPulse(micros());
      }
    } else {
      // If a pin is LOW, it means that a pulse has just ended,
      // has already ended or not started. We only care about
      // the first case. We can determine this by pulses which
      // we have not handled before AND that have already started
      if (sensors[i].getEndOfPulse() == 0 && sensors[i].getStartOfPulse() != 0) {
        sensors[i].setEndOfPulse(micros());
      }
    }
  }
  
}

/**
   Hook for pin change interrupt of PCINT0 vector
   Pins: D8 to D13
*/
ISR (PCINT0_vect) {
  handleEcho(VECTOR_0);
}

/**
   Hook for pin change interrupt of PCINT1 vector
   Pins: A0 to A5
*/
ISR(PCINT1_vect) {
  handleEcho(VECTOR_1);
}

/**
   Hook for pin change interrupt of PCINT2 vector
   Pins: D0 to D7
*/
ISR (PCINT2_vect) {
  handleEcho(VECTOR_2);
}

/**
   Method to set up change interrupt for the specified pin
   @param pin The Arduino-like name of the pin
*/
void setupChangeInterrupt(uint8_t pin) {
  pinMode(pin, INPUT);
  // Enable interrupt for pin
  *digitalPinToPCMSK(pin) |= bit(digitalPinToPCMSKbit(pin));
  // Clear any outstanding interrupt
  PCIFR |= bit(digitalPinToPCICRbit(pin));
  // Enable interrupt for the pin's group
  PCICR |= bit(digitalPinToPCICRbit(pin));
}

/**
   Check to see if it is OK to start a new cycle of measurements
   based on the current time and the measurement interval.
   @param  currentTime The current time in milliseconds to be compared
                       with the last time that a measurement took place.
   @return             True if is time to conduct a new measurement and
                       False otherwise
*/
bool isTimeToMeasure(unsigned long currentTime) {
  static unsigned long previousMeasurement = 0;
  bool isGoodTimeToMeasure = false;
  if (currentTime - previousMeasurement >= MEASUREMENT_INTERVAL) {
    isGoodTimeToMeasure = true;
    previousMeasurement = currentTime;
  }
  return isGoodTimeToMeasure;
}

/**
   Will set all trigger pins to the specified state at once.
   @param signalState LOW
                      HIGH
*/
void setTriggerPinsTo(uint8_t signalState) {
  switch (signalState) {
    case LOW:
      PORTB &= B11010110; // Set pins 8, 11, 13 LOW
      PORTC &= B11110101; // Set pins A1, A3 LOW
      PORTD &= B01100111; // Set pins D3, D4, D7 LOW
      break;
    case HIGH:
      // Port B handles D8 to D13
      PORTB |= B00101001; // Set pins 8, 11, 13 HIGH
      // Port C handles A0 to A5
      PORTC |= B00001010; // Set pins A1, A3 HIGH
      // Port D handles D0 to D7
      PORTD |= B10011000; // Set pins D3, D4, D7 HIGH
      break;
    default:
      break;
  }
}

/**
   Triggers all sensors at once, using port manipulation for less
   computation cycles. This is done by sending a pulse with a width
   of 10 microseconds.
*/
void triggerSensors() {
  // Briefly set the trigger pins to LOW to get a cleaner signal
  setTriggerPinsTo(LOW);
  delayMicroseconds(3);

  // Set all ultrasonic trigger pins to HIGH at the same time
  setTriggerPinsTo(HIGH);
  // Keep the signal HIGH for 10 microseconds
  delayMicroseconds(10);

  // Set the trigger pins back to LOW
  setTriggerPinsTo(LOW);
}

/**https://platis.solutions/blog/2017/08/27/sonicdisc-360-ultrasonic-scanner/
   Run once on boot or after a reset
*/
void setup() {
  // Set up ultrasonic sensor pins
  for (int i = 0; i < NUM_OF_SENSORS; i++) {
    // Set up change interrupts for all the echo pins
    setupChangeInterrupt(sensors[i].getEchoPin());
    // Set up all trigger pins as outputs
    pinMode(sensors[i].getTriggerPin(), OUTPUT);
  }

  // Set up the interrupt signal and led pins
  pinMode(LED_PIN, OUTPUT);

  Serial.begin(115200);
}

/**
   Run continuously after setup()
*/
void loop() {
  if (isTimeToMeasure(millis())) {

    // Disable the interrupts so we can prepare to calculate
    // the distances and then we are ready to start a new
    // set of measurements.
    noInterrupts();             // Begin critical section
    for (int i = 0; i < NUM_OF_SENSORS; i++) {
      // Copy the (volatile) start and end times of the pulses
      // so that we can begin immediately measuring again,
      // while distances of the (now previous) measurements are
      // being calculated.
      sensors[i].prepareToCalculate();
      // Then reset previous the echoes so we can
      // conduct new measurements
      sensors[i].reset();
    }
    // Finally start a new set of measurements
    // by triggering all sensors at once
    triggerSensors();
    interrupts();               // End critical section

   // delay(500); // TODO Remove
    // Now that we are certain that our measurements are consistent
    // time-wise, calculate the distance.
    for (int i = 0; i < NUM_OF_SENSORS; i++) {
      // Calculate distance for each sensor.
      // Will also timeout any pending measurements
      if(i!=0){Serial.print(";");}
      Serial.print(sensors[mapping[i]].calculateDistance());

    }

    Serial.println();

  }
}
