ll7/scoomatic-hoverboard/(commit log)

2019-01-29 + example code for driving hoverboard motors with stock firmware
2019-01-30 + Documentation Hoverboard Teardown + Empfohlene Antriebsplattformen ausformuliert
    [einkaufsliste.ods]
2019-01-31 + schematics for example code
    [hoverboard_stock_example_schematic.fzz, serial_hoverboard_example_schematic.fzz]
2019-01-31 Updated Shoppinglist
    [einkaufsliste.ods]
2019-02-06 + single board computers + sensors
2019-02-12 Cleanup Einkaufsliste. Fertig für Bestellung Elektroteile
    [einkaufsliste.ods]
2019-02-12 Bestellstatus angepasst für Conrad must-have
    [einkaufsliste.ods]
2019-02-16 Updated Einkaufsliste
    az und roboshop bestellt
    [einkaufsliste.ods]
2019-02-28 Update Einkaufsliste um "Geliefert"
    [einkaufsliste.ods]
2019-03-11 seminar und projektmodul aufgeteilt
2019-03-29 einkaufsliste aktualisiert
    [einkaufsliste.ods]
2019-04-02 fixed broken bosch basket
    [einkaufsliste.ods]
2019-04-05 Update Bestellstatus Conrad
    [einkaufsliste.ods]
2019-04-08 Update Bestellungen
    [einkaufsliste.ods]
2019-04-18 Added Sonar Sensor Firmware
2019-04-18 + ROS1 Driver for motors
2019-04-18 + Sonar Sensor ROS2 Driver
2019-04-23 Update Lidar Vergleich
2019-04-26 update sonar driver
2019-05-21 + Loch Aluprofil
    [30mm Hole.dxf]
2019-06-25 gamepad driver now working with usb controller
2019-06-28 Updated gamepad_driver and motor_driver
2019-06-28 fixed order of sonar sensors
    [scoomatic-sonar.ino]
2019-06-28 update shoppinglist
    [einkaufsliste.ods]
2019-06-28 added some stls
    [Charger Bracket v2.stl, Joystick mount v1.stl, PSU Bracket v1.stl, Power PCB Bracket v1.stl, RPI PSU Bracket v1.stl, RPLIDAR Bracket v5.stl, Scoomatic Spacer v1.stl, Sonar Bracket v1.stl]
2019-07-01 fixed joy driver, now tested and working
2019-07-01 + doku imu
2019-07-05 update sonar
2019-07-05 + Motor driver doku
2019-07-09 + präsentation
    [Charger Bracket v2.stl, Power PCB Bracket v1.stl, RPI PSU Bracket v1.stl, RPLIDAR Bracket v5.stl, Scoomatic Spacer v1.stl, Sonar Bracket v1.stl, Sonar PCB Bracket v1.stl, Switch Bracket v2.stl]
2019-07-11 Änderungen Probepräsentation
2019-07-11 + gps sensor python script
2019-07-11 I am gonna build my own GPS driver! With Blackjack and Hookers
2019-07-11 + launchfile imu
2019-07-11 Update IMU Launch file
2019-07-11 cleanup, update Präsentation
    [30mm Hole.dxf]
2019-07-13 +fusion files
    [Charger Bracket v3.f3d, Hoverboard Final v3.f3z, Hoverboard Sketch v6.f3d, Joystick mount v1.f3d, M8 Spacer v1.f3d, PSU Bracket v1.f3d, Power PCB Bracket v2.f3d, RPI PSU Bracket v1.f3d]
2019-07-13 + schematics sonar
2019-07-15 update drivers
2019-10-29 update übersicht
    [30mm Hole.dxf, Charger Bracket v2.stl, Charger Bracket v3.f3d, Hoverboard Final v3.f3z, Hoverboard Sketch v6.f3d, Joystick mount v1.f3d, Joystick mount v1.stl, M8 Spacer v1.f3d]
2019-11-18 change device ports & new notes
2019-11-27 get ready for motor_driver
2019-11-27 externalize get_param, new joy driver, updated motor driver, fixed launchfile
2019-11-27 fixed sleep & added interruption
2019-12-02 [ROS1] added motor diag py
2019-12-02 [ROS1|Feature] added gamepad driver
2019-12-03 [ROS1] added sonar driver
2019-12-03 [LAUNCH] add sonar driver
2019-12-03 [LAUNCH] add missing params
    [gamepad_driver.py]
2019-12-03 [GAMEPAD] get correct buttons
    [gamepad_driver.py]
2019-12-03 [GAMEPAD] try to fix Saitek gamepad
    [gamepad_driver.py]
2019-12-10 [GAMEPAD/MOTOR_DRIVER] update gamepad
2019-12-10 [GAMEPAD/MOTOR] next test + gamepad topic change to cmd_vel
2019-12-10 try to rewrite MOTOR DRIVER
2019-12-10 [NEW MOTORDRIVER] test via struct.pack & Serial
2019-12-10 [MOTOR DRIVER] new motor driver
2019-12-10 bugfixing on motor driver
2019-12-10 [GAMEPAD/MOTORDRIVER] update small things
2019-12-10 [GAMEPAD&MOTORDRIVER] finally working
2019-12-12 Titel Vorschlag und Aufgabenbeschreibung
2020-01-14 [NODES] Correct terminating behaviour
    [gamepad_driver.py]
2020-01-14 correct copy paste mistake
    [gamepad_driver.py]
2020-01-16 Motor security built in now (hopefully) + updates notes
2020-01-16 Restructering project
    [30mm Hole.dxf, Charger Bracket v2.stl, Charger Bracket v3.f3d, Hoverboard Final v3.f3z, Hoverboard Sketch v6.f3d, Joystick mount v1.f3d, Joystick mount v1.stl, M8 Spacer v1.f3d]
2020-01-23 Fix umlaut bug in gamepad python
    [gamepad_driver.py]
2020-01-23 motordriver bugfix
2020-01-23 replace time.sleep() with rospy.sleep()
    [gamepad_driver.py]
2020-02-04 odometry doc
2020-02-05 [DOC] calculate velocity via odometry
2020-02-05 [DOC&LAUNCH]describe angular velocity
2020-02-08 [FILES] move einkaufsliste
    [einkaufsliste.ods]
2020-02-10 [CODE] bugfix stamp not in Twist msg
    [gamepad_driver.py, odom_publisher.py]
2020-02-10 [BUGFIX] initializatin of time corrected
    [odom_publisher.py]
2020-02-10 [BUGFIX] calculate v every time
    [odom_publisher.py]
2020-02-10 [BUGFIX] changfe topic name of motor speed
    [odom_publisher.py]
2020-02-12 [CODE] deactivate joystick & sonic drivers / improve lidar paramters
2020-02-24 [CODE&DOC] update &fix navigation & rviz
    [odom_publisher.py]
2020-02-25 [LAUNCH] changed LIDAR scan mode to Boost
2020-02-27 [NAVIGATION] correct global frame
2020-03-02 [LAUNCH] rotate laser scan data
2020-03-02 [LAUNCH] correct rotation of laser frame
2020-03-04 [LOCAL_PLANNER] improve velocity commands
2020-03-07 [URDF] add first urdf prototype
    [scoomatic-model.urdf]
2020-03-07 [URDF] add RobotModel and suited rviz files
    [scoomatic-model.urdf, scoomatic.urdf]
2020-03-07 [URDF+LAUNCH] changed static tf publisher to urdf
    [scoomatic.urdf]
2020-03-07 [URDF] corrected link origin to joint origin
    [scoomatic.urdf]
2020-03-07 [LAUNCH] start urdf model with scoomatic_ros1
2020-03-07 [URDF] rotate laser
    [scoomatic.urdf]
2020-03-07 [DOC] add urdf support
2020-03-08 [SONAR] fix bug where frame id were not set + new iamges
    [odom_publisher.py]
2020-03-08 [SONAR] correct sonar PointCloud2 data structure
2020-03-08 [SONAR] small bug fix
2020-03-09 [SONAR] corrected PointField fields creation
2020-03-09 [SONAR] bug fix import
2020-03-09 [SONAR] use functions of point cloud2
2020-03-09 [SONAR] improve list concatination
2020-03-09 [ODOM] replace rotation with Imu data
    [odom_publisher.py]
2020-03-09 [ODOM] correct startup bug
    [odom_publisher.py]
2020-03-10 [JOY] improve joy driver
2020-03-10 [BUGFIX] bugs and code style improvement of drivers
    [gamepad_driver.py]
2020-03-10 [LAUNCH] deactivate joy driver
2020-03-10 [ODOM] disable imu data and replace with highpass odom filter
    [odom_publisher.py]
2020-03-10 [ODOM/DOC] update todos and filter out low velocities
2020-03-11 [DOC] new images and deactivated hector imu attidue
2020-03-11 [ODOM] bug fix: parameter
    [odom_publisher.py]
2021-10-14 Add changes from markus
    [10137062C_1_1_1.ipt, 10137062C_1_ASM_2_ASM.iam, 91732A181_ASM_1_ASM.iam, 91732A649_ASM_1_ASM.iam, AM0600115_INT_REV01_2_SW0001_1.ipt, AM0600115_REV01_ASM_EXTERNA-255_ASM.iam, AM0600115_REV01_ASM_EXTERNA-517_ASM.iam, AM0600131_ASM_2_ASM.iam]
