ll7/scoomatic-hoverboard/docs/projektmodul-mk/img/platine.jpg

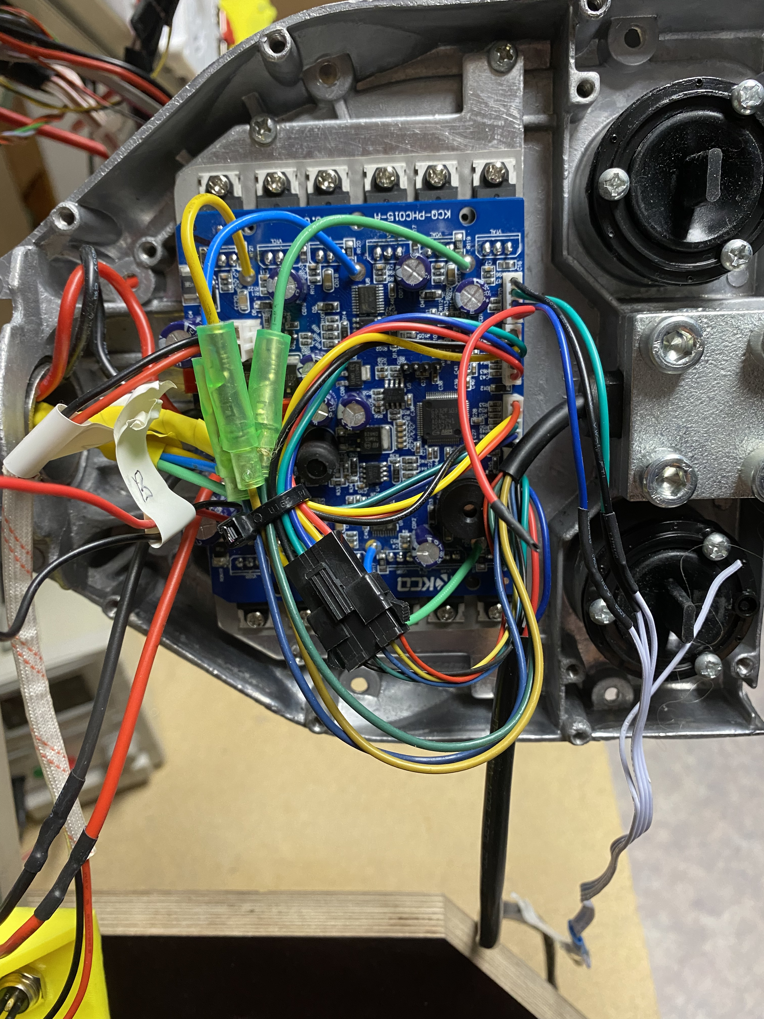
[picture p1: docs/projektmodul-mk/img/platine.jpg]
docs/projektmodul-mk/img/platine.jpg
