ll7/scoomatic-hoverboard/docs/projektmodul-mk/img/motor_controller_unten.jpg

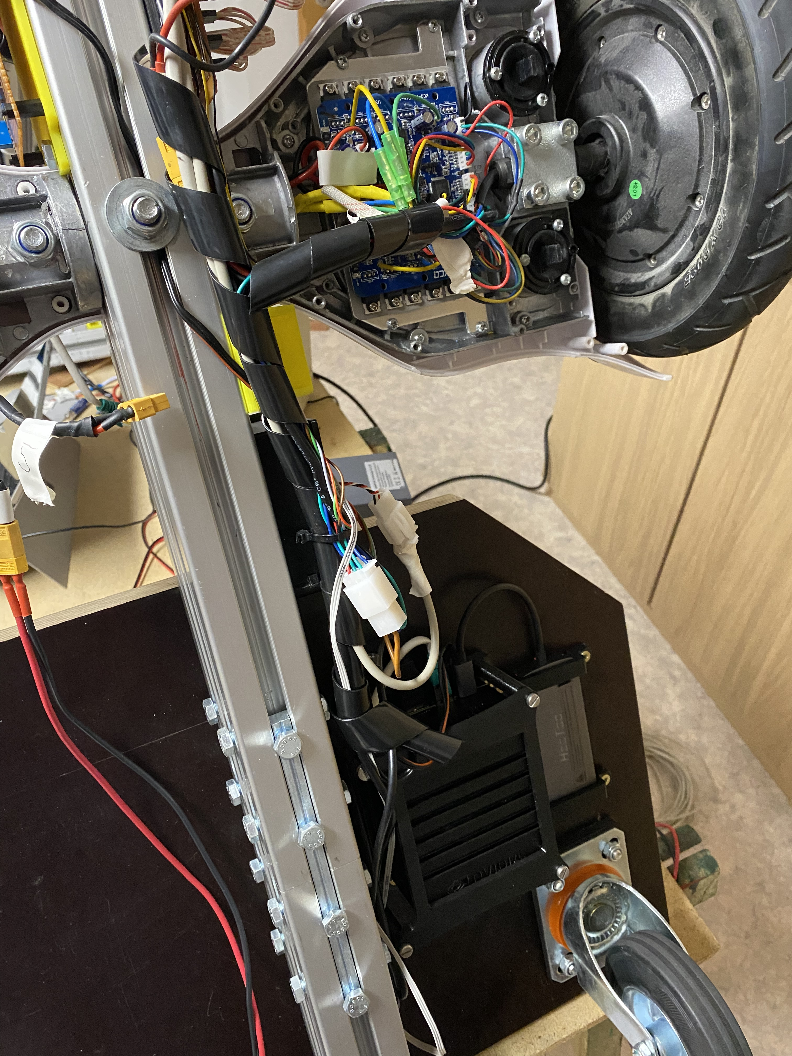
docs/projektmodul-mk/img/motor_controller_unten.jpg
