ll7/scoomatic-hoverboard/docs/projektmodul-mk/img/platine_tausch_markierungen.jpg

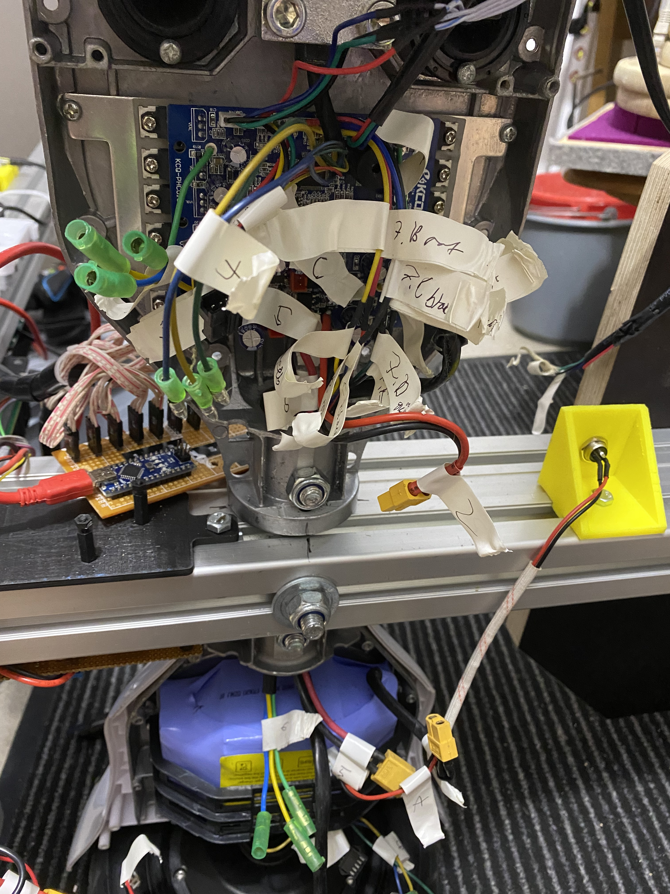
docs/projektmodul-mk/img/platine_tausch_markierungen.jpg
